konstantindenerz/k0d3ball35/README.md

# k0d3ball35

Read: **kodeball35**.

Designed and built by [Konstantin Denerz](https://konstantin-denerz.com) ·
[project page](https://konstantin-denerz.com/k0d3ball35/)

k0d3ball35 (kodeball35) is a wireless, low profile, 35-key split keyboard with an integrated 19 mm trackball.
Keyball-inspired column stagger and thumb arc, Kailh Choc V1 hot-swap switches, a nice!nano v2
on each half, ZMK firmware, two flat angular PCBs (18 keys left, 17 keys right) and the ball in a
case pocket right beside the thumb keys.

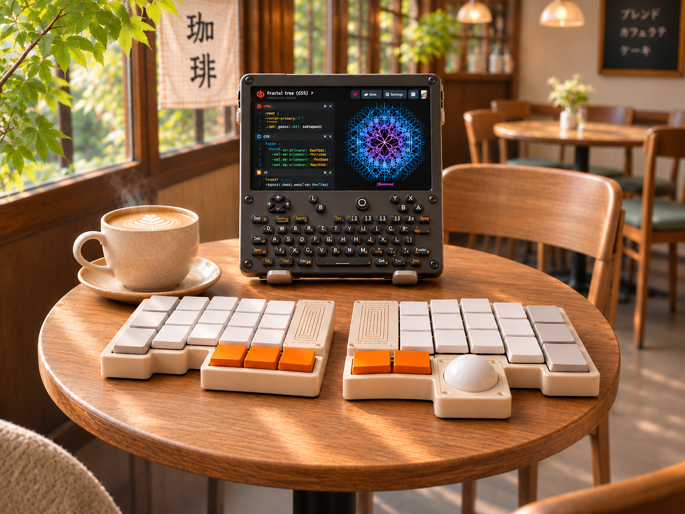
[picture p1: spec/images/concept-render.png]
k0d3ball35 concept render: both halves on a café table, trackball in the right half's case pocket


*Concept render, not a photo of a finished build.*

> ## ⚠️ Work in progress — do not build or order parts from this repository
>
> **k0d3ball35 is an unfinished design under active development. Nothing here has been
> manufactured, assembled or tested in hardware.**
>
> - No PCB in this repository has ever been fabricated, populated or electrically verified.
> - No case or cradle part has been printed and fit-checked against real switches, a real
>   trackball or a real battery.
> - Footprints, dimensions, the bill of materials and the firmware are all still changing, and
>   the geometry is revised between revisions without notice.
>
> **Do not send these gerbers to a fab, do not print these STLs, and do not buy components
> against this BOM.** If you do, you will very likely end up with parts that do not fit and
> money you cannot get back. Treat everything here as a design sketch to read, not a build
> guide to follow. Use at your own risk; there is no warranty of any kind.

## Status

| Subsystem | State | Where |
|---|---|---|
| Design specification | r2.4 (two PCBs, 35 keys, 19 mm ball pocket, battery bay under the controller on both halves) | [spec/01-design-spec.md](spec/01-design-spec.md) |
| Layout generator | r2.4 done, per-half outputs, exact coordinates in [spec/02-layout.md](spec/02-layout.md) | [hardware/layout](hardware/layout) |
| Left PCB (KiCad 10) | r2.4 routed, ERC and DRC clean, gerbers exported; battery bay on the back silkscreen | [hardware/left-pcb](hardware/left-pcb) |
| Right PCB (KiCad 10) | r2.4 routed, ERC and DRC clean, gerbers exported; battery bay on the back silkscreen | [hardware/right-pcb](hardware/right-pcb) |
| Trackball sensor | r2.4: bought PAW3222 module, no board of ours to fabricate; J1 re-ordered to the module's pinout | [spec/08-trackball-module.md](spec/08-trackball-module.md) |
| Trackball cradle | r2.4 pocket mount for 19.05 mm with the module tilted 65 degrees beside the ball, test print pending | [hardware/trackball-cradle](hardware/trackball-cradle) |
| Firmware (ZMK) | r2.4 in progress: 35 keys, one shared pin set | [firmware/zmk-config](firmware/zmk-config) |
| Documentation | build guide, firmware, fabrication, testing written for r2 | [docs](docs) |
| Case | printed tray, controller box cap, PCB guard, pocket cover and hinged lid per half (OpenSCAD); test print pending | [hardware/case](hardware/case), [spec/11-case.md](spec/11-case.md) |
| Tests and CI | pytest suite, workflows ready for GitHub | [tests](tests), [.github/workflows](.github/workflows) |

Open work is tracked as markdown tickets in [issues/](issues/README.md). The r2 change itself is
`hw-two-pcbs-r2`. Before the first PCB order, work through `hw-main-pcb-review-r1`,
`test-fab-gerber-viewer`, `hw-19mm-ball-sourcing` and a cradle test print (see
[spec/09-roadmap.md](spec/09-roadmap.md)).

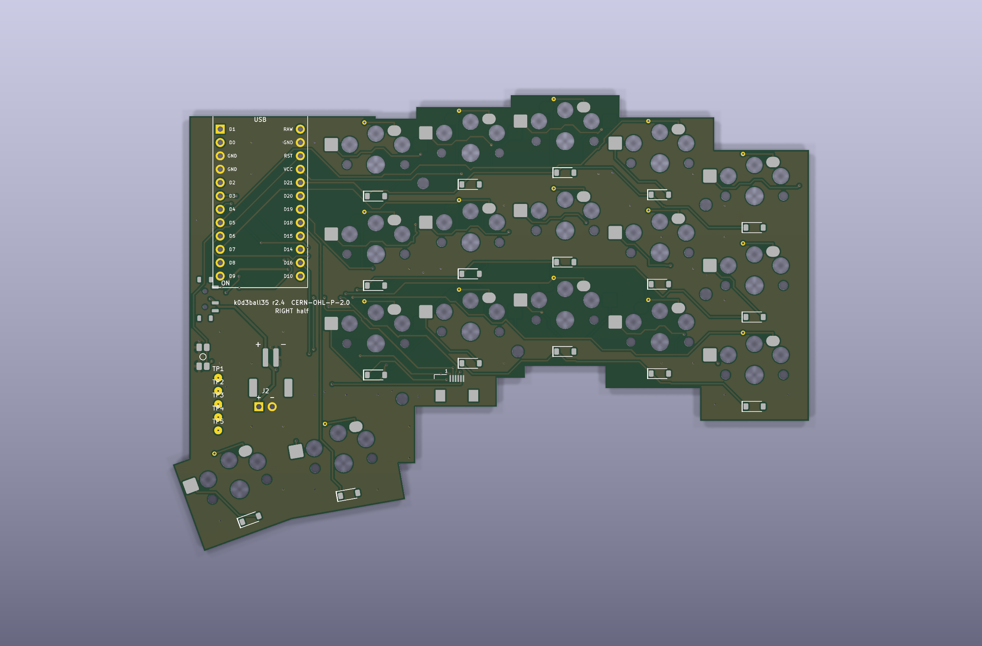
[picture p2: hardware/right-pcb/renders/right-pcb-top.png]
Right PCB, top


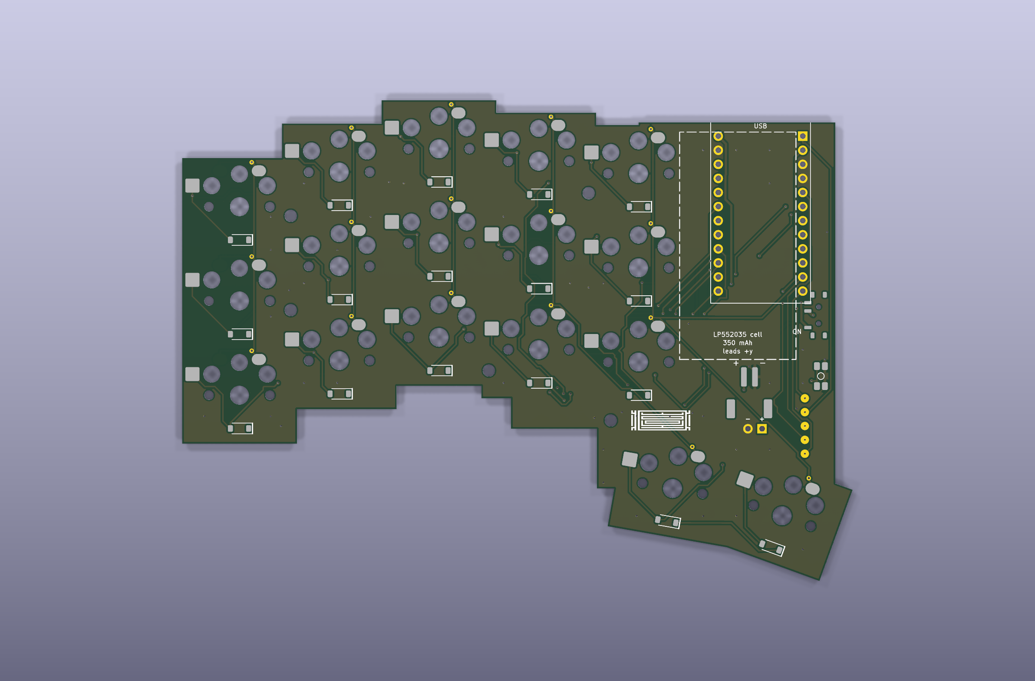
[picture p3: hardware/right-pcb/renders/right-pcb-bottom.png]
Right PCB, bottom


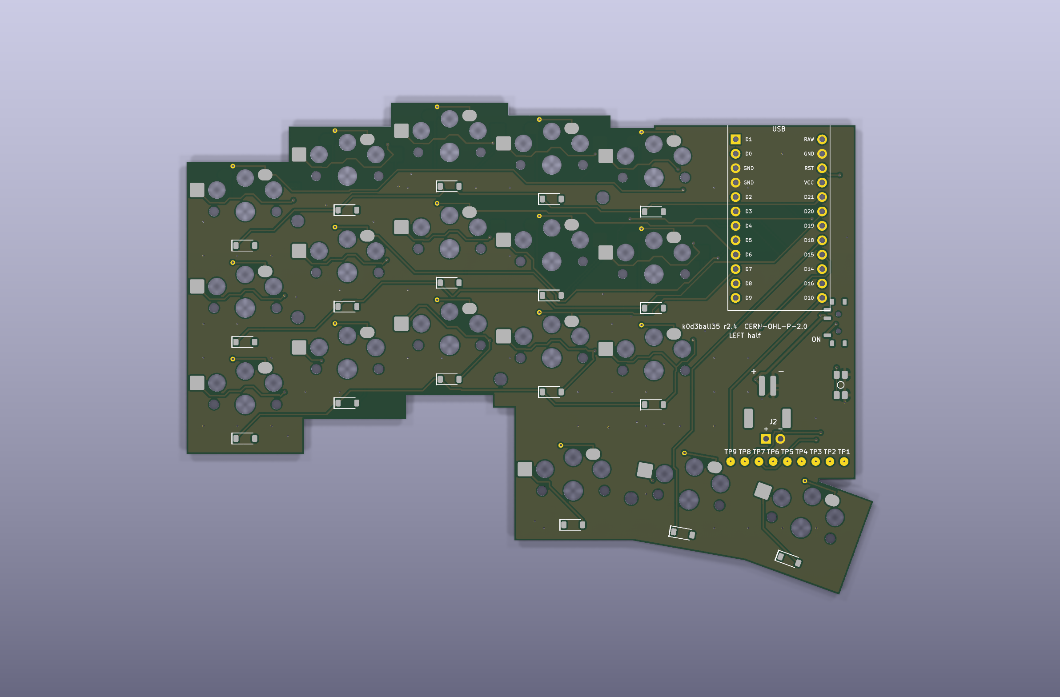
[picture p4: hardware/left-pcb/renders/left-pcb-top.png]
Left PCB, top


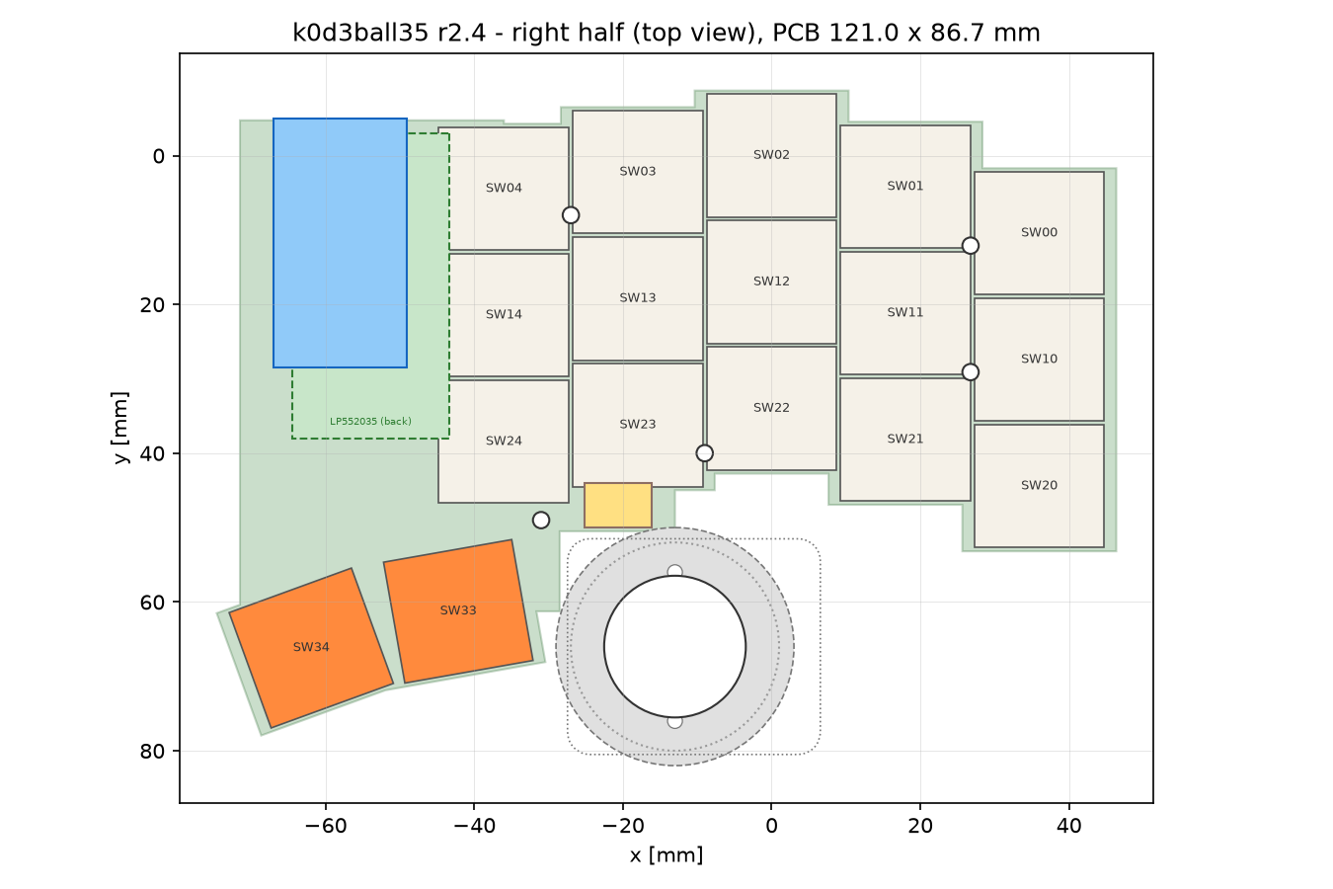
[picture p5: hardware/layout/output/preview-right.png]
Layout preview, right half


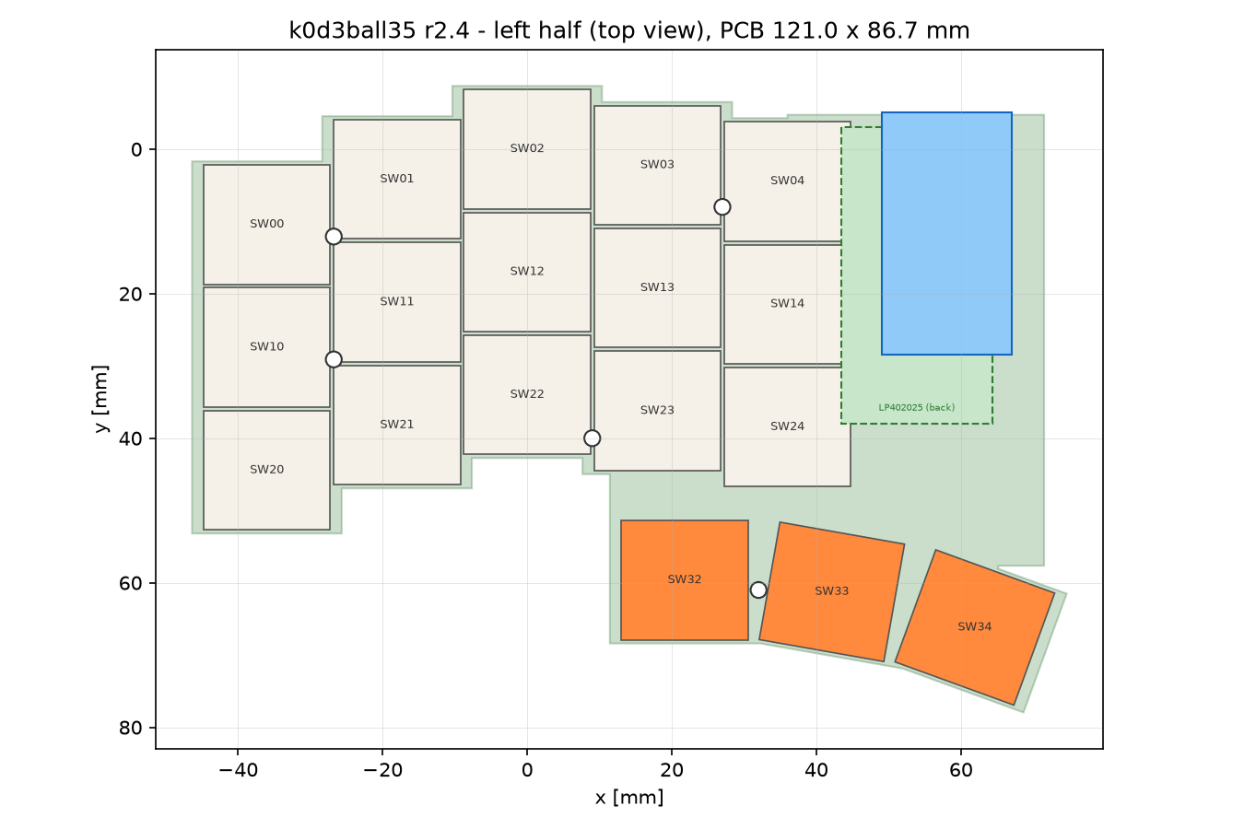
[picture p6: hardware/layout/output/preview-left.png]
Layout preview, left half


## Features

- 35 keys: 3 rows x 5 columns per half plus 3 thumb keys on the left and 2 on the right (the ball
  takes the third position), 18 x 17 mm pitch
- Column stagger and thumb arc derived from the Keyball39 geometry, scaled to Choc spacing
- Kailh Choc V1 switches in hot-swap sockets (hot-swap only, like the Keyball)
- 19.05 mm (3/4 inch) POM trackball on the right half, resting on three 2 mm ceramic balls in a
  printed cradle that stands in a case pocket beside the PCB; bought PAW3222 sensor module tilted
  65 degrees beside the ball, connected with a 6-pin flat cable
- Low: keycaps 20.8 mm over the desk, ball top 23.75 mm, 27.3 mm with the transport lid on
- Fully wireless: nice!nano v2 (or SuperMini nRF52840) per half on 2.5 mm low-profile sockets,
  Bluetooth split, one LiPo cell per half (350 mAh LP552035 right, 150 mAh LP402025 left) in a bay under the PCB below the
  controller (the same bay on both halves), the controller's charger, JST-PH connector, slide
  power switch, reset button
- Two separate PCBs with identical controller wiring: no solder jumpers, no mirrored pin maps,
  no empty ball cutout on the left
- Angular outline: 90 degree steps along the column stagger, rectangular controller block, no rounding
- No LEDs, display or encoder on the PCB, to keep the height and the power draw down
- ZMK firmware on a pinned `main` revision with the PAW3222 driver, automatic mouse layer,
  scroll and snipe modes, ZMK Studio
- All geometry comes from one layout file; schematic, PCB, footprints and tests are generated from the same data

## Repository map

```
spec/                 specification, layout, BOM, build guide, firmware, fabrication, testing
docs/                 the published project page (tabs: exploded view, case, trackball, PCBs, keymap, BOM)
hardware/layout/      layout source (yaml), generated points, outline DXFs and previews per half
hardware/left-pcb/    KiCad project of the left PCB (18 keys), gerbers and renders
hardware/right-pcb/   KiCad project of the right PCB (17 keys, FPC connector, pocket notch)
hardware/lib/         project symbol and footprint libraries
hardware/trackball-cradle/  parametric cradle (pocket mount), STL and floor-footprint DXF exports
hardware/case/        parametric printed case per half (tray, cap, guard, lid), STLs and previews
firmware/zmk-config/  ZMK shield, keymap, build matrix
scripts/              generators and checks (schematic, routing, export, tickets)
tests/                pytest suite incl. KiCad ERC/DRC gates
issues/               markdown tickets and the generated index
```

## Documentation

| Document | Content |
|---|---|
| [00 Feasibility](spec/00-feasibility.md) | prior art, ball size research, risks, licensing, why this design |
| [01 Design specification](spec/01-design-spec.md) | requirements, pin map, matrix, FPC interface, geometry contract |
| [02 Layout](spec/02-layout.md) | key coordinates per half, stagger derivation, ball pocket |
| [03 Bill of materials](spec/03-bom.md) | parts, quantities per half, sources |
| [04 Build guide](spec/04-build-guide.md) | step by step assembly |
| [05 Firmware](spec/05-firmware.md) | flashing, pairing, tuning, battery |
| [06 Fabrication](spec/06-fabrication.md) | PCB order settings for both boards, gerber checklist |
| [07 Testing](spec/07-testing.md) | automated checks and bench procedure |
| [08 Trackball module](spec/08-trackball-module.md) | sensor module, cable, heights, pocket mount |
| [09 Roadmap](spec/09-roadmap.md) | verification before ordering, case, dongle, sensor variants |
| [10 Lessons from Keyball](spec/10-lessons-from-keyball.md) | holykeebs and Yowkees designs, known weaknesses and our response |
| [11 Printed case](spec/11-case.md) | tray, controller box cap, ball pocket, hinged lid as transport cover and tenting foot |
| [12 Order checklist](spec/12-order-checklist.md) | shop-by-shop parts list, what is ordered, JLCPCB and LCSC lines, printed parts, what waits for hardware |
| [Image prompts](spec/images/PROMPTS.md) | every picture as a generation prompt |

## Project page

The project page, [`docs/index.html`](docs/index.html), is published with GitHub Pages from
`docs/` on `main`. One tab per area: an overview, the interactive 3D exploded view of both halves
(explode slider, half switch, section through the ball, lid modes), the real printed parts of the
case and the trackball cradle, the three boards in 3D and as layer plots and the keymap. The page
shows the files; the markdown keeps the details, and the overview links to it.

The page is static; every file it loads carries a content hash (`?v=`, stamped by `make site`), so a visit never mixes cached files of two versions. It shows the real files: STLs and the KiCad GLBs are fetched from the
repository (raw.githubusercontent.com, branch `main`), nothing is copied into `docs/`. The data the
tabs need (layout, part facts, keymap, board facts) is generated into `docs/data/` by
`docs/build.py`: run `make site` after a change to the layout, the case, the boards, the keymap,
the BOM or the tickets; `tests/test_site.py` fails while the data is stale. `make site-serve`
serves the page with the files of the working tree at http://localhost:8000/docs/, which previews
a branch before it is merged.

## Quick start

```sh
brew install --cask kicad          # KiCad 10.0.7 (copy the app from the DMG if the cask asks for admin rights)
brew install openjdk               # Java for freerouting
brew install --cask openscad@snapshot   # OpenSCAD with the manifold backend, for the case and cradle
uv venv .venv && uv pip install --python .venv/bin/python -e ".[test]"
make freerouting-jar               # downloads freerouting 2.5.0 to build/
make test                          # full test suite
```

## Build the hardware files

Everything under `hardware/left-pcb/` and `hardware/right-pcb/` is generated; edit
`hardware/layout/k0d3ball35.yaml` and `scripts/k0d3/` instead of the KiCad files.

```sh
make layout                                   # points-*.json, outline-*.dxf, previews for both halves
JAVA=/opt/homebrew/opt/openjdk/bin/java \
FREEROUTING_JAR=build/freerouting.jar \
make sch pcb route gerbers                    # both halves: schematic + ERC, PCB, freerouting, DRC, export
scripts/build_board.sh right                  # one half: schematic + ERC, unrouted PCB, freerouting, DRC (retries until clean)
scripts/export.sh right                       # one half: gerbers, drill, zip, STEP, renders, schematic PDF, BOM, position file
make erc drc                                  # the KiCad gates on their own
make -C hardware/trackball-cradle             # cradle STLs, floor DXF, previews, stack.json
make case-data case                           # hardware/case: data.scad from the layout, tray/cap/lid STLs, previews, stack.json (needs OpenSCAD)
```

`HALVES=right make route` limits the looping targets to one half. `scripts/build_board.sh` expects
`kicad-cli` and KiCad's bundled Python at
`/Applications/KiCad/KiCad.app/Contents/MacOS/kicad-cli` and
`/Applications/KiCad/KiCad.app/Contents/Frameworks/Python.framework/Versions/Current/bin/python3`;
override with `KICAD_CLI=` and `KPY=`. Since r2.4 the two halves are the only KiCad projects in
the repository: the trackball sensor is a bought PAW3222 module, so there is nothing to generate
or fabricate for it.

Firmware is built by GitHub Actions from `firmware/zmk-config`; see
[spec/05-firmware.md](spec/05-firmware.md) for local builds and flashing.

```prompt
Top-down studio render of the right half of a low profile split keyboard, white background, soft
shadows. Bare black PCB with an angular, stepped outline, 17 Kailh Choc hot-swap sockets, small
SOD-123 diodes next to each key, two thumb key positions at the lower inner side and the ball
pocket where a third would be, a nice!nano
controller on low profile sockets in a rectangular block at the inner edge, a dashed rectangle
printed on the board under it marking the battery bay on the other face, an octagonal notch in the lower outer edge of the board where a beige
printed cradle holding a white 19 mm ball stands beside the PCB, a tiny flat flex cable running
from the cradle round the cup to a connector on the PCB. Clean, technical, product photography style.
```

## Credits

- [Keyball](https://github.com/Yowkees/keyball) by Yowkees: the column stagger, thumb arc and the
  idea of a trackball at the thumb are the design inspiration. No Keyball files are used.
- [torabo-tsuki-lp](https://github.com/sekigon-gonnoc/torabo-tsuki-lp) by sekigon-gonnoc: reference
  for a low profile trackball with 25 and 19.05 mm POM balls and the PAW3222 module on a flat cable.
- [LiNEA40](https://github.com/keyfreaks/LiNEA40) by keyfreaks: precedent for a 19 mm ball on a PMW3610.
- [roBa](https://github.com/kumamuk-git/roBa) by kumamuk: reference for a ZMK trackball split with
  PMW3610.
- [kiswitch](https://github.com/kiswitch/kiswitch) and [marbastlib](https://github.com/ebastler/marbastlib):
  switch, socket and controller footprints.
- [ZMK](https://zmk.dev) and sekigon-gonnoc's PAW3222 driver (`zmk-driver-paw3222`).

```prompt
Three quarter view close-up of the trackball pocket on the right half: a matte white 19 mm ball
sitting low in a round pocket of a boxy beige 3D printed case, in line with two burnt orange thumb
keycaps to its left, the ball top only a little higher than the keycaps, three tiny ceramic balls just visible
at the rim of the beige cradle, light grey Choc keycaps behind, the angular stepped case edge
visible. Oak desk, soft daylight, macro lens, shallow depth of field.
```

## License

Copyright (c) 2026 Konstantin Denerz.

Firmware, scripts and documentation: [MIT](LICENSE).
Hardware (everything under `hardware/`): [CERN-OHL-P-2.0](LICENSE-HARDWARE).

The `kode` wordmark on the PCB silkscreen, the case and the project page is the author's mark and
is not covered by either licence; a fork keeps the design files and replaces the artwork. See
[NOTICE](NOTICE).
