konstantindenerz/k0d3ball35/docs/img/share-card-cafe.jpg

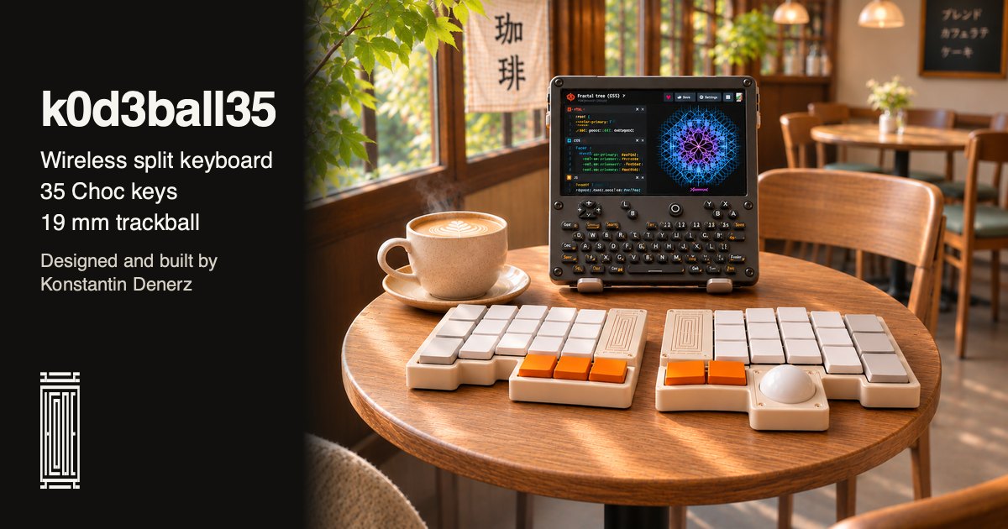
docs/img/share-card-cafe.jpg
