konstantindenerz/k0d3ball35/hardware/case/preview/box-right.png

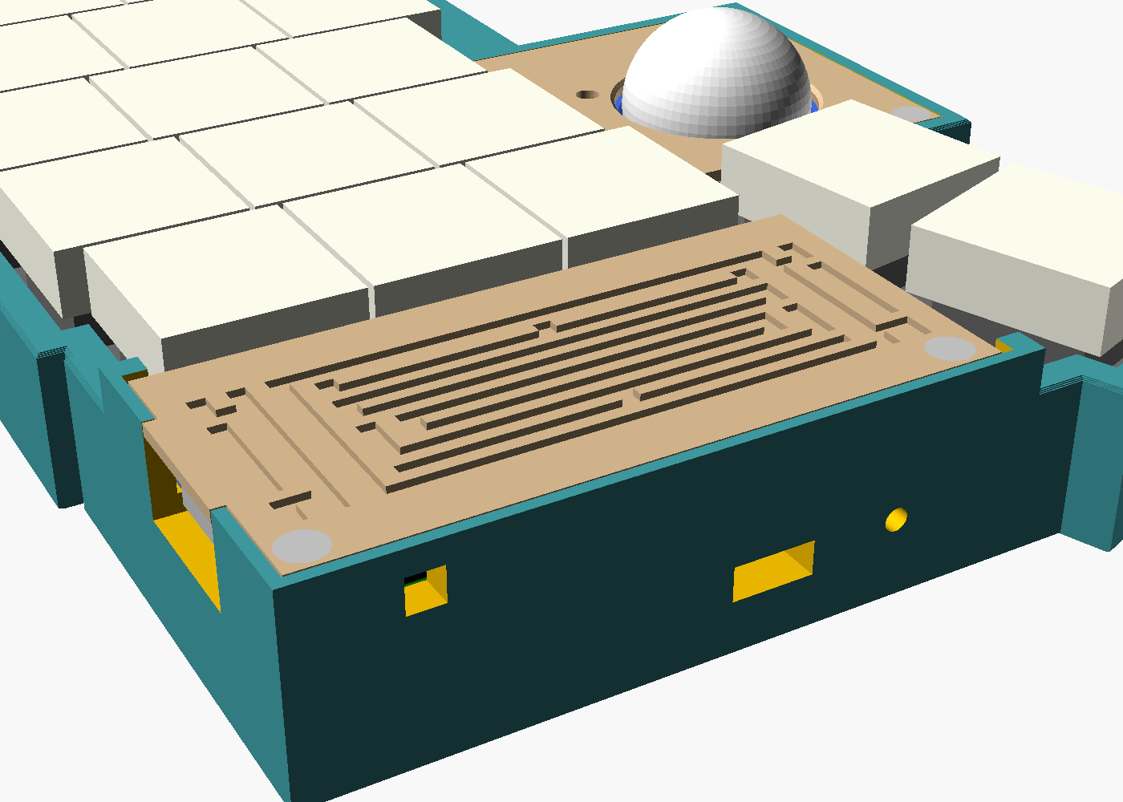
hardware/case/preview/box-right.png
