konstantindenerz/k0d3ball35/hardware/case/preview/clip-right.png

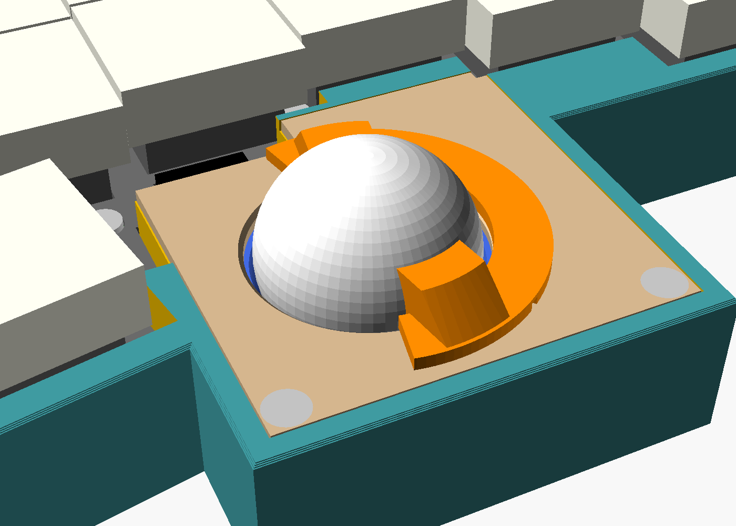
hardware/case/preview/clip-right.png
