konstantindenerz/k0d3ball35/hardware/case/preview/lid-folded-right.png

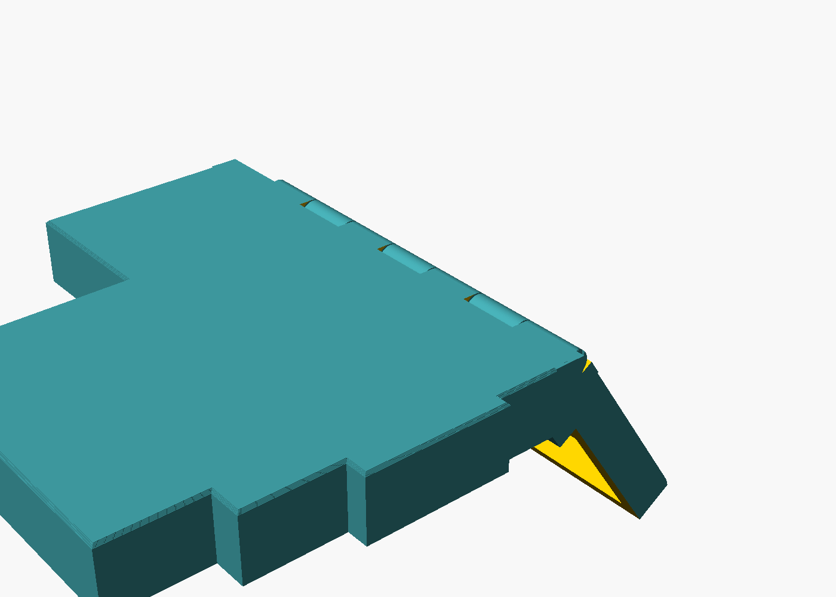
hardware/case/preview/lid-folded-right.png
