konstantindenerz/k0d3ball35/hardware/case/preview/lid-foot-right.png

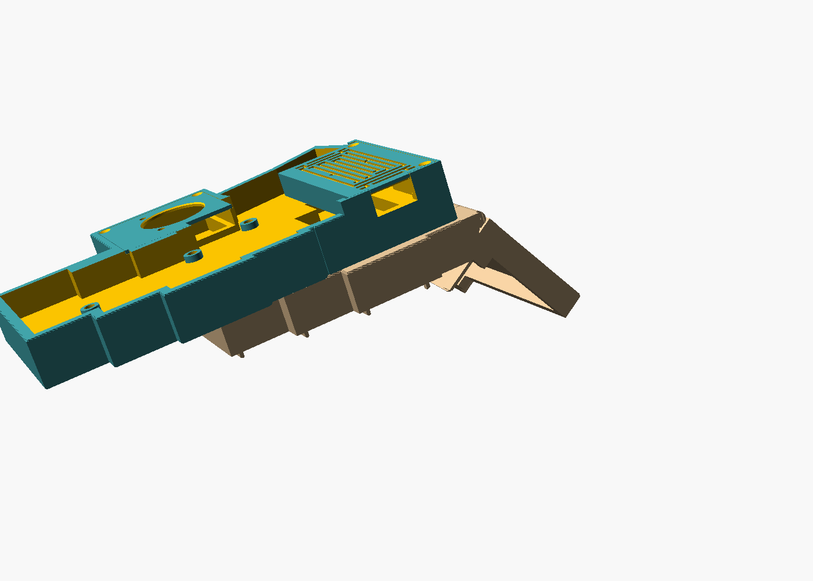
hardware/case/preview/lid-foot-right.png
