konstantindenerz/k0d3ball35/hardware/case/preview/lid-hinge-right.png

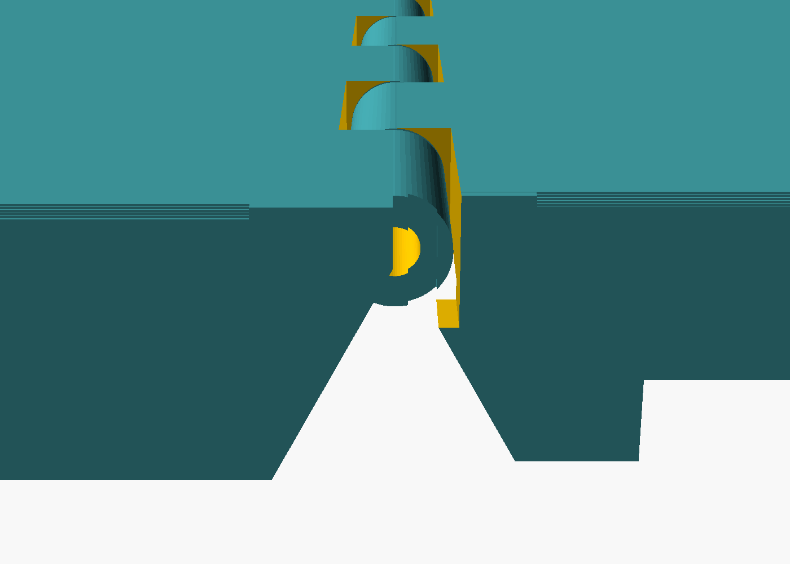
hardware/case/preview/lid-hinge-right.png
