konstantindenerz/k0d3ball35/hardware/case/preview/lid-on-right.png

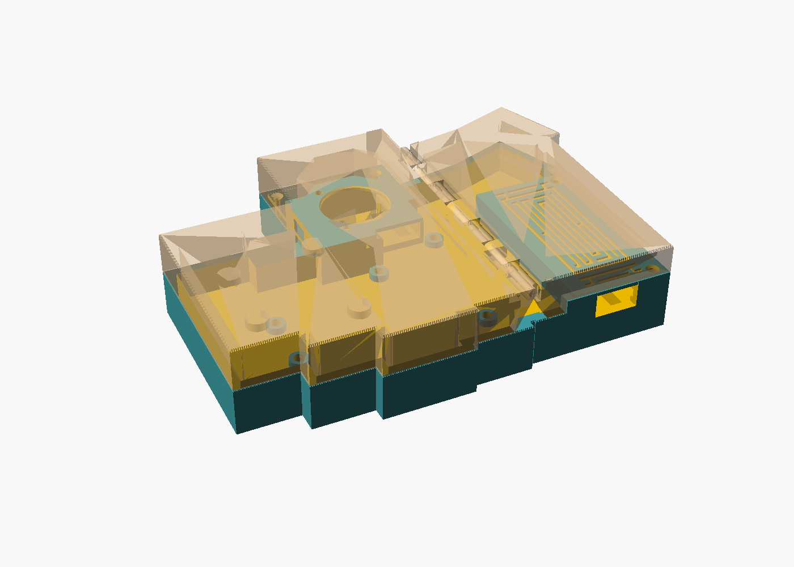
hardware/case/preview/lid-on-right.png
