konstantindenerz/k0d3ball35/hardware/case/preview/section-right.png

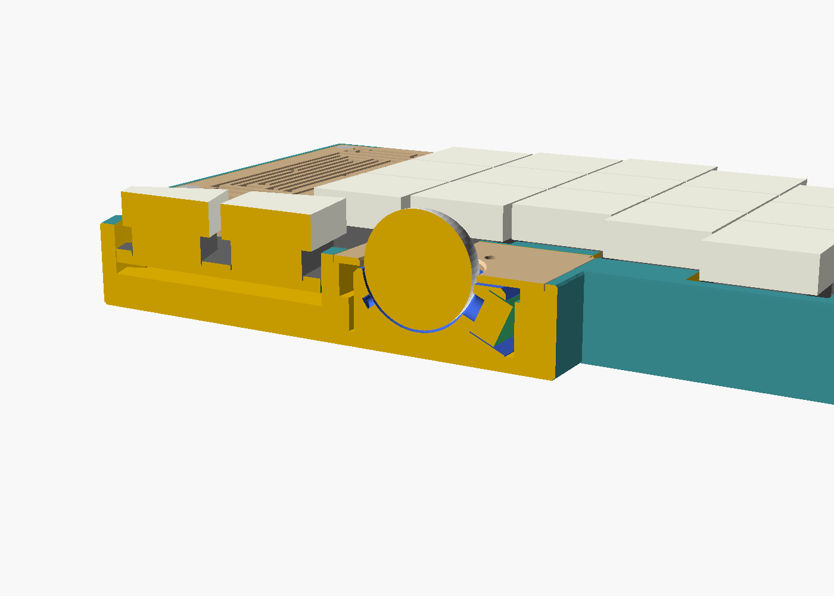
hardware/case/preview/section-right.png
