konstantindenerz/k0d3ball35/hardware/case/preview/tray-bottom-right.png

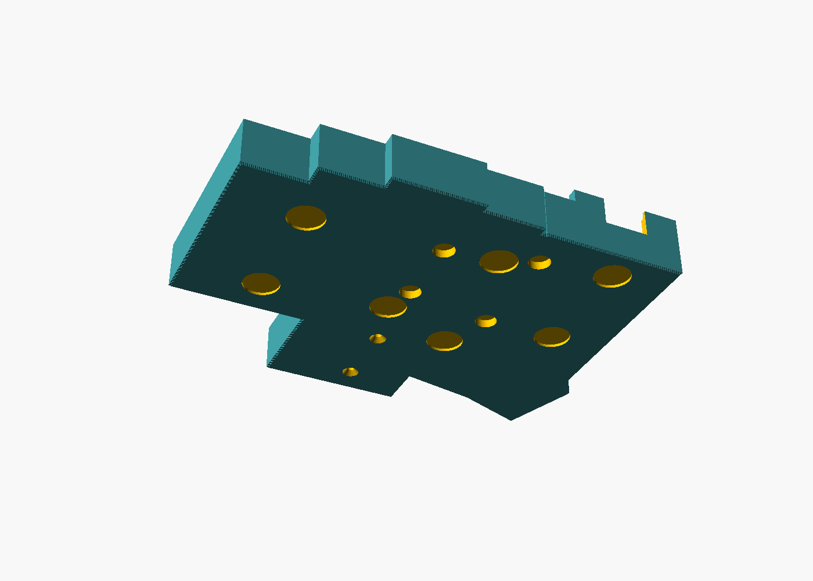
hardware/case/preview/tray-bottom-right.png
