konstantindenerz/k0d3ball35/hardware/left-pcb/renders/left-pcb-bottom.png

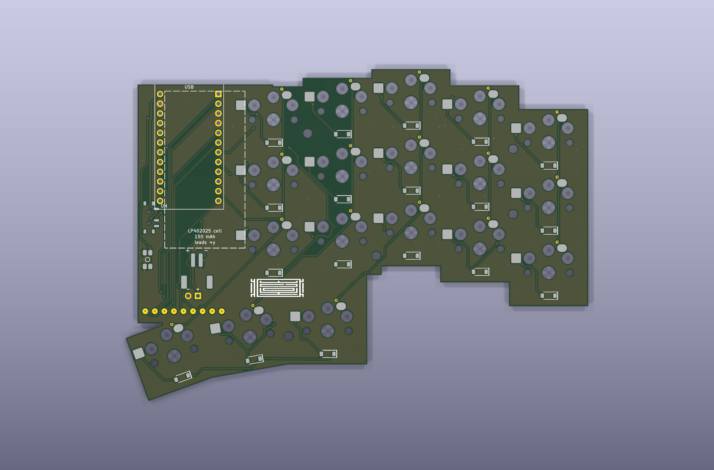
hardware/left-pcb/renders/left-pcb-bottom.png
