konstantindenerz/k0d3ball35/hardware/trackball-cradle/preview/cradle-19mm-pocket.png

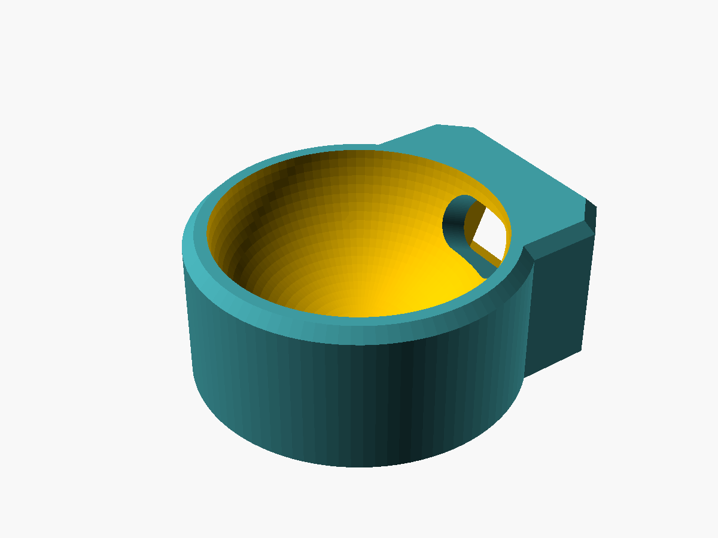
hardware/trackball-cradle/preview/cradle-19mm-pocket.png
