konstantindenerz/k0d3ball35/issues/hw-fpc-connector-bom-mismatch.md

---
title: BOM listed FH19SC while the footprint is FH12-6S
type: bug
priority: P2
status: done
area: hw
created: 2026-11-05
---

# BOM listed FH19SC while the footprint is FH12-6S

## Context

spec/03-bom.md listed the Hirose FH19SC-6S-0.5SH connector while both boards use the FH12-6S-0.5SH footprint (0.5 mm, 6 contacts, bottom contact, ZIF slider).

## Acceptance criteria

- [x] spec/03-bom.md names FH12-6S-0.5SH for both boards, LCSC equivalents allowed
- [x] spec/01-design-spec.md section 3 names the same family

## Notes

Fixed 2026-11-05.
