konstantindenerz/k0d3ball35/hardware/right-pcb/k0d3ball35-right-bom.csv

Reference | Value | Footprint | QUANTITY | Description
D00-D04,D10-D14,D20-D24,D33,D34 | 1N4148W | k0d3ball35:D_SOD-123_reversible | 17 | 1N4148W SOD-123, pads on both sides
J1 | FH12-6S-0.5SH | k0d3ball35:FPC_0.5mm_6P_FH12-6S_top | 1 | Trackball sensor module, 6-pin 0.5 mm FPC, top side
J2 | BAT | k0d3ball35:BatteryPads_2x1.8mm_P2.54mm | 1 | Battery solder pads, B+ / B-
J3 | S2B-PH-SM4-TB | k0d3ball35:JST_PH_S2B-PH-SM4-TB_reversible | 1 | Optional JST-PH 2.0 battery connector, bottom side
PS1 | MSK12C02 | k0d3ball35:SW_SPDT_MSK12C02_reversible | 1 | Power slide switch in the battery positive line, bottom side
RB1 | EVQ-P7A01P | k0d3ball35:SW_SPST_EVQP7A_reversible | 1 | Reset button, bottom side
SW00-SW04,SW10-SW14,SW20-SW24,SW33,SW34 | Choc V1 | k0d3ball35:SW_Choc_V1_HS_reversible | 17 | Kailh Choc V1 switch, hot-swap socket on the back
TP1 | TP_D0 | k0d3ball35:TestPad_1.5mm | 1 | Spare controller pin D0
TP2 | TP_D1 | k0d3ball35:TestPad_1.5mm | 1 | Spare controller pin D1
TP3 | TP_D2 | k0d3ball35:TestPad_1.5mm | 1 | Spare controller pin D2
TP4 | TP_D3 | k0d3ball35:TestPad_1.5mm | 1 | Spare controller pin D3
TP5 | TP_D9 | k0d3ball35:TestPad_1.5mm | 1 | Spare controller pin D9
U1 | nice!nano v2 | k0d3ball35:nice_nano_v2_THT | 1 | nice!nano v2 / SuperMini nRF52840 on 2.54 mm sockets, component side up, USB at the top
