konstantindenerz/k0d3ball35/hardware/case/stl/pcb-test-left.stl

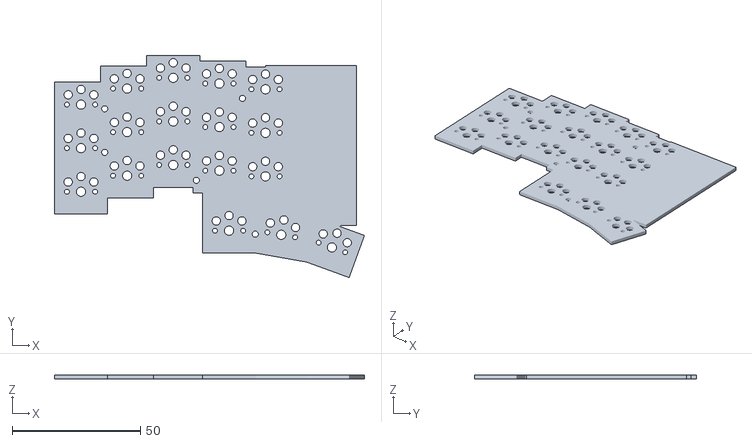
[picture p18: CAD file, 2026-11-12]
hardware/case/stl/pcb-test-left.stl
121.0 x 86.7 x 1.60
