konstantindenerz/k0d3ball35/hardware/layout/output/outline-right.dxf

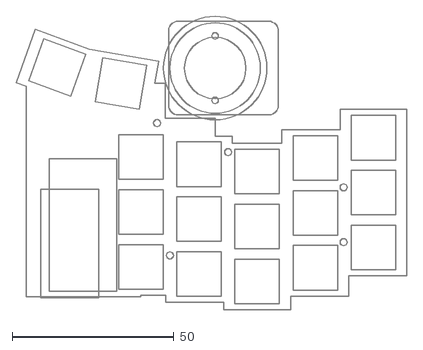
[picture p19: CAD file, 2026-11-12]
hardware/layout/output/outline-right.dxf
121.0 x 90.8
