konstantindenerz/k0d3ball35/hardware/left-pcb/k0d3ball35-left.step

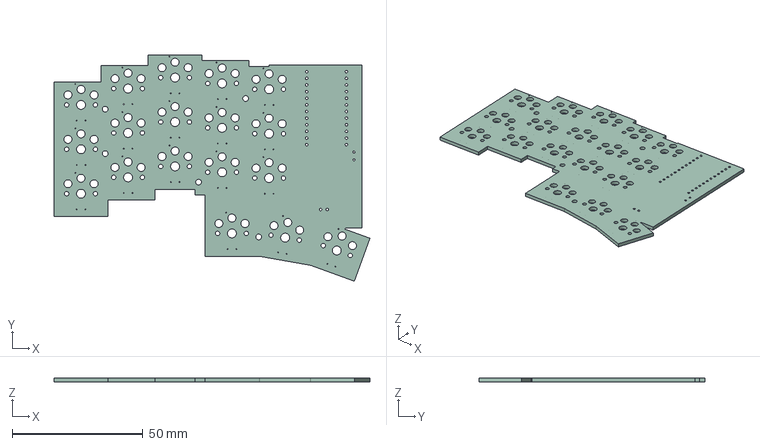
[picture p20: CAD file, 2026-11-12]
hardware/left-pcb/k0d3ball35-left.step
121.0 x 86.7 x 1.51 mm
