konstantindenerz/k0d3ball35/hardware/right-pcb/k0d3ball35-right.step

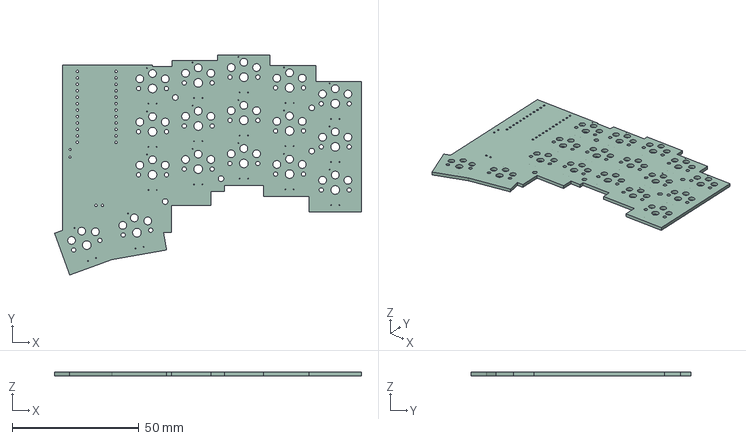
[picture p21: CAD file, 2026-11-12]
hardware/right-pcb/k0d3ball35-right.step
121.0 x 86.7 x 1.51 mm
