konstantindenerz/k0d3ball35/hardware/trackball-cradle/ref/sensor-module.stl

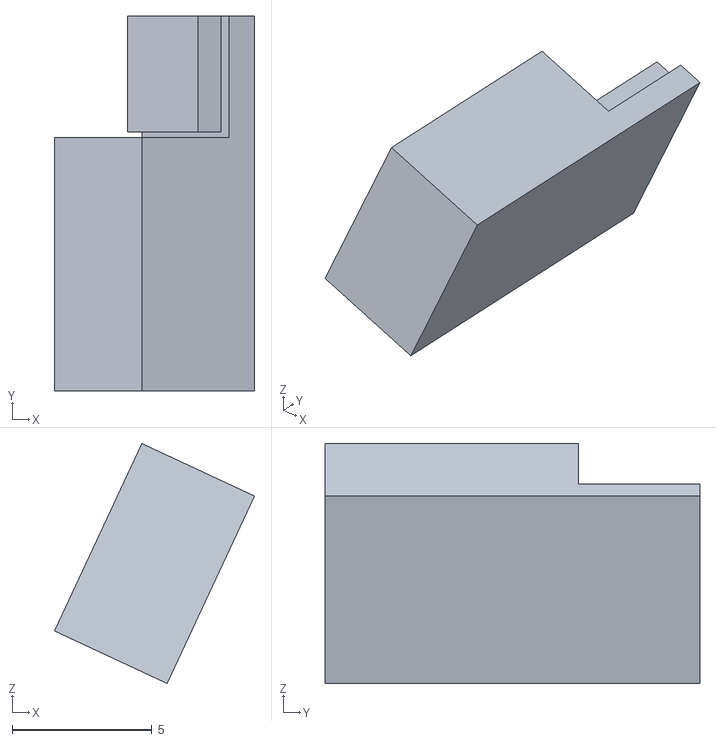
[picture p22: CAD file, 2026-11-12]
hardware/trackball-cradle/ref/sensor-module.stl
7.16 x 13.4 x 8.59
