konstantindenerz/k0d3ball35/hardware/trackball-cradle/stl/ball-19mm-test-half.stl

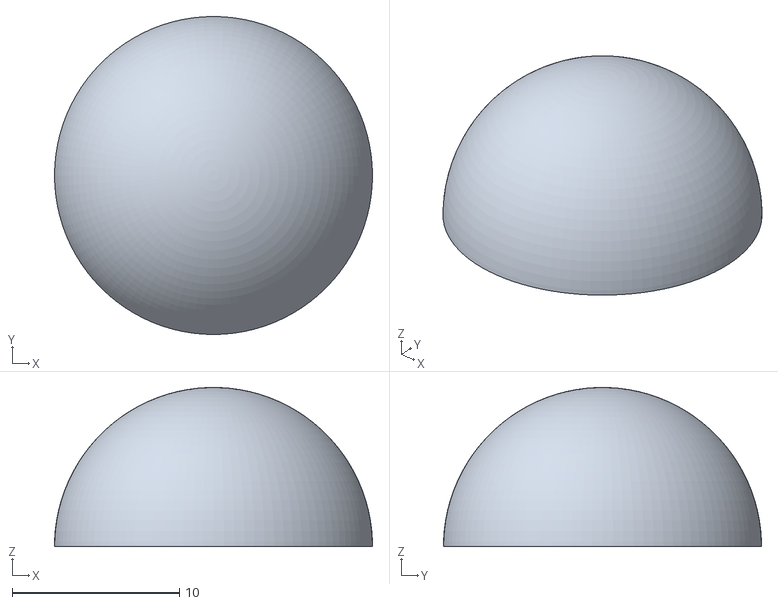
[picture p23: CAD file, 2026-11-12]
hardware/trackball-cradle/stl/ball-19mm-test-half.stl
19.0 x 19.0 x 9.52
