konstantindenerz/k0d3ball35/hardware/case/stl/pcb-test-right.stl

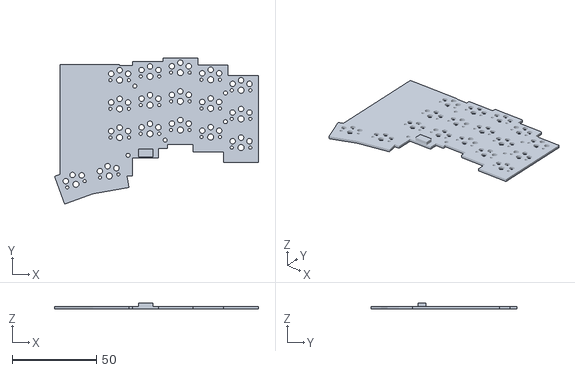
[picture p24: CAD file, 2026-11-12]
hardware/case/stl/pcb-test-right.stl
121.0 x 86.7 x 3.60
