konstantindenerz/k0d3ball35/hardware/layout/output/outline-left.dxf

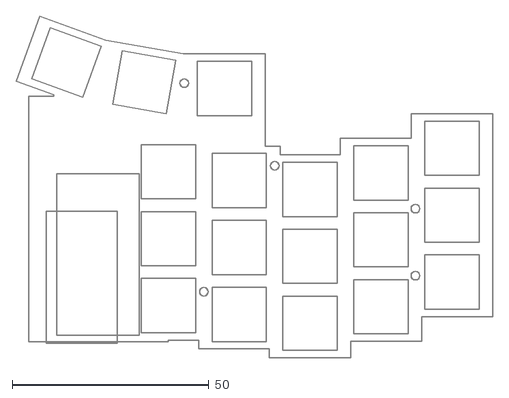
[picture p25: CAD file, 2026-11-12]
hardware/layout/output/outline-left.dxf
121.0 x 86.7
