konstantindenerz/k0d3ball35/hardware/trackball-cradle/stl/cradle-19mm-pocket.stl

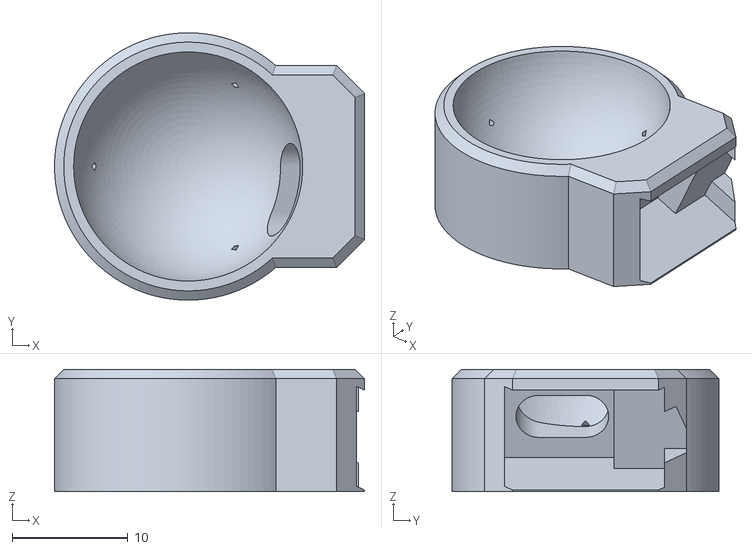
[picture p26: CAD file, 2026-11-12]
hardware/trackball-cradle/stl/cradle-19mm-pocket.stl
26.7 x 23.0 x 10.5
