konstantindenerz/k0d3ball35/hardware/case/stl/box-cap-left.stl

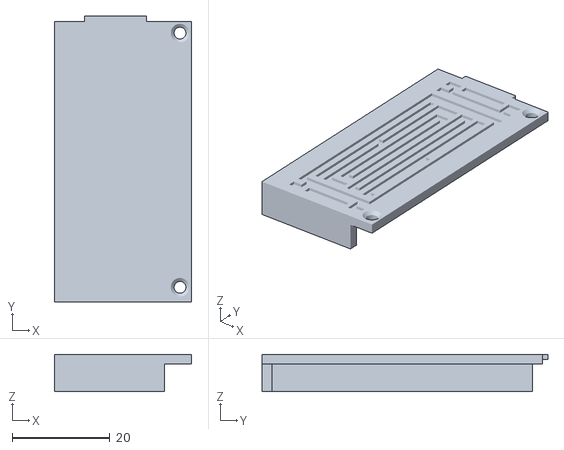
[picture p27: CAD file, 2026-11-12]
hardware/case/stl/box-cap-left.stl
28.0 x 58.6 x 7.60
