konstantindenerz/k0d3ball35/hardware/case/stl/tray-left.stl

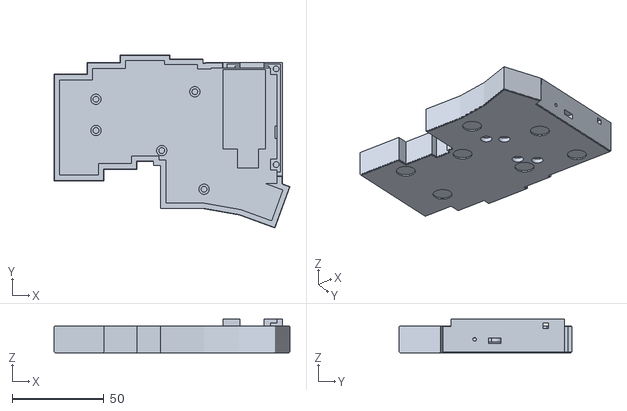
[picture p28: CAD file, 2026-11-12]
hardware/case/stl/tray-left.stl
128.3 x 94.0 x 18.3
