konstantindenerz/k0d3ball35/hardware/case/stl/tray-right.stl

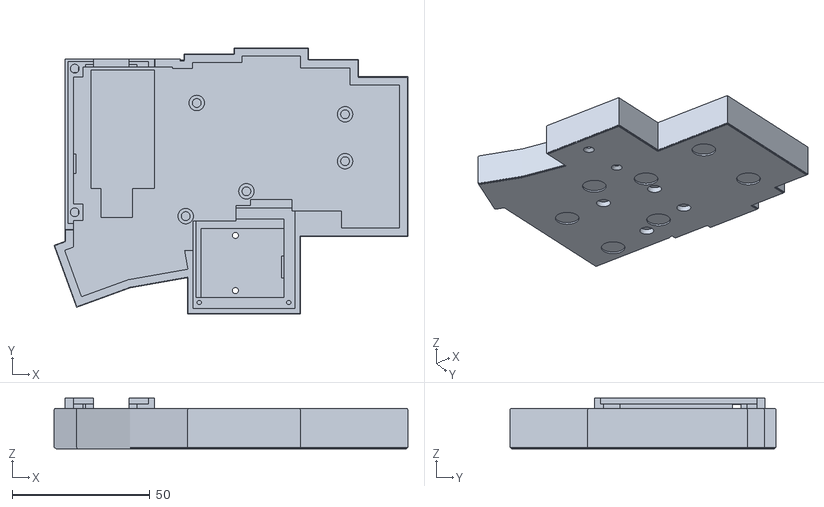
[picture p29: CAD file, 2026-11-12]
hardware/case/stl/tray-right.stl
128.3 x 96.5 x 18.3
