konstantindenerz/k0d3ball35/hardware/case/stl/lid-inner-right.stl

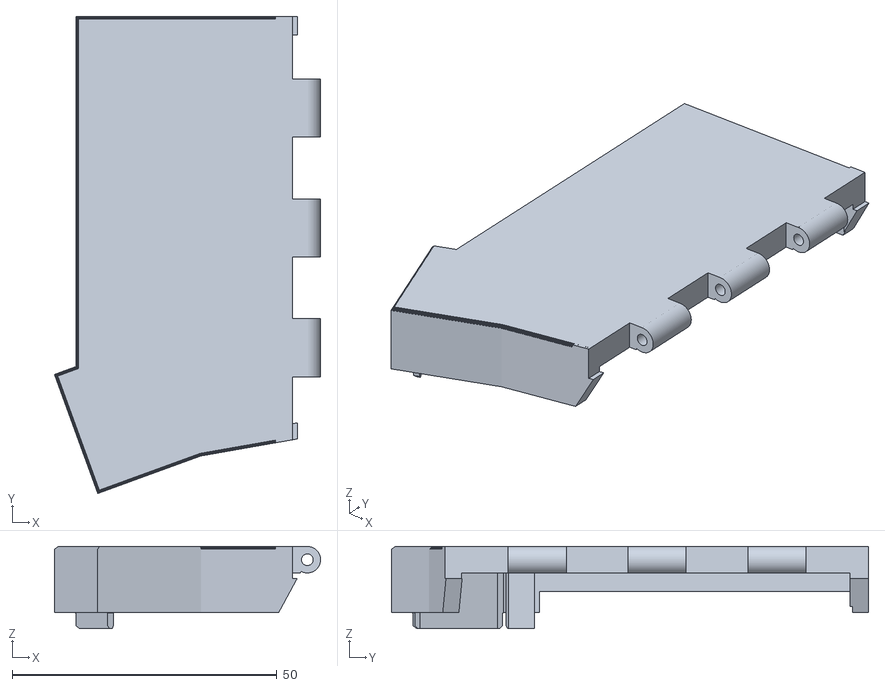
[picture p30: CAD file, 2026-11-12]
hardware/case/stl/lid-inner-right.stl
50.2 x 90.0 x 15.5
