konstantindenerz/k0d3ball35/hardware/case/stl/lid-folded-left.stl

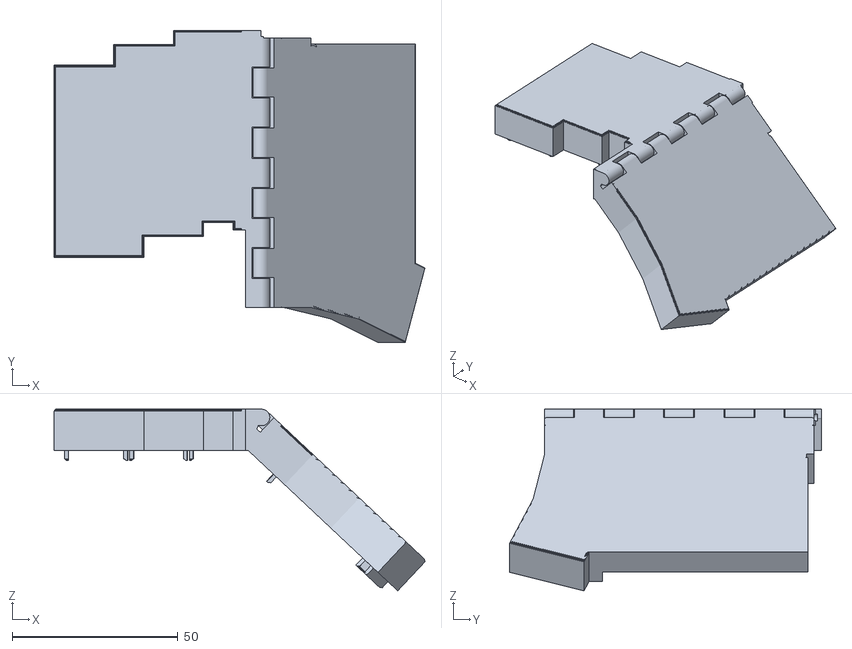
[picture p31: CAD file, 2026-11-12]
hardware/case/stl/lid-folded-left.stl
111.8 x 94.0 x 54.8
