konstantindenerz/k0d3ball35/hardware/case/stl/lid-outer-right.stl

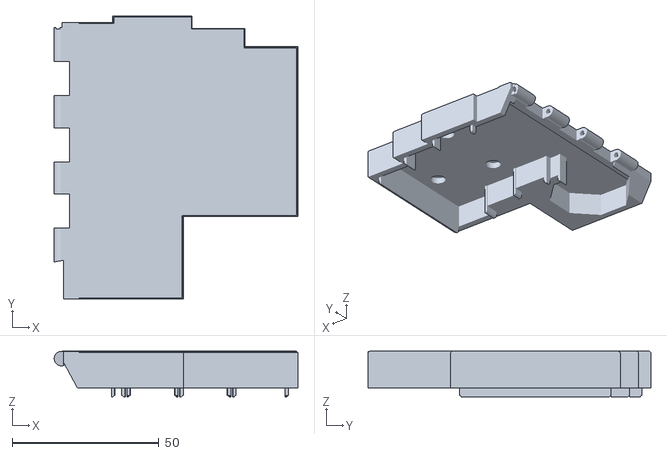
[picture p32: CAD file, 2026-11-12]
hardware/case/stl/lid-outer-right.stl
83.1 x 96.5 x 15.5
