konstantindenerz/k0d3ball35/hardware/case/stl/lid-left.stl

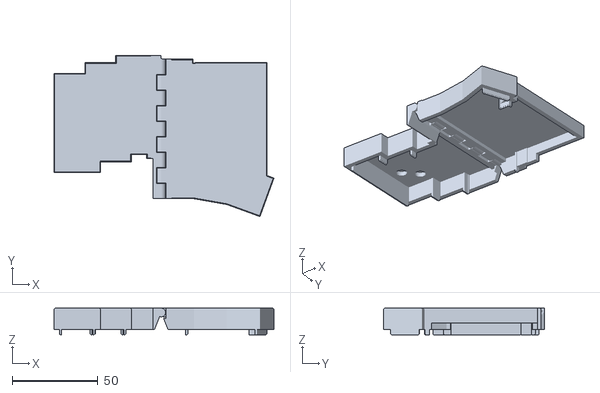
[picture p33: CAD file, 2026-11-12]
hardware/case/stl/lid-left.stl
128.3 x 94.0 x 15.5
