konstantindenerz/k0d3ball35/hardware/case/stl/lid-right.stl

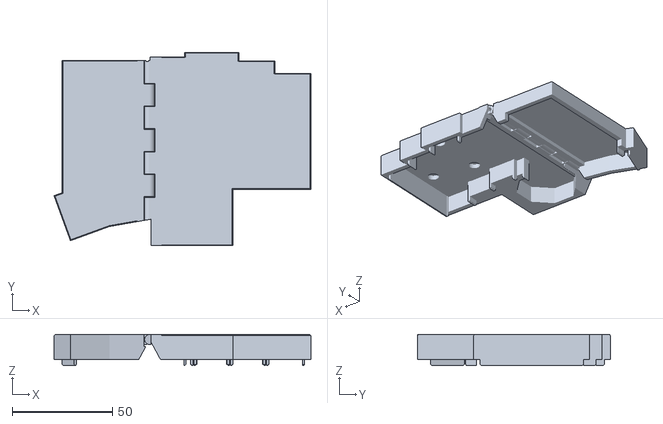
[picture p34: CAD file, 2026-11-12]
hardware/case/stl/lid-right.stl
128.3 x 96.5 x 15.5
