konstantindenerz/k0d3ball35/hardware/case/stl/lid-inner-left.stl

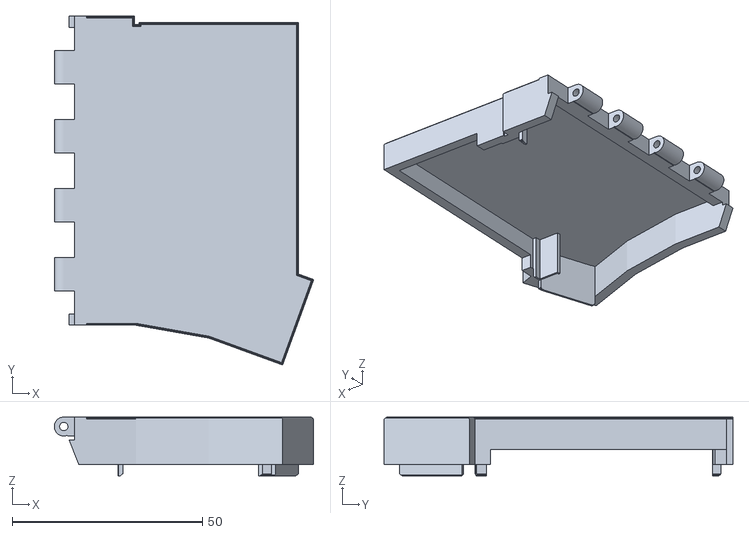
[picture p35: CAD file, 2026-11-12]
hardware/case/stl/lid-inner-left.stl
68.2 x 91.8 x 15.5
