konstantindenerz/k0d3ball35/hardware/case/stl/lid-folded-right.stl

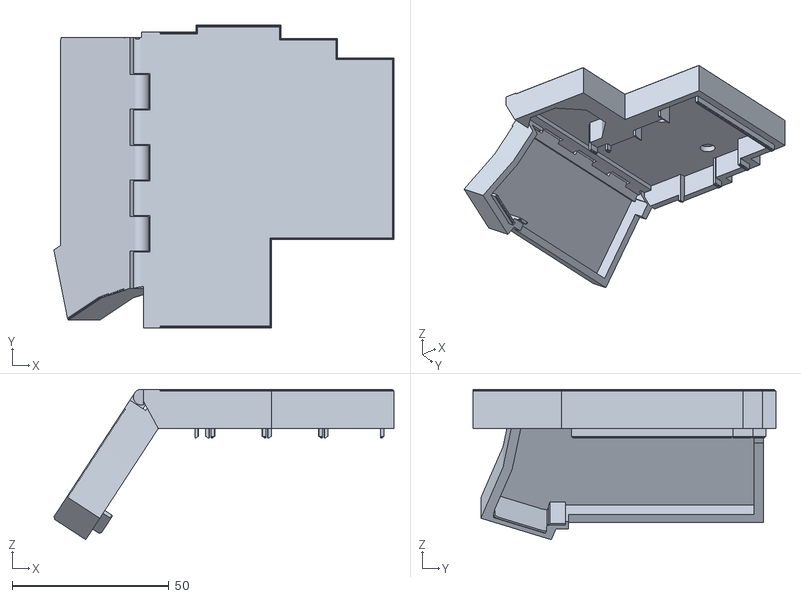
[picture p36: CAD file, 2026-11-12]
hardware/case/stl/lid-folded-right.stl
108.4 x 96.5 x 48.0
