konstantindenerz/k0d3ball35/hardware/case/stl/lid-outer-left.stl

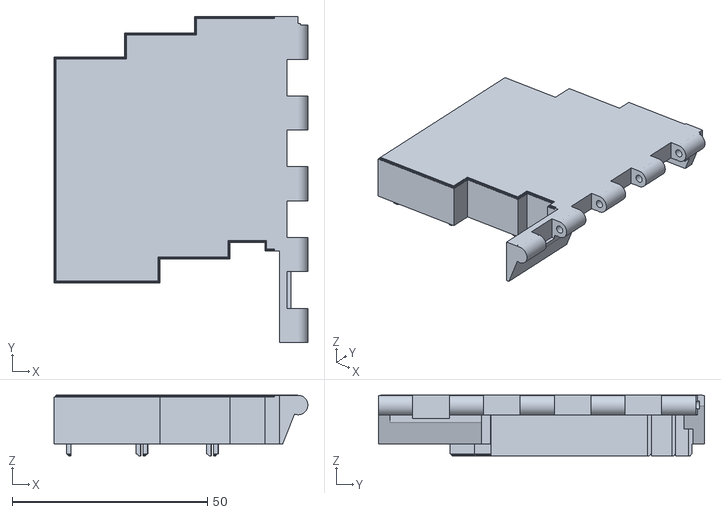
[picture p37: CAD file, 2026-11-12]
hardware/case/stl/lid-outer-left.stl
65.1 x 83.6 x 15.5
