konstantindenerz/k0d3ball35/hardware/case/stl/pocket-test-right.stl

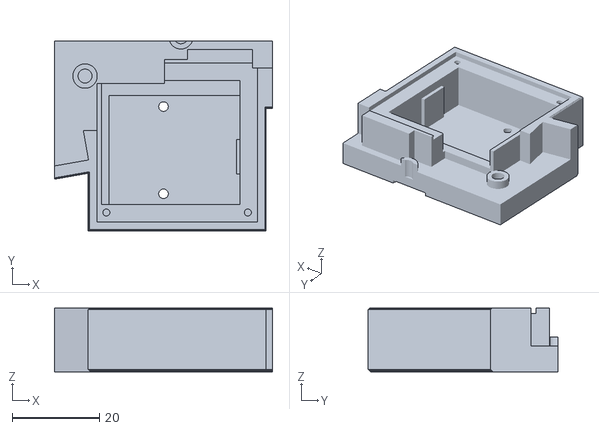
[picture p38: CAD file, 2026-11-12]
hardware/case/stl/pocket-test-right.stl
50.0 x 43.5 x 14.6
