konstantindenerz/k0d3ball35/hardware/case/stl/guard-left.stl

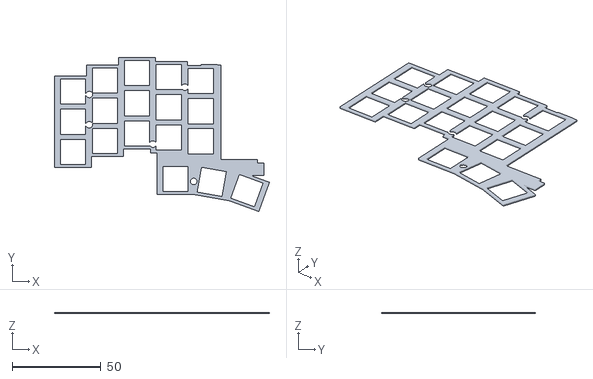
[picture p39: CAD file, 2026-11-12]
hardware/case/stl/guard-left.stl
121.0 x 86.7 x 0.8
