konstantindenerz/k0d3ball35/hardware/case/stl/guard-right.stl

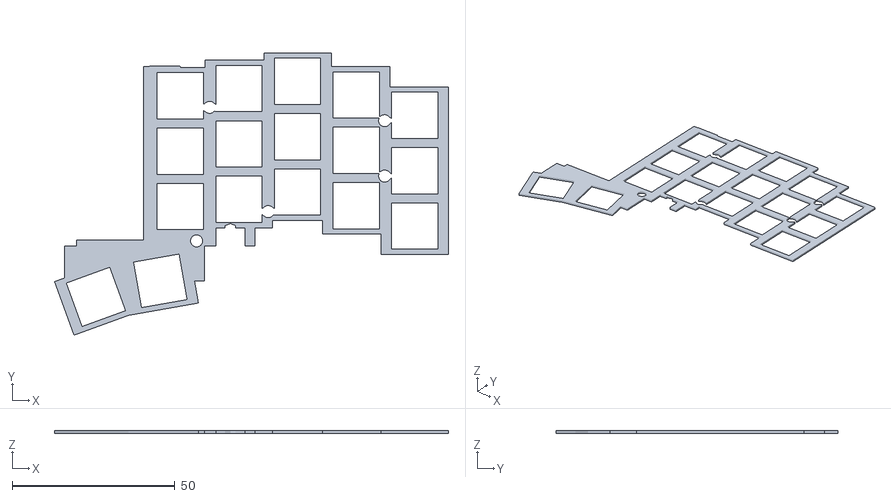
[picture p40: CAD file, 2026-11-12]
hardware/case/stl/guard-right.stl
121.0 x 86.7 x 0.8
