konstantindenerz/k0d3ball35/hardware/case/stl/pocket-cover-right.stl

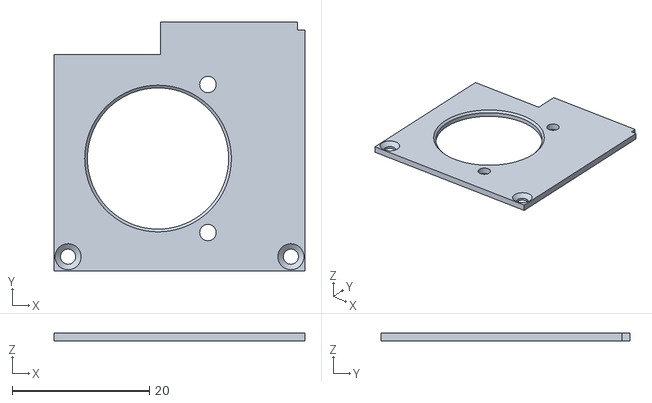
[picture p41: CAD file, 2026-11-11]
hardware/case/stl/pocket-cover-right.stl
36.5 x 36.2 x 1.20
