konstantindenerz/k0d3ball35/hardware/case/stl/pocket-clip-right.stl

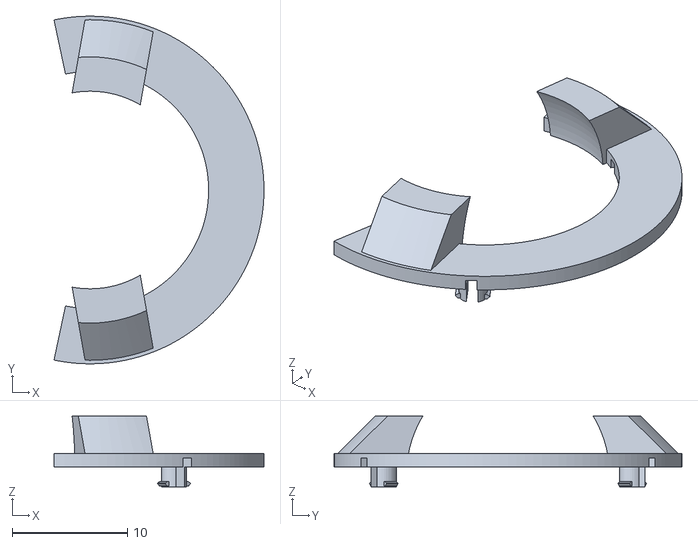
[picture p42: CAD file, 2026-11-11]
hardware/case/stl/pocket-clip-right.stl
18.2 x 30.1 x 6.12
