konstantindenerz/k0d3ball35/hardware/case/common.scad

// k0d3ball35 printed case - 2D building blocks and derived heights
// Everything here works in the layout frame of the selected `half`; the data arrays come
// from data.scad (generated), the offsets and heights from params.scad.

// ---------------------------------------------------------------- helpers
function minx(p) = min([for (q = p) q[0]]);
function maxx(p) = max([for (q = p) q[0]]);
function miny(p) = min([for (q = p) q[1]]);
function maxy(p) = max([for (q = p) q[1]]);
function bc() = ball_center(half);
function ball_centre_z() = ball_top_z - ball_d / 2;
function cradle_rim_z() = ball_centre_z() - 1.0;              // cradle rim_drop
// Top of the pocket wall: below the cup rim, never above the general rim.
function pocket_rim_z() = min(rim_z, cradle_rim_z() - pocket_rim_drop);
function cradle_cup_d() = ball_d + 2 * 0.4 + 2 * 1.6;          // ball_gap and cup wall of the cradle

// One lid for both halves: the roof clears the caps, and since r2.4 it clears the ball too
// (ball_top_z 13.95 < lid_roof_under_z 14.5), so there is nothing to cut for the ball.
lid_roof_under_z = cap_top_z + lid_clear;
lid_top_z        = lid_roof_under_z + lid_roof_t;

// ---------------------------------------------------------------- lid hinge
hx               = hinge_x(half);                               // hinge line x
hinge_axis_z     = lid_top_z - hinge_knuckle_d / 2;             // knuckles flush with the roof top
lip_bottom_z     = rim_z - lid_lip_depth;
// y range of the PCB outline on the vertical line x = hx (the outline is stepped, so the
// crossing edges are horizontal and the outer skirt simply adds pcb_clear + wall)
function _cross_ys(p, x) = [for (i = [0 : len(p) - 1]) let (a = p[i], b = p[(i + 1) % len(p)])
    if ((a[0] <= x && b[0] > x) || (b[0] <= x && a[0] > x))
        a[1] + (b[1] - a[1]) * (x - a[0]) / (b[0] - a[0])];
function hinge_span() = let (ys = _cross_ys(outline(half), hx), w = pcb_clear + wall)
    [min(ys) - w, max(ys) + w];
function hinge_len() = hinge_span()[1] - hinge_span()[0];
function hinge_segments() = 2 * floor(hinge_len() / (2 * hinge_seg_len)) + 1;
function hinge_seg() = (hinge_len() - (hinge_segments() - 1) * hinge_seg_gap) / hinge_segments();
function hinge_seg_y0(i) = hinge_span()[0] + i * (hinge_seg() + hinge_seg_gap);
// knuckle i belongs to the outer plate when i is even (so both ends are outer)
function hinge_owner(i) = (i % 2 == 0) ? "outer" : "inner";

// ---------------------------------------------------------------- foot pose
// As a foot the lid is shifted by foot_dx (data.scad) so its hinge axis sits foot_overhang
// outside the inner tray wall: the outer plate lies roof-up under the controller half, the
// inner plate folds down beyond the inner edge as the kickstand. The half rotates about its
// outer bottom edge by tent_deg (input); the fold is the angle at which the kickstand's lip
// edge reaches the desk, solved by bisection. The stop faces are cut for exactly that fold.
function _rot2(p, a) = [p[0] * cos(a) + p[1] * sin(a), -p[0] * sin(a) + p[1] * cos(a)];
function _lip_in() = pcb_clear - lid_fit - lid_lip_chamfer;    // lip foot outside the PCB edge (negative: inside)
// The half rocks on its outer bottom edge, and the broken edge moves that line inward by
// edge_chamfer: with a sharp corner assumed, the model would hover a tenth above the desk.
function foot_pivot_x() = maxx(outline(half)) + pcb_clear + wall - edge_chamfer;
function foot_axis_x() = hx + foot_dx(half);                                   // hinge axis, board frame
// hinge axis above the desk: the axis is hinge_knuckle_d / 2 under the roof top = tray underside
function foot_hinge_h() = _rot2([foot_axis_x() - foot_pivot_x(), -hinge_knuckle_d / 2], tent_deg)[1];
// the kickstand's contact edge relative to the axis in the lid frame (lip bottom at the inner edge)
// Which edge of the kickstand lands on the desk depends on the fold: the lip is lower, the
// skirt's outer face is further out (lip_min_x / skirt_min_x in data.scad are the true extremes
// of those two rings, which on a mitred outline is not minx(outline) plus an offset). Take
// whichever ends up deeper at the angle in question.
function _kick_lip() = [lip_min_x(half) - hx, lip_bottom_z - hinge_axis_z];
function _kick_skirt() = [skirt_min_x(half) - hx, rim_z - hinge_axis_z];
function _kick_rel() = _kick_gap_lip(hinge_fold_solved) <= _kick_gap_skirt(hinge_fold_solved)
                       ? _kick_lip() : _kick_skirt();
function _kick_gap_lip(f) = foot_hinge_h() + _rot2(_kick_lip(), tent_deg - f)[1];
function _kick_gap_skirt(f) = foot_hinge_h() + _rot2(_kick_skirt(), tent_deg - f)[1];
function _kick_gap(f) = min(_kick_gap_lip(f), _kick_gap_skirt(f));
function _bisect(lo, hi, n) = n == 0 ? (lo + hi) / 2
    : let (m = (lo + hi) / 2) (_kick_gap(m) > 0 ? _bisect(m, hi, n - 1) : _bisect(lo, m, n - 1));
hinge_fold_solved = _bisect(0, 90 + tent_deg, 40);
hinge_fold_deg    = hinge_fold_override > 0 ? hinge_fold_override : hinge_fold_solved;
hinge_stop_deg    = hinge_fold_solved / 2;                     // each cut face leans this far outward
function foot_beta_deg() = hinge_fold_solved - tent_deg;       // kickstand angle below the desk plane... measured from the tray
// Everything below is in the desk frame: the half is rotated about its outer bottom edge, so
// the hinge axis and the inner wall move in x as well - the earlier formula took their board
// coordinates and came out 0.6 mm long.
function foot_axis_desk_x() = foot_pivot_x() + _rot2([foot_axis_x() - foot_pivot_x(), -hinge_knuckle_d / 2], tent_deg)[0];
function foot_contact_x() = foot_axis_desk_x() + _rot2(_kick_rel(), tent_deg - hinge_fold_solved)[0];
function foot_wall_desk_x() = foot_pivot_x() + (minx(outline(half)) - pcb_clear - wall - foot_pivot_x()) * cos(tent_deg);
function foot_reach() = foot_wall_desk_x() - foot_contact_x();   // free desk a half needs inward
// the outer plate's free end (lip bottom at its outer edge, shifted) above the desk
function foot_free_end_h() = _rot2([maxx(outline(half)) + _lip_in() + foot_dx(half) - foot_pivot_x(),
                                    -(lid_top_z - lip_bottom_z)], tent_deg)[1];
function foot_tilt_deg() = tent_deg;

// controller box: inner wall faces and boss axes
function box_r() = box_rect(half);
function box_x_in() = box_r()[0] - pcb_clear;                  // inner face of the outer (-x) wall
function box_y_in() = box_r()[1] - pcb_clear;                  // inner face of the top (-y) wall
function boss_half() = insert_hole_d / 2 + boss_skin;          // 3.0: half of the boss square
function boss_axes() = [[box_x_in() + boss_in, box_y_in() + boss_in],
                        [box_x_in() + boss_in, box_r()[3] - boss_half()]];
function boss_x_end() = box_x_in() + boss_in + boss_half();    // how far the bosses reach into the box
// the cap skirt stands on the PCB guard when there is one (it runs on under the skirt)
box_skirt_z = (guard ? guard_t : 0) + box_skirt_gap;
function usb_x() = (ctrl_rect(half)[0] + ctrl_rect(half)[2]) / 2;

// ---------------------------------------------------------------- 2D regions
module pcb_2d() polygon(outline(half));
module pcb_cavity_2d() offset(delta = pcb_clear) pcb_2d();
// keycap footprints at rest
module caps_2d() for (k = keys(half)) translate([k[0], k[1]]) rotate(-k[2]) square(cap_size, center = true);

// the PCB notch exactly as the board has it (layout data, incl. the square corner on the key side)
module notch_2d() polygon(notch(half));
module housing_footprint_2d() polygon(housing_footprint(half));
module housing_box_2d() polygon(housing_box(half));
module pocket_well_2d() offset(delta = 0.5) housing_box_2d();
// cavity above the PCB plane: the cradle circle inside the (grown) PCB notch
module pocket_cavity_2d() { translate(bc()) circle(d = cradle_d); offset(delta = pcb_clear) notch_2d(); }
module pocket_ring_2d() { offset(delta = pocket_wall) pocket_cavity_2d(); translate(bc()) circle(d = pocket_d); }

module well_2d() polygon(well(half));
// J1 and the FFC lie on the key side of the PCB since r2.2: nothing of the case may sit on
// them, in particular not the lid lip (spec/08-trackball-module.md).
module fpc_keepout_2d() {
    if (len(fpc_box(half)) > 0) offset(delta = fpc_clear) polygon(fpc_box(half));
    if (len(cable_corridor(half)) > 0) offset(delta = fpc_clear) polygon(cable_corridor(half));
}

// A broken outer edge, as a stack of inset slices: OpenSCAD has no offset in z, and a hull over
// a non-convex outline would fill its steps. Each slice is chamfer_step tall, so the taper is
// finer than a print layer and comes out as a clean 45 degree face.
module chamfer_up(z0, c) {          // edge at the bottom of a body, material above it
    if (c > 0) {
    steps = max(1, ceil(c / chamfer_step));
    dz = c / steps;
    for (i = [0 : steps - 1])
        translate([0, 0, z0 + i * dz]) linear_extrude(dz + eps) offset(delta = -(c - i * dz)) children(0);
    }
}
module chamfer_down(z1, c) {        // edge at the top of a body, material below it
    if (c > 0) {
    steps = max(1, ceil(c / chamfer_step));
    dz = c / steps;
    for (i = [0 : steps - 1])
        translate([0, 0, z1 - (i + 1) * dz]) linear_extrude(dz + eps) offset(delta = -(c - i * dz)) children(0);
    }
}

module box_2d() {
    r = box_r();
    translate([r[0], r[1]]) square([box_inner_x - r[0], r[3] - r[1]]);
}
// the tall walls of the controller box: only where the tray has a wall anyway
module box_walls_2d() intersection() {
    difference() { offset(delta = pcb_clear + wall) box_2d(); box_2d(); }
    difference() { outer_2d(); pcb_cavity_2d(); }
}

// Outer footprint of the half, the same from the floor to the rim and for the lid. On the ball
// half it is case_outline (scripts/gen_case.py): the pocket block is part of the stepped edge,
// solid up to the rim, and only pocket_opening_2d() stays open over the cradle under a flush
// cover. Until r2.4 the pocket was a separate rounded block that stopped at the PCB plane, open
// from above and outside the lid.
module outer_2d() {
    offset(delta = wall) pcb_cavity_2d();
    if (has_ball(half)) polygon(case_outline(half));
}
module outer_top_2d() outer_2d();

// the rectangle left open over the cradle (well, cradle circle, cable path) and the rebate the
// cover plate sits in (gen_case.py: opening + ledge, on the thumb side only up to the PCB edge)
function po() = pocket_opening(half);
module pocket_opening_2d() translate([po()[0], po()[1]]) square([po()[2] - po()[0], po()[3] - po()[1]]);
function cr() = cover_rect(half);
module cover_rebate_2d() translate([cr()[0], cr()[1]]) square([cr()[2] - cr()[0], cr()[3] - cr()[1]]);
// the cover plate: the rebate minus the fit, never over the PCB cavity (keys, J1)
module cover_2d() difference() {
    offset(delta = -cover_fit) cover_rebate_2d();
    offset(delta = cover_fit) pcb_cavity_2d();
}
cover_z0 = rim_z - cover_t;

// retainer clip (tray.scad pocket_clip), in the ball-centred frame: x outward, z from the PCB top
function clip_pins() = [for (s = [-1, 1]) [clip_pin_r * cos(s * clip_pin_az), clip_pin_r * sin(s * clip_pin_az)]];
clip_ri  = cover_hole_d / 2;                    // ring bore = the cover's hole
clip_ro  = clip_ri + clip_ring_w;               // ring outer edge
clip_z0  = rim_z;                               // ring underside on the cover top
clip_z1  = rim_z + clip_ring_t;
clip_rin = ball_d / 2 + clip_ball_gap;          // claw inner face: the cup's inner sphere
function clip_top_z() = ball_centre_z() + clip_claw_h;

// ---------------------------------------------------------------- PCB guard
guard_top_z = guard_t;
guard_air   = cap_skirt_z - switch_travel - guard_top_z;           // under a pressed keycap
assert(guard_air >= guard_min_air - 1e-6,
       str("PCB guard too thick: ", guard_air, " mm left under a pressed keycap"));
// The outline comes from data.scad (scripts/gen_case.py guard_polygon): the PCB minus a square
// per switch housing, the screw heads, the box, J1/FFC and the cradle opening, kept as one piece
// without webs narrower than guard_min_web. Outer ring first, then the holes.
module guard_2d() {
    g = guard(half);
    difference() {
        polygon(g[0]);
        for (i = [1 : len(g) - 1]) polygon(g[i]);
    }
}
