konstantindenerz/k0d3ball35/hardware/case/data.scad

// generated by scripts/gen_case.py, do not edit
// Layout facts for both halves in the layout frame (mm): x outward (pinky), y towards
// the user, origin at the middle-column top key. z is not part of this file.
// Selector functions take the half name: outline("left"), holes("right"), ...

outline_left = [[-71.5, -4.75], [-36, -4.75], [-36, -4.29], [-28.35, -4.29], [-28.35, -6.52], [-10.35, -6.52], [-10.35, -8.75], [10.35, -8.75], [10.35, -4.56], [28.35, -4.56], [28.35, 1.69], [46.35, 1.69], [46.35, 53.19], [25.65, 53.19], [25.65, 46.94], [7.65, 46.94], [7.65, 42.75], [-7.65, 42.75], [-7.65, 44.98], [-11.43, 44.98], [-11.43, 68.4], [-32.244, 68.4], [-51.941, 71.873], [-68.643, 77.952], [-74.628, 61.508], [-65.116, 58.045], [-65.186, 57.65], [-71.5, 57.65]];
outline_right = [[-71.5, 60.369], [-71.5, -4.75], [-36, -4.75], [-36, -4.29], [-28.35, -4.29], [-28.35, -6.52], [-10.35, -6.52], [-10.35, -8.75], [10.35, -8.75], [10.35, -4.56], [28.35, -4.56], [28.35, 1.69], [46.35, 1.69], [46.35, 53.19], [25.65, 53.19], [25.65, 46.94], [7.65, 46.94], [7.65, 42.75], [-7.65, 42.75], [-7.65, 44.98], [-13, 44.98], [-13, 50.5], [-28.5, 50.5], [-28.5, 61.26], [-31.63, 61.26], [-30.428, 68.08], [-51.941, 71.873], [-68.643, 77.952], [-74.628, 61.508]];
function outline(h) = h == "left" ? outline_left : outline_right;

holes_left = [[26.75, 12.1], [26.75, 29.1], [-9, 40], [-27, 8], [-32, 61]];
holes_right = [[26.75, 12.1], [26.75, 29.1], [-9, 40], [-27, 8], [-31, 49]];
function holes(h) = h == "left" ? holes_left : holes_right;

bay_left = [[-43.4, -3], [-43.4, 38], [-64.4, 38], [-64.4, -3]];
bay_right = [[-43.4, -3], [-43.4, 38], [-64.4, 38], [-64.4, -3]];
function bay(h) = h == "left" ? bay_left : bay_right;

well_left = [[-42.4, -4], [-42.4, 39], [-50.3, 39], [-50.3, 49.5], [-61.7, 49.5], [-61.7, 39], [-65.4, 39], [-65.4, -4]];
well_right = [[-42.4, -4], [-42.4, 39], [-50.3, 39], [-50.3, 49.5], [-61.7, 49.5], [-61.7, 39], [-65.4, 39], [-65.4, -4]];
function well(h) = h == "left" ? well_left : well_right;

j3_left = [[-51.3, 40.1], [-51.3, 48.5], [-60.7, 48.5], [-60.7, 40.1]];
j3_right = [[-51.3, 40.1], [-51.3, 48.5], [-60.7, 48.5], [-60.7, 40.1]];
function j3(h) = h == "left" ? j3_left : j3_right;

rb1_left = [[-67.15, 43.7], [-70.65, 43.7], [-70.65, 38.3], [-67.15, 38.3]];
rb1_right = [[-67.15, 43.7], [-70.65, 43.7], [-70.65, 38.3], [-67.15, 38.3]];
function rb1(h) = h == "left" ? rb1_left : rb1_right;

ps1_left = [[-66.4, 34.2], [-71.8, 34.2], [-71.8, 25.8], [-66.4, 25.8]];
ps1_right = [[-66.4, 34.2], [-71.8, 34.2], [-71.8, 25.8], [-66.4, 25.8]];
function ps1(h) = h == "left" ? ps1_left : ps1_right;

reset_left = [-68.9, 41];
reset_right = [-68.9, 41];
function reset(h) = h == "left" ? reset_left : reset_right;

switch_left = [-68.5, 30];
switch_right = [-68.5, 30];
function switch(h) = h == "left" ? switch_left : switch_right;

ctrl_rect_left = [-67, -5.65, -49, 27.85];
ctrl_rect_right = [-67, -5.65, -49, 27.85];
function ctrl_rect(h) = h == "left" ? ctrl_rect_left : ctrl_rect_right;

box_rect_left = [-71.5, -4.75, -45.5, 50.6];
box_rect_right = [-71.5, -4.75, -45.5, 50.6];
function box_rect(h) = h == "left" ? box_rect_left : box_rect_right;

test_pads_left = [[-69.5, 54.5], [-67, 54.5], [-64.5, 54.5], [-62, 54.5], [-59.5, 54.5], [-57, 54.5], [-54.5, 54.5], [-52, 54.5], [-49.5, 54.5]];
test_pads_right = [[-66, 45], [-63.5, 45], [-61, 45], [-58.5, 45], [-56, 45], [-53.5, 45], [-51, 45], [-48.5, 45], [-46, 45]];
function test_pads(h) = h == "left" ? test_pads_left : test_pads_right;

keys_left = [[36, 10.44, 0], [18, 4.19, 0], [0, 0, 0], [-18, 2.23, 0], [-36, 4.46, 0], [36, 27.44, 0], [18, 21.19, 0], [0, 17, 0], [-18, 19.23, 0], [-36, 21.46, 0], [36, 44.44, 0], [18, 38.19, 0], [0, 34, 0], [-18, 36.23, 0], [-36, 38.46, 0], [-21.78, 59.65, 0], [-42.14, 61.26, 10], [-61.91, 66.19, 20]];
keys_right = [[36, 10.44, 0], [18, 4.19, 0], [0, 0, 0], [-18, 2.23, 0], [-36, 4.46, 0], [36, 27.44, 0], [18, 21.19, 0], [0, 17, 0], [-18, 19.23, 0], [-36, 21.46, 0], [36, 44.44, 0], [18, 38.19, 0], [0, 34, 0], [-18, 36.23, 0], [-36, 38.46, 0], [-42.14, 61.26, 10], [-61.91, 66.19, 20]];
function keys(h) = h == "left" ? keys_left : keys_right;

switch_holes_left = [[0, 0, 3.4], [-5.5, 0, 1.7], [5.5, 0, 1.7], [0, -5.9, 3.05], [5, -3.8, 3.05], [-5, -3.8, 3.05]];
switch_holes_right = [[0, 0, 3.4], [-5.5, 0, 1.7], [5.5, 0, 1.7], [0, -5.9, 3.05], [5, -3.8, 3.05], [-5, -3.8, 3.05]];
function switch_holes(h) = h == "left" ? switch_holes_left : switch_holes_right;

has_ball_left = false;
has_ball_right = true;
function has_ball(h) = h == "left" ? has_ball_left : has_ball_right;

ball_center_left = [0, 0];
ball_center_right = [-13, 66];
function ball_center(h) = h == "left" ? ball_center_left : ball_center_right;

housing_footprint_left = [];
housing_footprint_right = [[6.55, 77.5], [6.492, 78.085], [6.196, 78.914], [5.869, 79.403], [5.453, 79.819], [4.698, 80.272], [4.135, 80.442], [3.55, 80.5], [-24.45, 80.5], [-25.035, 80.442], [-25.598, 80.272], [-26.353, 79.819], [-26.769, 79.403], [-27.096, 78.914], [-27.321, 78.371], [-27.45, 77.5], [-27.45, 54.5], [-27.392, 53.915], [-27.222, 53.352], [-26.769, 52.597], [-26.353, 52.181], [-25.598, 51.728], [-25.035, 51.558], [-24.45, 51.5], [3.844, 51.514], [4.421, 51.629], [4.964, 51.854], [5.671, 52.379], [6.044, 52.833], [6.322, 53.352], [6.492, 53.915], [6.55, 54.5]];
function housing_footprint(h) = h == "left" ? housing_footprint_left : housing_footprint_right;

housing_box_left = [];
housing_box_right = [[4.05, 54], [4.05, 78], [-24.95, 78], [-24.95, 54]];
function housing_box(h) = h == "left" ? housing_box_left : housing_box_right;

case_screws_left = [];
case_screws_right = [[-13, 56], [-13, 76]];
function case_screws(h) = h == "left" ? case_screws_left : case_screws_right;

case_outline_left = [];
case_outline_right = [[-70.556, 82.054], [-78.73, 59.595], [-74.7, 58.128], [-74.7, -7.95], [-32.8, -7.95], [-32.8, -7.49], [-31.55, -7.49], [-31.55, -9.72], [-13.55, -9.72], [-13.55, -11.95], [13.55, -11.95], [13.55, -7.76], [31.55, -7.76], [31.55, -1.51], [49.55, -1.51], [49.55, 56.39], [10.55, 56.39], [10.55, 84.5], [-30.3, 84.5], [-30.3, 71.307], [-51.11, 74.976]];
function case_outline(h) = h == "left" ? case_outline_left : case_outline_right;

pocket_opening_left = [0, 0, 0, 0];
pocket_opening_right = [-27.2, 50, 4.55, 78.5];
function pocket_opening(h) = h == "left" ? pocket_opening_left : pocket_opening_right;

cover_rect_left = [0, 0, 0, 0];
cover_rect_right = [-28.3, 46, 8.55, 82.5];
function cover_rect(h) = h == "left" ? cover_rect_left : cover_rect_right;

cover_screws_left = [];
cover_screws_right = [[-26.1, 80.3], [6.35, 80.3]];
function cover_screws(h) = h == "left" ? cover_screws_left : cover_screws_right;

notch_left = [];
notch_right = [[-6.58, 50.5], [2.5, 59.58], [2.5, 72.42], [-6.58, 81.5], [-19.42, 81.5], [-28.5, 72.42], [-28.5, 50.5]];
function notch(h) = h == "left" ? notch_left : notch_right;

fpc_box_left = [];
fpc_box_right = [[-16, 44.8], [-16, 50.4], [-25.2, 50.4], [-25.2, 44.8]];
function fpc_box(h) = h == "left" ? fpc_box_left : fpc_box_right;

fpc_body_left = [];
fpc_body_right = [[-16.3, 45.2], [-16.3, 50], [-24.9, 50], [-24.9, 45.2]];
function fpc_body(h) = h == "left" ? fpc_body_left : fpc_body_right;

fpc_tails_left = [];
fpc_tails_right = [[-19.2, 44.5], [-19.2, 45.8], [-22, 45.8], [-22, 44.5]];
function fpc_tails(h) = h == "left" ? fpc_tails_left : fpc_tails_right;

cable_corridor_left = [];
cable_corridor_right = [[-17.6, 51.5], [-23.6, 51.5], [-23.6, 50], [-17.6, 50]];
function cable_corridor(h) = h == "left" ? cable_corridor_left : cable_corridor_right;

ffc_path_left = [];
ffc_path_right = [[0.549, 61.69, -1.893, 25], [0.549, 58.066, -1.893, 25], [0.515, 57.808, -1.871, 24.43], [0.416, 57.567, -1.85, 23.85], [0.257, 57.36, -1.828, 23.28], [0.05, 57.201, -1.806, 22.7], [-0.191, 57.101, -1.784, 22.13], [-9.898, 54.486, -0.945, 0], [-11.17, 54.216, -0.837, 0], [-12.464, 54.087, -0.728, 0], [-13.764, 54.099, -0.62, 0], [-15.055, 54.253, -0.511, 0], [-16.321, 54.547, -0.403, 0], [-17.549, 54.977, -0.294, 0], [-18.722, 55.537, -0.186, 0], [-19.827, 56.222, -0.077, 0], [-22.057, 57.779, 0.15, 0], [-22.185, 57.847, 0.15, 0], [-22.325, 57.883, 0.15, 0], [-22.47, 57.883, 0.15, 0], [-22.611, 57.849, 0.15, 0], [-22.74, 57.782, 0.15, 0], [-22.848, 57.686, 0.15, 0], [-22.931, 57.567, 0.15, 0], [-22.982, 57.431, 0.15, 0], [-23, 57.287, 0.15, 0], [-23, 52.498, 0.15, 0], [-22.98, 52.343, 0.15, 0], [-22.92, 52.198, 0.15, 0], [-22.824, 52.074, 0.15, 0], [-22.7, 51.979, 0.15, 0], [-22.555, 51.919, 0.15, 0], [-22.4, 51.898, 0.15, 0], [-22.4, 51.898, 0.15, 0], [-22.245, 51.919, 0.15, 0], [-22.1, 51.979, 0.15, 0], [-21.976, 52.074, 0.15, 0], [-21.88, 52.198, 0.15, 0], [-21.82, 52.343, 0.15, 0], [-21.8, 52.498, 0.15, 0], [-21.8, 54.962, 0.15, 0], [-21.78, 55.118, 0.15, 0], [-21.72, 55.262, 0.15, 0], [-21.624, 55.387, 0.15, 0], [-21.5, 55.482, 0.15, 0], [-21.355, 55.542, 0.15, 0], [-21.2, 55.562, 0.15, 0], [-21.2, 55.562, 0.15, 0], [-21.045, 55.542, 0.15, 0], [-20.9, 55.482, 0.15, 0], [-20.776, 55.387, 0.15, 0], [-20.68, 55.262, 0.15, 0], [-20.62, 55.118, 0.15, 0], [-20.6, 54.962, 0.15, 0], [-20.6, 53, 0.15, 0], [-20.6, 52.5, 0.225, 15], [-20.6, 52, 0.3, 30], [-20.6, 51.5, 0.375, 45], [-20.6, 51, 0.45, 60], [-20.6, 50.5, 0.525, 75], [-20.6, 50, 0.6, 90], [-20.6, 45.5, 0.6, 90]];
function ffc_path(h) = h == "left" ? ffc_path_left : ffc_path_right;

hinge_x_left = -13;
hinge_x_right = -31;
function hinge_x(h) = h == "left" ? hinge_x_left : hinge_x_right;

lip_min_x_left = -74.052;
lip_min_x_right = -74.052;
function lip_min_x(h) = h == "left" ? lip_min_x_left : lip_min_x_right;

skirt_min_x_left = -78.73;
skirt_min_x_right = -78.73;
function skirt_min_x(h) = h == "left" ? skirt_min_x_left : skirt_min_x_right;

foot_dx_left = -67.828;
foot_dx_right = -49.828;
function foot_dx(h) = h == "left" ? foot_dx_left : foot_dx_right;

foot_magnets_left = [[-37.25, 9.69], [-29.478, 17.19], [-29.478, 45.19], [-37.19, 38.94]];
foot_magnets_right = [[-36.96, 3.71], [-11.478, 9.69], [-11.478, 30.75], [-37, 34.75]];
function foot_magnets(h) = h == "left" ? foot_magnets_left : foot_magnets_right;

feet_left = [[26.75, 12.1], [-9, 40], [-27, 8], [-32, 61], [27, 44.5], [-58, 1], [-58, 34]];
feet_right = [[26.75, 12.1], [-9, 40], [-27, 8], [-31, 49], [27, 44.5], [-58, 1], [-58, 34]];
function feet(h) = h == "left" ? feet_left : feet_right;

guard_left = [[[-71.5, 50.6], [-67.856, 50.6], [-67.85, 50.6], [-67.85, 50.594], [-67.85, 48.8], [-47.306, 48.8], [-47.3, 48.8], [-47.3, 48.794], [-47.3, -4.6], [-45.506, -4.6], [-45.5, -4.6], [-45.345, -4.75], [-36.034, -4.75], [-36, -4.292], [-36, -4.29], [-35.994, -4.29], [-28.356, -4.29], [-28.35, -4.29], [-28.35, -4.296], [-28.35, -6.52], [-10.356, -6.52], [-10.35, -6.52], [-10.35, -6.526], [-10.35, -8.75], [10.35, -8.75], [10.35, -4.566], [10.35, -4.56], [10.356, -4.56], [28.35, -4.56], [28.35, 1.684], [28.35, 1.69], [28.356, 1.69], [46.35, 1.69], [46.35, 53.19], [25.65, 53.19], [25.65, 46.946], [25.65, 46.94], [25.644, 46.94], [7.65, 46.94], [7.65, 42.756], [7.65, 42.75], [7.644, 42.75], [-7.644, 42.75], [-7.65, 42.75], [-7.65, 42.756], [-7.65, 44.98], [-11.424, 44.98], [-11.43, 44.98], [-11.43, 44.986], [-11.43, 68.4], [-32.238, 68.4], [-32.244, 68.4], [-32.249, 68.401], [-48.92, 71.341], [-51.936, 71.872], [-51.941, 71.873], [-51.946, 71.875], [-68.643, 77.952], [-74.628, 61.508], [-65.122, 58.047], [-65.116, 58.045], [-65.117, 58.039], [-65.184, 57.656], [-65.186, 57.65], [-65.192, 57.65], [-71.5, 57.65]], [[10.9, 31.09], [10.906, 31.09], [25.1, 31.09], [25.1, 45.284], [25.1, 45.29], [25.094, 45.29], [10.906, 45.29], [10.9, 45.29], [10.9, 45.284], [10.9, 31.096]], [[25.32, 30.274], [25.318, 30.271], [25.3, 30.248], [25.293, 30.241], [25.292, 30.238], [25.29, 30.236], [25.273, 30.213], [25.266, 30.204], [25.264, 30.202], [25.262, 30.2], [25.239, 30.168], [25.237, 30.165], [25.236, 30.163], [25.214, 30.13], [25.212, 30.128], [25.21, 30.125], [25.205, 30.117], [25.189, 30.092], [25.187, 30.09], [25.185, 30.087], [25.171, 30.063], [25.165, 30.054], [25.163, 30.051], [25.162, 30.048], [25.142, 30.015], [25.14, 30.012], [25.139, 30.009], [25.12, 29.975], [25.118, 29.972], [25.117, 29.969], [25.099, 29.935], [25.098, 29.932], [25.096, 29.929], [25.079, 29.894], [25.078, 29.891], [25.076, 29.888], [25.069, 29.872], [25.06, 29.852], [25.059, 29.85], [25.058, 29.847], [25.044, 29.817], [25.042, 29.811], [25.041, 29.808], [25.04, 29.805], [25.039, 29.802], [25.025, 29.769], [25.024, 29.766], [25.023, 29.763], [25.02, 29.755], [25.009, 29.726], [25.008, 29.723], [25.007, 29.72], [24.994, 29.683], [24.993, 29.68], [24.992, 29.677], [24.981, 29.641], [24.981, 29.64], [24.98, 29.637], [24.979, 29.634], [24.968, 29.596], [24.967, 29.593], [24.966, 29.59], [24.956, 29.552], [24.955, 29.55], [24.955, 29.547], [24.952, 29.533], [24.946, 29.508], [24.945, 29.505], [24.944, 29.502], [24.936, 29.464], [24.936, 29.461], [24.935, 29.458], [24.928, 29.419], [24.927, 29.416], [24.927, 29.413], [24.926, 29.409], [24.921, 29.374], [24.92, 29.371], [24.92, 29.368], [24.914, 29.329], [24.914, 29.326], [24.914, 29.323], [24.912, 29.309], [24.909, 29.284], [24.909, 29.281], [24.909, 29.278], [24.905, 29.239], [24.905, 29.236], [24.905, 29.233], [24.904, 29.214], [24.902, 29.194], [24.902, 29.191], [24.902, 29.188], [24.901, 29.148], [24.901, 29.145], [24.901, 29.142], [24.9, 29.104], [24.9, 29.103], [24.9, 29.1], [24.9, 29.097], [24.901, 29.058], [24.901, 29.055], [24.901, 29.052], [24.902, 29.012], [24.902, 29.009], [24.902, 29.006], [24.905, 28.967], [24.905, 28.964], [24.905, 28.961], [24.909, 28.922], [24.909, 28.919], [24.909, 28.916], [24.912, 28.891], [24.914, 28.877], [24.914, 28.874], [24.914, 28.871], [24.92, 28.829], [24.993, 28.29], [10.906, 28.29], [10.9, 28.29], [10.9, 28.284], [10.9, 14.096], [10.9, 14.09], [10.906, 14.09], [25.1, 14.09], [25.1, 27.897], [25.838, 27.49], [25.875, 27.47], [25.878, 27.468], [25.881, 27.467], [25.915, 27.449], [25.918, 27.448], [25.921, 27.446], [25.956, 27.429], [25.959, 27.428], [25.962, 27.426], [25.978, 27.419], [25.998, 27.41], [26, 27.409], [26.003, 27.408], [26.033, 27.394], [26.039, 27.392], [26.042, 27.391], [26.045, 27.39], [26.048, 27.389], [26.081, 27.375], [26.084, 27.374], [26.087, 27.373], [26.095, 27.37], [26.124, 27.359], [26.127, 27.358], [26.13, 27.357], [26.167, 27.344], [26.17, 27.343], [26.173, 27.342], [26.209, 27.331], [26.21, 27.331], [26.213, 27.33], [26.216, 27.329], [26.254, 27.318], [26.257, 27.317], [26.26, 27.316], [26.298, 27.306], [26.3, 27.305], [26.303, 27.305], [26.317, 27.302], [26.342, 27.296], [26.345, 27.295], [26.348, 27.294], [26.386, 27.286], [26.389, 27.286], [26.392, 27.285], [26.431, 27.278], [26.434, 27.277], [26.437, 27.277], [26.441, 27.276], [26.476, 27.271], [26.479, 27.27], [26.482, 27.27], [26.521, 27.264], [26.524, 27.264], [26.527, 27.264], [26.541, 27.262], [26.566, 27.259], [26.569, 27.259], [26.572, 27.259], [26.611, 27.255], [26.614, 27.255], [26.617, 27.255], [26.656, 27.252], [26.659, 27.252], [26.662, 27.252], [26.702, 27.251], [26.705, 27.251], [26.708, 27.251], [26.747, 27.25], [26.75, 27.25], [26.753, 27.25], [26.792, 27.251], [26.795, 27.251], [26.798, 27.251], [26.838, 27.252], [26.841, 27.252], [26.844, 27.252], [26.883, 27.255], [26.886, 27.255], [26.889, 27.255], [26.928, 27.259], [26.931, 27.259], [26.934, 27.259], [26.959, 27.262], [26.973, 27.264], [26.976, 27.264], [26.979, 27.264], [27.018, 27.27], [27.021, 27.27], [27.024, 27.271], [27.059, 27.276], [27.063, 27.277], [27.066, 27.277], [27.069, 27.278], [27.108, 27.285], [27.111, 27.286], [27.114, 27.286], [27.152, 27.294], [27.155, 27.295], [27.158, 27.296], [27.183, 27.302], [27.197, 27.305], [27.2, 27.305], [27.202, 27.306], [27.24, 27.316], [27.243, 27.317], [27.246, 27.318], [27.284, 27.329], [27.287, 27.33], [27.29, 27.331], [27.291, 27.331], [27.327, 27.342], [27.33, 27.343], [27.333, 27.344], [27.37, 27.357], [27.373, 27.358], [27.376, 27.359], [27.399, 27.368], [27.413, 27.373], [27.416, 27.374], [27.419, 27.375], [27.427, 27.378], [27.455, 27.39], [27.458, 27.391], [27.461, 27.392], [27.497, 27.408], [27.5, 27.409], [27.502, 27.41], [27.511, 27.414], [27.538, 27.426], [27.541, 27.428], [27.544, 27.429], [27.579, 27.446], [27.582, 27.448], [27.585, 27.449], [27.619, 27.467], [27.622, 27.468], [27.625, 27.47], [27.659, 27.489], [27.662, 27.49], [27.665, 27.492], [27.698, 27.512], [27.701, 27.513], [27.704, 27.515], [27.737, 27.535], [27.74, 27.537], [27.742, 27.539], [27.758, 27.549], [27.775, 27.56], [27.778, 27.562], [27.78, 27.564], [27.813, 27.586], [27.815, 27.587], [27.818, 27.589], [27.831, 27.599], [27.85, 27.612], [27.852, 27.614], [27.854, 27.616], [27.875, 27.632], [27.886, 27.64], [27.888, 27.642], [27.891, 27.643], [27.896, 27.648], [27.921, 27.668], [27.924, 27.67], [27.926, 27.672], [27.955, 27.696], [27.956, 27.697], [27.958, 27.699], [27.961, 27.701], [27.99, 27.727], [27.992, 27.729], [27.995, 27.731], [28.023, 27.758], [28.026, 27.76], [28.028, 27.762], [28.058, 27.792], [28.9, 28.613], [28.9, 20.346], [28.9, 20.34], [28.906, 20.34], [43.094, 20.34], [43.1, 20.34], [43.1, 20.346], [43.1, 34.534], [43.1, 34.54], [43.094, 34.54], [28.906, 34.54], [28.9, 34.54], [28.9, 34.534], [28.9, 29.587], [28.058, 30.408], [28.028, 30.438], [28.026, 30.44], [28.023, 30.442], [27.995, 30.469], [27.992, 30.471], [27.99, 30.473], [27.961, 30.499], [27.958, 30.501], [27.956, 30.503], [27.926, 30.528], [27.924, 30.53], [27.921, 30.532], [27.891, 30.557], [27.888, 30.558], [27.886, 30.56], [27.854, 30.584], [27.852, 30.586], [27.85, 30.588], [27.818, 30.611], [27.815, 30.613], [27.813, 30.614], [27.79, 30.63], [27.78, 30.636], [27.778, 30.638], [27.775, 30.64], [27.767, 30.645], [27.742, 30.661], [27.74, 30.663], [27.737, 30.665], [27.713, 30.679], [27.704, 30.685], [27.701, 30.687], [27.698, 30.688], [27.665, 30.708], [27.662, 30.71], [27.659, 30.711], [27.625, 30.73], [27.622, 30.732], [27.619, 30.733], [27.585, 30.751], [27.582, 30.752], [27.579, 30.754], [27.544, 30.771], [27.541, 30.772], [27.538, 30.774], [27.511, 30.786], [27.502, 30.79], [27.5, 30.791], [27.497, 30.792], [27.461, 30.808], [27.458, 30.809], [27.455, 30.81], [27.427, 30.822], [27.419, 30.825], [27.416, 30.826], [27.413, 30.827], [27.376, 30.841], [27.373, 30.842], [27.37, 30.843], [27.333, 30.856], [27.33, 30.857], [27.327, 30.858], [27.29, 30.869], [27.287, 30.87], [27.284, 30.871], [27.271, 30.875], [27.246, 30.882], [27.243, 30.883], [27.24, 30.884], [27.202, 30.894], [27.2, 30.895], [27.197, 30.895], [27.183, 30.898], [27.158, 30.904], [27.155, 30.905], [27.152, 30.906], [27.114, 30.914], [27.111, 30.914], [27.108, 30.915], [27.069, 30.922], [27.066, 30.923], [27.063, 30.923], [27.059, 30.924], [27.024, 30.929], [27.021, 30.93], [27.018, 30.93], [26.979, 30.936], [26.976, 30.936], [26.973, 30.936], [26.959, 30.938], [26.934, 30.941], [26.931, 30.941], [26.928, 30.941], [26.892, 30.945], [26.889, 30.945], [26.886, 30.945], [26.883, 30.945], [26.863, 30.946], [26.844, 30.948], [26.841, 30.948], [26.838, 30.948], [26.824, 30.948], [26.798, 30.949], [26.795, 30.949], [26.792, 30.949], [26.754, 30.95], [26.753, 30.95], [26.75, 30.95], [26.747, 30.95], [26.708, 30.949], [26.705, 30.949], [26.702, 30.949], [26.662, 30.948], [26.659, 30.948], [26.656, 30.948], [26.617, 30.945], [26.614, 30.945], [26.611, 30.945], [26.572, 30.941], [26.569, 30.941], [26.566, 30.941], [26.541, 30.938], [26.527, 30.936], [26.524, 30.936], [26.521, 30.936], [26.482, 30.93], [26.479, 30.93], [26.476, 30.929], [26.441, 30.924], [26.437, 30.923], [26.434, 30.923], [26.431, 30.922], [26.392, 30.915], [26.389, 30.914], [26.386, 30.914], [26.348, 30.906], [26.345, 30.905], [26.342, 30.904], [26.319, 30.899], [26.303, 30.895], [26.3, 30.895], [26.298, 30.894], [26.28, 30.889], [26.26, 30.884], [26.257, 30.883], [26.254, 30.882], [26.216, 30.871], [26.213, 30.87], [26.21, 30.869], [26.173, 30.858], [26.17, 30.857], [26.167, 30.856], [26.13, 30.843], [26.127, 30.842], [26.124, 30.841], [26.101, 30.832], [26.087, 30.827], [26.084, 30.826], [26.081, 30.825], [26.073, 30.822], [26.045, 30.81], [26.042, 30.809], [26.039, 30.808], [26.015, 30.798], [26.003, 30.792], [26, 30.791], [25.998, 30.79], [25.98, 30.782], [25.962, 30.774], [25.959, 30.772], [25.956, 30.771], [25.928, 30.757], [25.921, 30.754], [25.918, 30.752], [25.915, 30.751], [25.897, 30.741], [25.881, 30.733], [25.878, 30.732], [25.875, 30.73], [25.838, 30.71], [25.546, 30.549], [25.322, 30.276]], [[25.32, 13.274], [25.318, 13.271], [25.306, 13.256], [25.293, 13.241], [25.292, 13.238], [25.29, 13.236], [25.266, 13.204], [25.264, 13.202], [25.262, 13.2], [25.239, 13.168], [25.237, 13.165], [25.236, 13.163], [25.221, 13.142], [25.214, 13.13], [25.212, 13.128], [25.21, 13.125], [25.193, 13.099], [25.189, 13.092], [25.187, 13.09], [25.185, 13.087], [25.165, 13.054], [25.163, 13.051], [25.162, 13.048], [25.142, 13.015], [25.14, 13.012], [25.139, 13.009], [25.12, 12.975], [25.118, 12.972], [25.117, 12.969], [25.108, 12.952], [25.099, 12.935], [25.098, 12.932], [25.096, 12.929], [25.079, 12.894], [25.078, 12.891], [25.076, 12.888], [25.065, 12.864], [25.06, 12.852], [25.059, 12.85], [25.058, 12.847], [25.042, 12.811], [25.041, 12.808], [25.04, 12.805], [25.032, 12.787], [25.025, 12.769], [25.024, 12.766], [25.023, 12.763], [25.009, 12.726], [25.008, 12.723], [25.007, 12.72], [24.997, 12.691], [24.994, 12.683], [24.993, 12.68], [24.992, 12.677], [24.981, 12.64], [24.98, 12.637], [24.979, 12.634], [24.968, 12.597], [24.968, 12.596], [24.967, 12.593], [24.966, 12.59], [24.963, 12.576], [24.956, 12.552], [24.955, 12.55], [24.955, 12.547], [24.95, 12.528], [24.946, 12.508], [24.945, 12.505], [24.944, 12.502], [24.936, 12.464], [24.936, 12.461], [24.935, 12.458], [24.928, 12.419], [24.927, 12.416], [24.927, 12.413], [24.926, 12.412], [24.921, 12.374], [24.92, 12.371], [24.92, 12.368], [24.917, 12.349], [24.914, 12.329], [24.914, 12.326], [24.914, 12.323], [24.909, 12.284], [24.909, 12.281], [24.909, 12.278], [24.907, 12.258], [24.905, 12.239], [24.905, 12.236], [24.905, 12.233], [24.902, 12.194], [24.902, 12.191], [24.902, 12.188], [24.901, 12.148], [24.901, 12.145], [24.901, 12.142], [24.9, 12.103], [24.9, 12.1], [24.9, 12.097], [24.901, 12.058], [24.901, 12.055], [24.901, 12.052], [24.902, 12.012], [24.902, 12.009], [24.902, 12.006], [24.905, 11.967], [24.905, 11.964], [24.905, 11.961], [24.907, 11.942], [24.909, 11.922], [24.909, 11.919], [24.909, 11.916], [24.914, 11.877], [24.914, 11.874], [24.914, 11.871], [24.92, 11.829], [24.993, 11.29], [10.906, 11.29], [10.9, 11.29], [10.9, 11.284], [10.9, -2.904], [10.9, -2.91], [10.906, -2.91], [25.094, -2.91], [25.1, -2.91], [25.1, -2.904], [25.1, 10.897], [25.838, 10.49], [25.875, 10.47], [25.878, 10.468], [25.881, 10.467], [25.915, 10.449], [25.918, 10.448], [25.921, 10.446], [25.941, 10.437], [25.956, 10.429], [25.959, 10.428], [25.962, 10.426], [25.998, 10.41], [26, 10.409], [26.003, 10.408], [26.039, 10.392], [26.042, 10.391], [26.045, 10.39], [26.063, 10.382], [26.081, 10.375], [26.084, 10.374], [26.087, 10.373], [26.113, 10.363], [26.124, 10.359], [26.127, 10.358], [26.13, 10.357], [26.151, 10.35], [26.167, 10.344], [26.17, 10.343], [26.173, 10.342], [26.21, 10.331], [26.213, 10.33], [26.216, 10.329], [26.254, 10.318], [26.257, 10.317], [26.26, 10.316], [26.298, 10.306], [26.3, 10.305], [26.303, 10.305], [26.315, 10.302], [26.342, 10.296], [26.345, 10.295], [26.348, 10.294], [26.366, 10.29], [26.386, 10.286], [26.389, 10.286], [26.392, 10.285], [26.411, 10.282], [26.431, 10.278], [26.434, 10.277], [26.437, 10.277], [26.476, 10.271], [26.479, 10.27], [26.482, 10.27], [26.499, 10.267], [26.521, 10.264], [26.524, 10.264], [26.527, 10.264], [26.527, 10.263], [26.566, 10.259], [26.569, 10.259], [26.572, 10.259], [26.611, 10.255], [26.614, 10.255], [26.617, 10.255], [26.649, 10.253], [26.656, 10.252], [26.659, 10.252], [26.662, 10.252], [26.702, 10.251], [26.705, 10.251], [26.708, 10.251], [26.747, 10.25], [26.75, 10.25], [26.753, 10.25], [26.792, 10.251], [26.795, 10.251], [26.798, 10.251], [26.838, 10.252], [26.841, 10.252], [26.844, 10.252], [26.883, 10.255], [26.886, 10.255], [26.889, 10.255], [26.928, 10.259], [26.931, 10.259], [26.934, 10.259], [26.969, 10.263], [26.973, 10.264], [26.976, 10.264], [26.979, 10.264], [26.998, 10.267], [27.018, 10.27], [27.021, 10.27], [27.024, 10.271], [27.063, 10.277], [27.066, 10.277], [27.069, 10.278], [27.089, 10.282], [27.108, 10.285], [27.111, 10.286], [27.114, 10.286], [27.134, 10.29], [27.152, 10.294], [27.155, 10.295], [27.158, 10.296], [27.185, 10.302], [27.197, 10.305], [27.2, 10.305], [27.202, 10.306], [27.24, 10.316], [27.243, 10.317], [27.246, 10.318], [27.284, 10.329], [27.287, 10.33], [27.29, 10.331], [27.327, 10.342], [27.33, 10.343], [27.333, 10.344], [27.349, 10.35], [27.37, 10.357], [27.373, 10.358], [27.376, 10.359], [27.413, 10.373], [27.416, 10.374], [27.419, 10.375], [27.437, 10.382], [27.455, 10.39], [27.458, 10.391], [27.461, 10.392], [27.491, 10.405], [27.497, 10.408], [27.5, 10.409], [27.502, 10.41], [27.518, 10.417], [27.538, 10.426], [27.541, 10.428], [27.544, 10.429], [27.559, 10.437], [27.579, 10.446], [27.582, 10.448], [27.585, 10.449], [27.619, 10.467], [27.622, 10.468], [27.625, 10.47], [27.659, 10.489], [27.662, 10.49], [27.665, 10.492], [27.676, 10.499], [27.698, 10.512], [27.701, 10.513], [27.704, 10.515], [27.737, 10.535], [27.74, 10.537], [27.742, 10.539], [27.761, 10.551], [27.775, 10.56], [27.778, 10.562], [27.78, 10.564], [27.813, 10.586], [27.815, 10.587], [27.818, 10.589], [27.85, 10.612], [27.852, 10.614], [27.854, 10.616], [27.886, 10.64], [27.888, 10.642], [27.891, 10.643], [27.904, 10.654], [27.921, 10.668], [27.924, 10.67], [27.926, 10.672], [27.954, 10.696], [27.956, 10.697], [27.958, 10.699], [27.961, 10.701], [27.99, 10.727], [27.992, 10.729], [27.995, 10.731], [28.023, 10.758], [28.026, 10.76], [28.028, 10.762], [28.058, 10.792], [28.9, 11.613], [28.9, 3.346], [28.9, 3.34], [28.906, 3.34], [43.094, 3.34], [43.1, 3.34], [43.1, 3.346], [43.1, 17.534], [43.1, 17.54], [43.094, 17.54], [28.906, 17.54], [28.9, 17.54], [28.9, 17.534], [28.9, 12.587], [28.058, 13.408], [28.028, 13.438], [28.026, 13.44], [28.023, 13.442], [28.006, 13.458], [27.995, 13.469], [27.992, 13.471], [27.99, 13.473], [27.961, 13.499], [27.958, 13.501], [27.956, 13.503], [27.954, 13.504], [27.926, 13.528], [27.924, 13.53], [27.921, 13.532], [27.904, 13.546], [27.891, 13.557], [27.888, 13.558], [27.886, 13.56], [27.854, 13.584], [27.852, 13.586], [27.85, 13.588], [27.818, 13.611], [27.815, 13.613], [27.813, 13.614], [27.78, 13.636], [27.778, 13.638], [27.775, 13.64], [27.77, 13.643], [27.742, 13.661], [27.74, 13.663], [27.737, 13.665], [27.719, 13.676], [27.704, 13.685], [27.701, 13.687], [27.698, 13.688], [27.679, 13.7], [27.665, 13.708], [27.662, 13.71], [27.659, 13.711], [27.649, 13.717], [27.625, 13.73], [27.622, 13.732], [27.619, 13.733], [27.585, 13.751], [27.582, 13.752], [27.579, 13.754], [27.559, 13.763], [27.544, 13.771], [27.541, 13.772], [27.538, 13.774], [27.518, 13.783], [27.502, 13.79], [27.5, 13.791], [27.497, 13.792], [27.491, 13.795], [27.461, 13.808], [27.458, 13.809], [27.455, 13.81], [27.437, 13.818], [27.419, 13.825], [27.416, 13.826], [27.413, 13.827], [27.376, 13.841], [27.373, 13.842], [27.37, 13.843], [27.333, 13.856], [27.33, 13.857], [27.327, 13.858], [27.29, 13.869], [27.287, 13.87], [27.284, 13.871], [27.264, 13.877], [27.246, 13.882], [27.243, 13.883], [27.24, 13.884], [27.202, 13.894], [27.2, 13.895], [27.197, 13.895], [27.185, 13.898], [27.158, 13.904], [27.155, 13.905], [27.152, 13.906], [27.134, 13.91], [27.114, 13.914], [27.111, 13.914], [27.108, 13.915], [27.089, 13.918], [27.069, 13.922], [27.066, 13.923], [27.063, 13.923], [27.024, 13.929], [27.021, 13.93], [27.018, 13.93], [27.001, 13.933], [26.979, 13.936], [26.976, 13.936], [26.973, 13.936], [26.973, 13.937], [26.934, 13.941], [26.931, 13.941], [26.928, 13.941], [26.889, 13.945], [26.886, 13.945], [26.883, 13.945], [26.85, 13.947], [26.844, 13.948], [26.841, 13.948], [26.838, 13.948], [26.798, 13.949], [26.795, 13.949], [26.792, 13.949], [26.756, 13.95], [26.753, 13.95], [26.75, 13.95], [26.747, 13.95], [26.708, 13.949], [26.705, 13.949], [26.702, 13.949], [26.662, 13.948], [26.659, 13.948], [26.656, 13.948], [26.649, 13.947], [26.617, 13.945], [26.614, 13.945], [26.611, 13.945], [26.572, 13.941], [26.569, 13.941], [26.566, 13.941], [26.527, 13.937], [26.527, 13.936], [26.524, 13.936], [26.521, 13.936], [26.499, 13.933], [26.482, 13.93], [26.479, 13.93], [26.476, 13.929], [26.437, 13.923], [26.434, 13.923], [26.431, 13.922], [26.411, 13.918], [26.392, 13.915], [26.389, 13.914], [26.386, 13.914], [26.366, 13.91], [26.348, 13.906], [26.345, 13.905], [26.342, 13.904], [26.315, 13.898], [26.303, 13.895], [26.3, 13.895], [26.298, 13.894], [26.292, 13.892], [26.26, 13.884], [26.257, 13.883], [26.254, 13.882], [26.234, 13.876], [26.216, 13.871], [26.213, 13.87], [26.21, 13.869], [26.209, 13.869], [26.173, 13.858], [26.17, 13.857], [26.167, 13.856], [26.151, 13.85], [26.13, 13.843], [26.127, 13.842], [26.124, 13.841], [26.087, 13.827], [26.084, 13.826], [26.081, 13.825], [26.063, 13.818], [26.045, 13.81], [26.042, 13.809], [26.039, 13.808], [26.003, 13.792], [26, 13.791], [25.998, 13.79], [25.962, 13.774], [25.959, 13.772], [25.956, 13.771], [25.921, 13.754], [25.918, 13.752], [25.915, 13.751], [25.889, 13.737], [25.881, 13.733], [25.878, 13.732], [25.875, 13.73], [25.842, 13.712], [25.838, 13.71], [25.546, 13.549], [25.322, 13.276]], [[28.9, 37.34], [28.906, 37.34], [43.094, 37.34], [43.1, 37.34], [43.1, 37.346], [43.1, 51.534], [43.1, 51.54], [43.094, 51.54], [28.906, 51.54], [28.9, 51.54], [28.9, 51.534], [28.9, 37.346]], [[-25.1, 29.13], [-25.094, 29.13], [-10.906, 29.13], [-10.9, 29.13], [-10.9, 29.136], [-10.9, 39.106], [-10.104, 38.516], [-10.102, 38.514], [-10.1, 38.512], [-10.078, 38.497], [-10.068, 38.489], [-10.065, 38.487], [-10.063, 38.486], [-10.03, 38.464], [-10.028, 38.462], [-10.025, 38.46], [-10.005, 38.447], [-9.992, 38.439], [-9.99, 38.437], [-9.987, 38.435], [-9.97, 38.425], [-9.954, 38.415], [-9.951, 38.413], [-9.948, 38.412], [-9.915, 38.392], [-9.912, 38.39], [-9.909, 38.389], [-9.896, 38.382], [-9.875, 38.37], [-9.872, 38.368], [-9.869, 38.367], [-9.835, 38.349], [-9.832, 38.348], [-9.829, 38.346], [-9.794, 38.329], [-9.791, 38.328], [-9.788, 38.326], [-9.752, 38.31], [-9.75, 38.309], [-9.747, 38.308], [-9.727, 38.299], [-9.711, 38.292], [-9.708, 38.291], [-9.705, 38.29], [-9.683, 38.281], [-9.669, 38.275], [-9.666, 38.274], [-9.663, 38.273], [-9.639, 38.264], [-9.626, 38.259], [-9.623, 38.258], [-9.62, 38.257], [-9.607, 38.252], [-9.583, 38.244], [-9.58, 38.243], [-9.577, 38.242], [-9.552, 38.234], [-9.54, 38.231], [-9.537, 38.23], [-9.534, 38.229], [-9.511, 38.222], [-9.496, 38.218], [-9.493, 38.217], [-9.49, 38.216], [-9.473, 38.212], [-9.452, 38.206], [-9.45, 38.205], [-9.447, 38.205], [-9.408, 38.196], [-9.405, 38.195], [-9.402, 38.194], [-9.379, 38.189], [-9.364, 38.186], [-9.361, 38.186], [-9.358, 38.185], [-9.328, 38.179], [-9.319, 38.178], [-9.316, 38.177], [-9.313, 38.177], [-9.274, 38.171], [-9.271, 38.17], [-9.268, 38.17], [-9.229, 38.164], [-9.226, 38.164], [-9.223, 38.164], [-9.194, 38.16], [-9.184, 38.159], [-9.181, 38.159], [-9.178, 38.159], [-9.162, 38.157], [-9.139, 38.155], [-9.136, 38.155], [-9.133, 38.155], [-9.094, 38.152], [-9.091, 38.152], [-9.088, 38.152], [-9.048, 38.151], [-9.045, 38.151], [-9.042, 38.151], [-9.003, 38.15], [-9, 38.15], [-8.997, 38.15], [-8.958, 38.151], [-8.955, 38.151], [-8.952, 38.151], [-8.912, 38.152], [-8.909, 38.152], [-8.906, 38.152], [-8.867, 38.155], [-8.864, 38.155], [-8.861, 38.155], [-8.838, 38.157], [-8.822, 38.159], [-8.819, 38.159], [-8.816, 38.159], [-8.806, 38.16], [-8.777, 38.164], [-8.774, 38.164], [-8.771, 38.164], [-8.732, 38.17], [-8.729, 38.17], [-8.726, 38.171], [-8.687, 38.177], [-8.684, 38.177], [-8.681, 38.178], [-8.672, 38.179], [-8.642, 38.185], [-8.639, 38.186], [-8.636, 38.186], [-8.621, 38.189], [-8.598, 38.194], [-8.595, 38.195], [-8.592, 38.196], [-8.553, 38.205], [-8.55, 38.205], [-8.548, 38.206], [-8.51, 38.216], [-8.507, 38.217], [-8.504, 38.218], [-8.482, 38.224], [-8.466, 38.229], [-8.463, 38.23], [-8.46, 38.231], [-8.423, 38.242], [-8.42, 38.243], [-8.417, 38.244], [-8.394, 38.252], [-8.38, 38.257], [-8.377, 38.258], [-8.374, 38.259], [-8.361, 38.264], [-8.337, 38.273], [-8.334, 38.274], [-8.331, 38.275], [-8.317, 38.281], [-8.295, 38.29], [-8.292, 38.291], [-8.289, 38.292], [-8.253, 38.308], [-8.25, 38.309], [-8.248, 38.31], [-8.212, 38.326], [-8.209, 38.328], [-8.206, 38.329], [-8.196, 38.334], [-8.171, 38.346], [-8.168, 38.348], [-8.165, 38.349], [-8.131, 38.367], [-8.128, 38.368], [-8.125, 38.37], [-8.104, 38.382], [-8.091, 38.389], [-8.088, 38.39], [-8.085, 38.392], [-8.052, 38.412], [-8.049, 38.413], [-8.046, 38.415], [-8.013, 38.435], [-8.01, 38.437], [-8.008, 38.439], [-7.981, 38.456], [-7.975, 38.46], [-7.972, 38.462], [-7.97, 38.464], [-7.969, 38.464], [-7.937, 38.486], [-7.935, 38.487], [-7.932, 38.489], [-7.9, 38.512], [-7.898, 38.514], [-7.896, 38.516], [-7.1, 39.106], [-7.1, 26.906], [-7.1, 26.9], [-7.094, 26.9], [7.094, 26.9], [7.1, 26.9], [7.1, 26.906], [7.1, 41.094], [7.1, 41.1], [7.094, 41.1], [-7.094, 41.1], [-7.1, 41.1], [-7.408, 40.998], [-7.627, 41.24], [-7.629, 41.242], [-7.631, 41.245], [-7.658, 41.273], [-7.66, 41.276], [-7.662, 41.278], [-7.669, 41.284], [-7.69, 41.306], [-7.692, 41.308], [-7.694, 41.31], [-7.699, 41.315], [-7.722, 41.338], [-7.724, 41.34], [-7.727, 41.342], [-7.744, 41.358], [-7.755, 41.369], [-7.758, 41.371], [-7.76, 41.373], [-7.772, 41.384], [-7.789, 41.399], [-7.792, 41.401], [-7.794, 41.403], [-7.824, 41.428], [-7.826, 41.43], [-7.829, 41.432], [-7.83, 41.433], [-7.859, 41.457], [-7.862, 41.458], [-7.864, 41.46], [-7.896, 41.484], [-7.898, 41.486], [-7.9, 41.488], [-7.932, 41.511], [-7.935, 41.513], [-7.937, 41.514], [-7.97, 41.536], [-7.972, 41.538], [-7.975, 41.54], [-8.008, 41.561], [-8.01, 41.563], [-8.013, 41.565], [-8.046, 41.585], [-8.049, 41.587], [-8.052, 41.588], [-8.085, 41.608], [-8.088, 41.61], [-8.091, 41.611], [-8.104, 41.618], [-8.125, 41.63], [-8.128, 41.632], [-8.131, 41.633], [-8.165, 41.651], [-8.168, 41.652], [-8.171, 41.654], [-8.196, 41.666], [-8.206, 41.671], [-8.209, 41.672], [-8.212, 41.674], [-8.248, 41.69], [-8.25, 41.691], [-8.253, 41.692], [-8.27, 41.7], [-8.289, 41.708], [-8.292, 41.709], [-8.295, 41.71], [-8.324, 41.722], [-8.331, 41.725], [-8.334, 41.726], [-8.337, 41.727], [-8.354, 41.733], [-8.374, 41.741], [-8.377, 41.742], [-8.38, 41.743], [-8.394, 41.748], [-8.417, 41.756], [-8.42, 41.757], [-8.423, 41.758], [-8.448, 41.766], [-8.46, 41.769], [-8.463, 41.77], [-8.466, 41.771], [-8.489, 41.778], [-8.504, 41.782], [-8.507, 41.783], [-8.51, 41.784], [-8.527, 41.788], [-8.548, 41.794], [-8.55, 41.795], [-8.553, 41.795], [-8.592, 41.804], [-8.595, 41.805], [-8.598, 41.806], [-8.621, 41.811], [-8.636, 41.814], [-8.639, 41.814], [-8.642, 41.815], [-8.672, 41.821], [-8.681, 41.822], [-8.684, 41.823], [-8.687, 41.823], [-8.726, 41.829], [-8.729, 41.83], [-8.732, 41.83], [-8.767, 41.835], [-8.771, 41.836], [-8.774, 41.836], [-8.777, 41.836], [-8.816, 41.841], [-8.819, 41.841], [-8.822, 41.841], [-8.854, 41.844], [-8.861, 41.845], [-8.864, 41.845], [-8.867, 41.845], [-8.906, 41.848], [-8.909, 41.848], [-8.912, 41.848], [-8.952, 41.849], [-8.955, 41.849], [-8.958, 41.849], [-8.997, 41.85], [-9, 41.85], [-9.003, 41.85], [-9.042, 41.849], [-9.045, 41.849], [-9.048, 41.849], [-9.088, 41.848], [-9.091, 41.848], [-9.094, 41.848], [-9.133, 41.845], [-9.136, 41.845], [-9.139, 41.845], [-9.146, 41.844], [-9.178, 41.841], [-9.181, 41.841], [-9.184, 41.841], [-9.223, 41.836], [-9.226, 41.836], [-9.229, 41.836], [-9.235, 41.835], [-9.268, 41.83], [-9.271, 41.83], [-9.274, 41.829], [-9.297, 41.826], [-9.313, 41.823], [-9.316, 41.823], [-9.319, 41.822], [-9.358, 41.815], [-9.361, 41.814], [-9.364, 41.814], [-9.402, 41.806], [-9.405, 41.805], [-9.408, 41.804], [-9.447, 41.795], [-9.45, 41.795], [-9.452, 41.794], [-9.49, 41.784], [-9.493, 41.783], [-9.496, 41.782], [-9.518, 41.776], [-9.534, 41.771], [-9.537, 41.77], [-9.54, 41.769], [-9.577, 41.758], [-9.58, 41.757], [-9.583, 41.756], [-9.606, 41.748], [-9.62, 41.743], [-9.623, 41.742], [-9.626, 41.741], [-9.663, 41.727], [-9.666, 41.726], [-9.669, 41.725], [-9.705, 41.71], [-9.708, 41.709], [-9.711, 41.708], [-9.747, 41.692], [-9.75, 41.691], [-9.752, 41.69], [-9.788, 41.674], [-9.791, 41.672], [-9.794, 41.671], [-9.829, 41.654], [-9.832, 41.652], [-9.835, 41.651], [-9.869, 41.633], [-9.872, 41.632], [-9.875, 41.63], [-9.896, 41.618], [-9.909, 41.611], [-9.912, 41.61], [-9.915, 41.608], [-9.948, 41.588], [-9.951, 41.587], [-9.954, 41.585], [-9.97, 41.575], [-9.987, 41.565], [-9.99, 41.563], [-9.992, 41.561], [-10.005, 41.553], [-10.025, 41.54], [-10.028, 41.538], [-10.03, 41.536], [-10.063, 41.514], [-10.065, 41.513], [-10.068, 41.511], [-10.078, 41.503], [-10.1, 41.488], [-10.102, 41.486], [-10.104, 41.484], [-10.9, 40.894], [-10.9, 43.324], [-10.9, 43.33], [-10.906, 43.33], [-25.094, 43.33], [-25.1, 43.33], [-25.1, 43.324], [-25.1, 29.136]], [[-7.1, -7.1], [-7.094, -7.1], [7.094, -7.1], [7.1, -7.1], [7.1, -7.094], [7.1, 7.094], [7.1, 7.1], [7.094, 7.1], [-7.094, 7.1], [-7.1, 7.1], [-7.1, 7.094], [-7.1, -7.094]], [[-7.1, 9.9], [-7.094, 9.9], [7.094, 9.9], [7.1, 9.9], [7.1, 9.906], [7.1, 24.094], [7.1, 24.1], [7.094, 24.1], [-7.094, 24.1], [-7.1, 24.1], [-7.1, 24.094], [-7.1, 9.906]], [[-43.1, -2.64], [-43.094, -2.64], [-28.906, -2.64], [-28.9, -2.64], [-28.9, -2.634], [-28.9, 7.106], [-28.104, 6.516], [-28.102, 6.514], [-28.1, 6.512], [-28.089, 6.504], [-28.068, 6.489], [-28.065, 6.487], [-28.063, 6.486], [-28.047, 6.475], [-28.03, 6.464], [-28.028, 6.462], [-28.025, 6.46], [-27.992, 6.439], [-27.99, 6.437], [-27.987, 6.435], [-27.97, 6.425], [-27.954, 6.415], [-27.951, 6.413], [-27.948, 6.412], [-27.915, 6.392], [-27.912, 6.39], [-27.909, 6.389], [-27.875, 6.37], [-27.872, 6.368], [-27.869, 6.367], [-27.835, 6.349], [-27.832, 6.348], [-27.829, 6.346], [-27.815, 6.339], [-27.794, 6.329], [-27.791, 6.328], [-27.788, 6.326], [-27.783, 6.324], [-27.752, 6.31], [-27.75, 6.309], [-27.747, 6.308], [-27.711, 6.292], [-27.708, 6.291], [-27.705, 6.29], [-27.669, 6.275], [-27.666, 6.274], [-27.663, 6.273], [-27.626, 6.259], [-27.623, 6.258], [-27.62, 6.257], [-27.607, 6.253], [-27.583, 6.244], [-27.58, 6.243], [-27.577, 6.242], [-27.54, 6.231], [-27.537, 6.23], [-27.534, 6.229], [-27.532, 6.228], [-27.496, 6.218], [-27.493, 6.217], [-27.49, 6.216], [-27.452, 6.206], [-27.45, 6.205], [-27.447, 6.205], [-27.408, 6.196], [-27.405, 6.195], [-27.402, 6.194], [-27.397, 6.193], [-27.364, 6.186], [-27.361, 6.186], [-27.358, 6.185], [-27.319, 6.178], [-27.316, 6.177], [-27.313, 6.177], [-27.289, 6.173], [-27.274, 6.171], [-27.271, 6.17], [-27.268, 6.17], [-27.229, 6.164], [-27.226, 6.164], [-27.223, 6.164], [-27.184, 6.159], [-27.181, 6.159], [-27.178, 6.159], [-27.144, 6.156], [-27.139, 6.155], [-27.136, 6.155], [-27.133, 6.155], [-27.094, 6.152], [-27.091, 6.152], [-27.088, 6.152], [-27.067, 6.151], [-27.048, 6.151], [-27.045, 6.151], [-27.042, 6.151], [-27.004, 6.15], [-27.003, 6.15], [-27, 6.15], [-26.997, 6.15], [-26.996, 6.15], [-26.958, 6.151], [-26.955, 6.151], [-26.952, 6.151], [-26.933, 6.151], [-26.912, 6.152], [-26.909, 6.152], [-26.906, 6.152], [-26.867, 6.155], [-26.864, 6.155], [-26.861, 6.155], [-26.856, 6.156], [-26.822, 6.159], [-26.819, 6.159], [-26.816, 6.159], [-26.777, 6.164], [-26.774, 6.164], [-26.771, 6.164], [-26.732, 6.17], [-26.729, 6.17], [-26.726, 6.171], [-26.711, 6.173], [-26.687, 6.177], [-26.684, 6.177], [-26.681, 6.178], [-26.642, 6.185], [-26.639, 6.186], [-26.636, 6.186], [-26.603, 6.193], [-26.598, 6.194], [-26.595, 6.195], [-26.592, 6.196], [-26.553, 6.205], [-26.55, 6.205], [-26.548, 6.206], [-26.51, 6.216], [-26.507, 6.217], [-26.504, 6.218], [-26.468, 6.228], [-26.466, 6.229], [-26.463, 6.23], [-26.46, 6.231], [-26.423, 6.242], [-26.42, 6.243], [-26.417, 6.244], [-26.393, 6.253], [-26.38, 6.257], [-26.377, 6.258], [-26.374, 6.259], [-26.36, 6.264], [-26.337, 6.273], [-26.334, 6.274], [-26.331, 6.275], [-26.3, 6.288], [-26.295, 6.29], [-26.292, 6.291], [-26.289, 6.292], [-26.262, 6.304], [-26.253, 6.308], [-26.25, 6.309], [-26.248, 6.31], [-26.22, 6.323], [-26.212, 6.326], [-26.209, 6.328], [-26.206, 6.329], [-26.185, 6.339], [-26.171, 6.346], [-26.168, 6.348], [-26.165, 6.349], [-26.131, 6.367], [-26.128, 6.368], [-26.125, 6.37], [-26.091, 6.389], [-26.088, 6.39], [-26.085, 6.392], [-26.065, 6.404], [-26.052, 6.412], [-26.049, 6.413], [-26.046, 6.415], [-26.019, 6.432], [-26.013, 6.435], [-26.01, 6.437], [-26.008, 6.439], [-25.992, 6.449], [-25.975, 6.46], [-25.972, 6.462], [-25.97, 6.464], [-25.962, 6.469], [-25.937, 6.486], [-25.935, 6.487], [-25.932, 6.489], [-25.912, 6.504], [-25.9, 6.512], [-25.898, 6.514], [-25.896, 6.516], [-25.1, 7.106], [-25.1, -4.864], [-25.1, -4.87], [-25.094, -4.87], [-10.906, -4.87], [-10.9, -4.87], [-10.9, -4.864], [-10.9, 9.324], [-10.9, 9.33], [-10.906, 9.33], [-25.094, 9.33], [-25.1, 9.33], [-25.433, 9.07], [-25.724, 9.34], [-25.755, 9.369], [-25.758, 9.371], [-25.76, 9.373], [-25.773, 9.385], [-25.789, 9.399], [-25.792, 9.401], [-25.794, 9.403], [-25.812, 9.418], [-25.824, 9.428], [-25.826, 9.43], [-25.829, 9.432], [-25.846, 9.446], [-25.859, 9.457], [-25.862, 9.458], [-25.864, 9.46], [-25.896, 9.484], [-25.898, 9.486], [-25.9, 9.488], [-25.932, 9.511], [-25.935, 9.513], [-25.937, 9.514], [-25.97, 9.536], [-25.972, 9.538], [-25.975, 9.54], [-26.008, 9.561], [-26.01, 9.563], [-26.013, 9.565], [-26.046, 9.585], [-26.049, 9.587], [-26.052, 9.588], [-26.085, 9.608], [-26.088, 9.61], [-26.091, 9.611], [-26.125, 9.63], [-26.128, 9.632], [-26.131, 9.633], [-26.165, 9.651], [-26.168, 9.652], [-26.171, 9.654], [-26.206, 9.671], [-26.209, 9.672], [-26.212, 9.674], [-26.248, 9.69], [-26.25, 9.691], [-26.253, 9.692], [-26.289, 9.708], [-26.292, 9.709], [-26.295, 9.71], [-26.313, 9.718], [-26.331, 9.725], [-26.334, 9.726], [-26.337, 9.727], [-26.36, 9.736], [-26.374, 9.741], [-26.377, 9.742], [-26.38, 9.743], [-26.41, 9.753], [-26.417, 9.756], [-26.42, 9.757], [-26.423, 9.758], [-26.46, 9.769], [-26.463, 9.77], [-26.466, 9.771], [-26.486, 9.777], [-26.504, 9.782], [-26.507, 9.783], [-26.51, 9.784], [-26.548, 9.794], [-26.55, 9.795], [-26.553, 9.795], [-26.592, 9.804], [-26.595, 9.805], [-26.598, 9.806], [-26.622, 9.811], [-26.636, 9.814], [-26.639, 9.814], [-26.642, 9.815], [-26.681, 9.822], [-26.684, 9.823], [-26.687, 9.823], [-26.726, 9.829], [-26.729, 9.83], [-26.732, 9.83], [-26.749, 9.833], [-26.771, 9.836], [-26.774, 9.836], [-26.777, 9.836], [-26.777, 9.837], [-26.816, 9.841], [-26.819, 9.841], [-26.822, 9.841], [-26.861, 9.845], [-26.864, 9.845], [-26.867, 9.845], [-26.9, 9.847], [-26.906, 9.848], [-26.909, 9.848], [-26.912, 9.848], [-26.952, 9.849], [-26.955, 9.849], [-26.958, 9.849], [-26.994, 9.85], [-26.997, 9.85], [-27, 9.85], [-27.003, 9.85], [-27.042, 9.849], [-27.045, 9.849], [-27.048, 9.849], [-27.088, 9.848], [-27.091, 9.848], [-27.094, 9.848], [-27.101, 9.847], [-27.133, 9.845], [-27.136, 9.845], [-27.139, 9.845], [-27.178, 9.841], [-27.181, 9.841], [-27.184, 9.841], [-27.223, 9.837], [-27.223, 9.836], [-27.226, 9.836], [-27.229, 9.836], [-27.251, 9.833], [-27.268, 9.83], [-27.271, 9.83], [-27.274, 9.829], [-27.313, 9.823], [-27.316, 9.823], [-27.319, 9.822], [-27.339, 9.818], [-27.358, 9.815], [-27.361, 9.814], [-27.364, 9.814], [-27.402, 9.806], [-27.405, 9.805], [-27.408, 9.804], [-27.434, 9.798], [-27.447, 9.795], [-27.45, 9.795], [-27.452, 9.794], [-27.458, 9.792], [-27.49, 9.784], [-27.493, 9.783], [-27.496, 9.782], [-27.516, 9.776], [-27.534, 9.771], [-27.537, 9.77], [-27.54, 9.769], [-27.55, 9.766], [-27.577, 9.758], [-27.58, 9.757], [-27.583, 9.756], [-27.62, 9.743], [-27.623, 9.742], [-27.626, 9.741], [-27.663, 9.727], [-27.666, 9.726], [-27.669, 9.725], [-27.705, 9.71], [-27.708, 9.709], [-27.711, 9.708], [-27.747, 9.692], [-27.75, 9.691], [-27.752, 9.69], [-27.753, 9.69], [-27.788, 9.674], [-27.791, 9.672], [-27.794, 9.671], [-27.801, 9.667], [-27.829, 9.654], [-27.832, 9.652], [-27.835, 9.651], [-27.846, 9.645], [-27.869, 9.633], [-27.872, 9.632], [-27.875, 9.63], [-27.901, 9.616], [-27.909, 9.611], [-27.912, 9.61], [-27.915, 9.608], [-27.926, 9.601], [-27.948, 9.588], [-27.951, 9.587], [-27.954, 9.585], [-27.987, 9.565], [-27.99, 9.563], [-27.992, 9.561], [-28.011, 9.549], [-28.025, 9.54], [-28.028, 9.538], [-28.03, 9.536], [-28.063, 9.514], [-28.065, 9.513], [-28.068, 9.511], [-28.1, 9.488], [-28.102, 9.486], [-28.104, 9.484], [-28.9, 8.894], [-28.9, 11.554], [-28.9, 11.56], [-28.906, 11.56], [-43.094, 11.56], [-43.1, 11.56], [-43.1, 11.554], [-43.1, -2.634]], [[-25.1, 12.13], [-25.094, 12.13], [-10.906, 12.13], [-10.9, 12.13], [-10.9, 12.136], [-10.9, 26.324], [-10.9, 26.33], [-10.906, 26.33], [-25.094, 26.33], [-25.1, 26.33], [-25.1, 26.324], [-25.1, 12.136]], [[-28.88, 52.55], [-28.874, 52.55], [-14.686, 52.55], [-14.68, 52.55], [-14.68, 52.556], [-14.68, 66.744], [-14.68, 66.75], [-14.686, 66.75], [-28.874, 66.75], [-28.88, 66.75], [-28.88, 66.744], [-28.88, 52.556]], [[-43.1, 14.36], [-43.094, 14.36], [-28.906, 14.36], [-28.9, 14.36], [-28.9, 14.366], [-28.9, 28.554], [-28.9, 28.56], [-28.906, 28.56], [-43.094, 28.56], [-43.1, 28.56], [-43.1, 28.554], [-43.1, 14.366]], [[-43.1, 31.36], [-43.094, 31.36], [-28.906, 31.36], [-28.9, 31.36], [-28.9, 31.366], [-28.9, 45.554], [-28.9, 45.56], [-28.906, 45.56], [-43.094, 45.56], [-43.1, 45.56], [-43.1, 45.554], [-43.1, 31.366]], [[-30.152, 60.909], [-30.152, 60.912], [-30.151, 60.952], [-30.151, 60.955], [-30.151, 60.958], [-30.15, 60.996], [-30.15, 60.997], [-30.15, 61], [-30.15, 61.003], [-30.15, 61.004], [-30.151, 61.042], [-30.151, 61.045], [-30.151, 61.048], [-30.152, 61.088], [-30.152, 61.091], [-30.152, 61.094], [-30.155, 61.133], [-30.155, 61.136], [-30.155, 61.139], [-30.156, 61.144], [-30.159, 61.178], [-30.159, 61.181], [-30.159, 61.184], [-30.163, 61.219], [-30.164, 61.223], [-30.164, 61.226], [-30.164, 61.229], [-30.165, 61.234], [-30.17, 61.268], [-30.17, 61.271], [-30.171, 61.274], [-30.172, 61.283], [-30.177, 61.313], [-30.177, 61.316], [-30.178, 61.319], [-30.184, 61.354], [-30.185, 61.358], [-30.186, 61.361], [-30.186, 61.364], [-30.192, 61.39], [-30.194, 61.402], [-30.195, 61.405], [-30.196, 61.408], [-30.205, 61.447], [-30.205, 61.45], [-30.206, 61.452], [-30.216, 61.49], [-30.217, 61.493], [-30.218, 61.496], [-30.22, 61.504], [-30.229, 61.534], [-30.23, 61.537], [-30.231, 61.54], [-30.242, 61.577], [-30.243, 61.58], [-30.244, 61.583], [-30.255, 61.613], [-30.257, 61.62], [-30.258, 61.623], [-30.259, 61.626], [-30.273, 61.663], [-30.274, 61.666], [-30.275, 61.669], [-30.29, 61.705], [-30.291, 61.708], [-30.292, 61.711], [-30.301, 61.731], [-30.308, 61.747], [-30.309, 61.75], [-30.31, 61.752], [-30.311, 61.756], [-30.326, 61.788], [-30.328, 61.791], [-30.329, 61.794], [-30.346, 61.829], [-30.348, 61.832], [-30.349, 61.835], [-30.367, 61.869], [-30.368, 61.872], [-30.37, 61.875], [-30.376, 61.886], [-30.389, 61.909], [-30.39, 61.912], [-30.392, 61.915], [-30.412, 61.948], [-30.413, 61.951], [-30.415, 61.954], [-30.435, 61.987], [-30.437, 61.99], [-30.439, 61.992], [-30.451, 62.012], [-30.46, 62.025], [-30.462, 62.028], [-30.464, 62.03], [-30.482, 62.057], [-30.486, 62.063], [-30.487, 62.065], [-30.489, 62.068], [-30.502, 62.085], [-30.512, 62.1], [-30.514, 62.102], [-30.516, 62.104], [-30.516, 62.105], [-30.54, 62.136], [-30.542, 62.138], [-30.543, 62.141], [-30.568, 62.171], [-30.57, 62.174], [-30.572, 62.176], [-30.576, 62.181], [-30.597, 62.206], [-30.599, 62.208], [-30.601, 62.211], [-30.627, 62.24], [-30.629, 62.242], [-30.631, 62.245], [-30.637, 62.25], [-30.658, 62.273], [-30.66, 62.276], [-30.662, 62.278], [-30.69, 62.306], [-30.692, 62.308], [-30.694, 62.31], [-30.722, 62.338], [-30.724, 62.34], [-30.727, 62.342], [-30.754, 62.368], [-30.755, 62.369], [-30.758, 62.371], [-30.76, 62.373], [-30.768, 62.38], [-30.789, 62.399], [-30.792, 62.401], [-30.794, 62.403], [-30.824, 62.428], [-30.826, 62.43], [-30.829, 62.432], [-30.844, 62.444], [-30.859, 62.457], [-30.862, 62.458], [-30.864, 62.46], [-30.896, 62.484], [-30.898, 62.486], [-30.9, 62.488], [-30.932, 62.511], [-30.935, 62.513], [-30.937, 62.514], [-30.97, 62.536], [-30.972, 62.538], [-30.975, 62.54], [-31.008, 62.561], [-31.01, 62.563], [-31.013, 62.565], [-31.036, 62.579], [-31.046, 62.585], [-31.049, 62.587], [-31.052, 62.588], [-31.085, 62.608], [-31.088, 62.61], [-31.091, 62.611], [-31.125, 62.63], [-31.128, 62.632], [-31.131, 62.633], [-31.165, 62.651], [-31.168, 62.652], [-31.171, 62.654], [-31.184, 62.66], [-31.206, 62.671], [-31.209, 62.672], [-31.212, 62.674], [-31.248, 62.69], [-31.25, 62.691], [-31.253, 62.692], [-31.288, 62.708], [-31.289, 62.708], [-31.292, 62.709], [-31.295, 62.71], [-31.326, 62.723], [-31.331, 62.725], [-31.334, 62.726], [-31.337, 62.727], [-31.354, 62.733], [-31.374, 62.741], [-31.377, 62.742], [-31.38, 62.743], [-31.417, 62.756], [-31.42, 62.757], [-31.423, 62.758], [-31.46, 62.769], [-31.463, 62.77], [-31.466, 62.771], [-31.477, 62.774], [-31.504, 62.782], [-31.507, 62.783], [-31.51, 62.784], [-31.526, 62.788], [-31.548, 62.794], [-31.55, 62.795], [-31.553, 62.795], [-31.592, 62.804], [-31.595, 62.805], [-31.598, 62.806], [-31.627, 62.812], [-31.636, 62.814], [-31.639, 62.814], [-31.642, 62.815], [-31.68, 62.822], [-31.681, 62.822], [-31.684, 62.823], [-31.687, 62.823], [-31.712, 62.827], [-31.726, 62.829], [-31.729, 62.83], [-31.732, 62.83], [-31.74, 62.832], [-31.771, 62.836], [-31.774, 62.836], [-31.777, 62.836], [-31.782, 62.837], [-31.816, 62.841], [-31.819, 62.841], [-31.822, 62.841], [-31.861, 62.845], [-31.864, 62.845], [-31.867, 62.845], [-31.906, 62.848], [-31.909, 62.848], [-31.912, 62.848], [-31.952, 62.849], [-31.955, 62.849], [-31.958, 62.849], [-31.996, 62.85], [-31.997, 62.85], [-32, 62.85], [-32.003, 62.85], [-32.004, 62.85], [-32.042, 62.849], [-32.045, 62.849], [-32.048, 62.849], [-32.088, 62.848], [-32.091, 62.848], [-32.094, 62.848], [-32.133, 62.845], [-32.136, 62.845], [-32.139, 62.845], [-32.178, 62.841], [-32.181, 62.841], [-32.184, 62.841], [-32.223, 62.836], [-32.226, 62.836], [-32.229, 62.836], [-32.268, 62.83], [-32.271, 62.83], [-32.274, 62.829], [-32.313, 62.823], [-32.316, 62.823], [-32.319, 62.822], [-32.358, 62.815], [-32.361, 62.814], [-32.364, 62.814], [-32.389, 62.809], [-32.402, 62.806], [-32.405, 62.805], [-32.408, 62.804], [-32.447, 62.795], [-32.45, 62.795], [-32.452, 62.794], [-32.471, 62.789], [-32.49, 62.784], [-32.493, 62.783], [-32.496, 62.782], [-32.534, 62.771], [-32.537, 62.77], [-32.54, 62.769], [-32.567, 62.761], [-32.577, 62.758], [-32.58, 62.757], [-32.583, 62.756], [-32.62, 62.743], [-32.623, 62.742], [-32.626, 62.741], [-32.663, 62.727], [-32.666, 62.726], [-32.669, 62.725], [-32.705, 62.71], [-32.708, 62.709], [-32.711, 62.708], [-32.725, 62.702], [-32.747, 62.692], [-32.75, 62.691], [-32.752, 62.69], [-32.788, 62.674], [-32.791, 62.672], [-32.794, 62.671], [-32.829, 62.654], [-32.832, 62.652], [-32.835, 62.651], [-32.869, 62.633], [-32.872, 62.632], [-32.875, 62.63], [-32.909, 62.611], [-32.912, 62.61], [-32.915, 62.608], [-32.948, 62.588], [-32.951, 62.587], [-32.954, 62.585], [-32.987, 62.565], [-32.99, 62.563], [-32.992, 62.561], [-33.025, 62.54], [-33.028, 62.538], [-33.03, 62.536], [-33.063, 62.514], [-33.065, 62.513], [-33.068, 62.511], [-33.085, 62.498], [-33.1, 62.488], [-33.102, 62.486], [-33.104, 62.484], [-33.112, 62.478], [-33.136, 62.46], [-33.138, 62.458], [-33.141, 62.457], [-33.156, 62.444], [-33.171, 62.432], [-33.174, 62.43], [-33.176, 62.428], [-33.206, 62.403], [-33.208, 62.401], [-33.211, 62.399], [-33.24, 62.373], [-33.242, 62.371], [-33.245, 62.369], [-33.269, 62.346], [-33.273, 62.342], [-33.276, 62.34], [-33.278, 62.338], [-33.306, 62.31], [-33.308, 62.308], [-33.31, 62.306], [-33.338, 62.278], [-33.34, 62.276], [-33.342, 62.273], [-33.346, 62.269], [-33.369, 62.245], [-33.371, 62.242], [-33.373, 62.24], [-33.399, 62.211], [-33.401, 62.208], [-33.403, 62.206], [-33.428, 62.176], [-33.43, 62.174], [-33.432, 62.171], [-33.45, 62.149], [-33.457, 62.141], [-33.458, 62.138], [-33.46, 62.136], [-33.471, 62.122], [-33.484, 62.104], [-33.486, 62.102], [-33.488, 62.1], [-33.511, 62.068], [-33.513, 62.065], [-33.514, 62.063], [-33.519, 62.056], [-33.536, 62.03], [-33.538, 62.028], [-33.54, 62.025], [-33.561, 61.992], [-33.563, 61.99], [-33.565, 61.987], [-33.585, 61.954], [-33.587, 61.951], [-33.588, 61.948], [-33.608, 61.915], [-33.61, 61.912], [-33.611, 61.909], [-33.63, 61.875], [-33.632, 61.872], [-33.633, 61.869], [-33.651, 61.835], [-33.652, 61.832], [-33.654, 61.829], [-33.671, 61.794], [-33.672, 61.791], [-33.674, 61.788], [-33.69, 61.752], [-33.691, 61.75], [-33.692, 61.747], [-33.702, 61.725], [-33.708, 61.711], [-33.709, 61.708], [-33.71, 61.705], [-33.725, 61.669], [-33.726, 61.666], [-33.727, 61.663], [-33.741, 61.626], [-33.742, 61.623], [-33.743, 61.62], [-33.756, 61.583], [-33.757, 61.58], [-33.758, 61.577], [-33.764, 61.558], [-33.769, 61.54], [-33.77, 61.537], [-33.771, 61.534], [-33.782, 61.496], [-33.783, 61.493], [-33.784, 61.49], [-33.794, 61.452], [-33.795, 61.45], [-33.795, 61.447], [-33.802, 61.418], [-33.804, 61.408], [-33.805, 61.405], [-33.806, 61.402], [-33.814, 61.364], [-33.814, 61.361], [-33.815, 61.358], [-33.822, 61.319], [-33.823, 61.316], [-33.823, 61.313], [-33.825, 61.302], [-33.829, 61.274], [-33.83, 61.271], [-33.83, 61.268], [-33.832, 61.256], [-33.836, 61.229], [-33.836, 61.226], [-33.836, 61.223], [-33.841, 61.184], [-33.841, 61.181], [-33.841, 61.178], [-33.845, 61.139], [-33.845, 61.136], [-33.845, 61.133], [-33.848, 61.094], [-33.848, 61.091], [-33.848, 61.088], [-33.849, 61.048], [-33.849, 61.045], [-33.849, 61.042], [-33.85, 61.004], [-33.85, 61.003], [-33.85, 61], [-33.85, 60.997], [-33.85, 60.996], [-33.849, 60.958], [-33.849, 60.955], [-33.849, 60.952], [-33.848, 60.912], [-33.848, 60.909], [-33.848, 60.906], [-33.845, 60.867], [-33.845, 60.864], [-33.845, 60.861], [-33.841, 60.822], [-33.841, 60.819], [-33.841, 60.816], [-33.836, 60.777], [-33.836, 60.774], [-33.836, 60.771], [-33.832, 60.744], [-33.83, 60.732], [-33.83, 60.729], [-33.829, 60.726], [-33.825, 60.698], [-33.823, 60.687], [-33.823, 60.684], [-33.822, 60.681], [-33.815, 60.642], [-33.814, 60.639], [-33.814, 60.636], [-33.813, 60.63], [-33.806, 60.598], [-33.805, 60.595], [-33.804, 60.592], [-33.795, 60.553], [-33.795, 60.55], [-33.794, 60.548], [-33.789, 60.529], [-33.784, 60.51], [-33.783, 60.507], [-33.782, 60.504], [-33.771, 60.466], [-33.77, 60.463], [-33.769, 60.46], [-33.761, 60.433], [-33.758, 60.423], [-33.757, 60.42], [-33.756, 60.417], [-33.743, 60.38], [-33.742, 60.377], [-33.741, 60.374], [-33.727, 60.337], [-33.726, 60.334], [-33.725, 60.331], [-33.71, 60.295], [-33.709, 60.292], [-33.708, 60.289], [-33.702, 60.275], [-33.692, 60.253], [-33.691, 60.25], [-33.69, 60.248], [-33.674, 60.212], [-33.672, 60.209], [-33.671, 60.206], [-33.654, 60.171], [-33.652, 60.168], [-33.651, 60.165], [-33.633, 60.131], [-33.632, 60.128], [-33.63, 60.125], [-33.611, 60.091], [-33.61, 60.088], [-33.608, 60.085], [-33.588, 60.052], [-33.587, 60.049], [-33.585, 60.046], [-33.565, 60.013], [-33.563, 60.01], [-33.561, 60.008], [-33.54, 59.975], [-33.538, 59.972], [-33.536, 59.97], [-33.519, 59.944], [-33.514, 59.937], [-33.513, 59.935], [-33.511, 59.932], [-33.488, 59.9], [-33.486, 59.898], [-33.484, 59.896], [-33.471, 59.878], [-33.46, 59.864], [-33.458, 59.862], [-33.457, 59.859], [-33.45, 59.851], [-33.432, 59.829], [-33.43, 59.826], [-33.428, 59.824], [-33.403, 59.794], [-33.401, 59.792], [-33.399, 59.789], [-33.373, 59.76], [-33.371, 59.758], [-33.369, 59.755], [-33.346, 59.731], [-33.342, 59.727], [-33.34, 59.724], [-33.338, 59.722], [-33.31, 59.694], [-33.308, 59.692], [-33.306, 59.69], [-33.278, 59.662], [-33.276, 59.66], [-33.273, 59.658], [-33.269, 59.654], [-33.245, 59.631], [-33.242, 59.629], [-33.24, 59.627], [-33.211, 59.601], [-33.208, 59.599], [-33.206, 59.597], [-33.176, 59.572], [-33.174, 59.57], [-33.171, 59.568], [-33.149, 59.55], [-33.141, 59.543], [-33.138, 59.542], [-33.136, 59.54], [-33.122, 59.529], [-33.104, 59.516], [-33.102, 59.514], [-33.1, 59.512], [-33.068, 59.489], [-33.065, 59.487], [-33.063, 59.486], [-33.056, 59.481], [-33.03, 59.464], [-33.028, 59.462], [-33.025, 59.46], [-32.992, 59.439], [-32.99, 59.437], [-32.987, 59.435], [-32.954, 59.415], [-32.951, 59.413], [-32.948, 59.412], [-32.915, 59.392], [-32.912, 59.39], [-32.909, 59.389], [-32.875, 59.37], [-32.872, 59.368], [-32.869, 59.367], [-32.835, 59.349], [-32.832, 59.348], [-32.829, 59.346], [-32.794, 59.329], [-32.791, 59.328], [-32.788, 59.326], [-32.752, 59.31], [-32.75, 59.309], [-32.747, 59.308], [-32.725, 59.298], [-32.711, 59.292], [-32.708, 59.291], [-32.705, 59.29], [-32.669, 59.275], [-32.666, 59.274], [-32.663, 59.273], [-32.626, 59.259], [-32.623, 59.258], [-32.62, 59.257], [-32.583, 59.244], [-32.58, 59.243], [-32.577, 59.242], [-32.558, 59.236], [-32.54, 59.231], [-32.537, 59.23], [-32.534, 59.229], [-32.496, 59.218], [-32.493, 59.217], [-32.49, 59.216], [-32.452, 59.206], [-32.45, 59.205], [-32.447, 59.205], [-32.418, 59.198], [-32.408, 59.196], [-32.405, 59.195], [-32.402, 59.194], [-32.364, 59.186], [-32.361, 59.186], [-32.358, 59.185], [-32.319, 59.178], [-32.316, 59.177], [-32.313, 59.177], [-32.302, 59.175], [-32.274, 59.171], [-32.271, 59.17], [-32.268, 59.17], [-32.256, 59.168], [-32.229, 59.164], [-32.226, 59.164], [-32.223, 59.164], [-32.184, 59.159], [-32.181, 59.159], [-32.178, 59.159], [-32.139, 59.155], [-32.136, 59.155], [-32.133, 59.155], [-32.094, 59.152], [-32.091, 59.152], [-32.088, 59.152], [-32.048, 59.151], [-32.045, 59.151], [-32.042, 59.151], [-32.004, 59.15], [-32.003, 59.15], [-32, 59.15], [-31.997, 59.15], [-31.958, 59.151], [-31.955, 59.151], [-31.952, 59.151], [-31.912, 59.152], [-31.909, 59.152], [-31.906, 59.152], [-31.867, 59.155], [-31.864, 59.155], [-31.861, 59.155], [-31.822, 59.159], [-31.819, 59.159], [-31.816, 59.159], [-31.782, 59.163], [-31.777, 59.164], [-31.774, 59.164], [-31.771, 59.164], [-31.74, 59.168], [-31.732, 59.17], [-31.729, 59.17], [-31.726, 59.171], [-31.712, 59.173], [-31.687, 59.177], [-31.684, 59.177], [-31.681, 59.178], [-31.68, 59.178], [-31.642, 59.185], [-31.639, 59.186], [-31.636, 59.186], [-31.627, 59.188], [-31.598, 59.194], [-31.595, 59.195], [-31.592, 59.196], [-31.553, 59.205], [-31.55, 59.205], [-31.548, 59.206], [-31.51, 59.216], [-31.507, 59.217], [-31.504, 59.218], [-31.493, 59.221], [-31.466, 59.229], [-31.463, 59.23], [-31.46, 59.231], [-31.429, 59.24], [-31.423, 59.242], [-31.42, 59.243], [-31.417, 59.244], [-31.38, 59.257], [-31.377, 59.258], [-31.374, 59.259], [-31.367, 59.262], [-31.337, 59.273], [-31.334, 59.274], [-31.331, 59.275], [-31.326, 59.277], [-31.295, 59.29], [-31.292, 59.291], [-31.289, 59.292], [-31.288, 59.292], [-31.253, 59.308], [-31.25, 59.309], [-31.248, 59.31], [-31.212, 59.326], [-31.209, 59.328], [-31.206, 59.329], [-31.184, 59.34], [-31.171, 59.346], [-31.168, 59.348], [-31.165, 59.349], [-31.131, 59.367], [-31.128, 59.368], [-31.125, 59.37], [-31.091, 59.389], [-31.088, 59.39], [-31.085, 59.392], [-31.052, 59.412], [-31.049, 59.413], [-31.046, 59.415], [-31.022, 59.43], [-31.013, 59.435], [-31.01, 59.437], [-31.008, 59.439], [-30.988, 59.452], [-30.975, 59.46], [-30.972, 59.462], [-30.97, 59.464], [-30.946, 59.48], [-30.937, 59.486], [-30.935, 59.487], [-30.932, 59.489], [-30.9, 59.512], [-30.898, 59.514], [-30.896, 59.516], [-30.864, 59.54], [-30.862, 59.542], [-30.859, 59.543], [-30.844, 59.556], [-30.829, 59.568], [-30.826, 59.57], [-30.824, 59.572], [-30.794, 59.597], [-30.792, 59.599], [-30.789, 59.601], [-30.768, 59.62], [-30.76, 59.627], [-30.758, 59.629], [-30.755, 59.631], [-30.754, 59.632], [-30.727, 59.658], [-30.724, 59.66], [-30.722, 59.662], [-30.694, 59.69], [-30.692, 59.692], [-30.69, 59.694], [-30.662, 59.722], [-30.66, 59.724], [-30.658, 59.727], [-30.645, 59.741], [-30.631, 59.755], [-30.629, 59.758], [-30.627, 59.76], [-30.614, 59.775], [-30.601, 59.789], [-30.599, 59.792], [-30.597, 59.794], [-30.572, 59.824], [-30.57, 59.826], [-30.568, 59.829], [-30.543, 59.859], [-30.542, 59.862], [-30.54, 59.864], [-30.516, 59.895], [-30.516, 59.896], [-30.514, 59.898], [-30.512, 59.9], [-30.502, 59.915], [-30.489, 59.932], [-30.487, 59.935], [-30.486, 59.937], [-30.482, 59.943], [-30.464, 59.97], [-30.462, 59.972], [-30.46, 59.975], [-30.451, 59.988], [-30.439, 60.008], [-30.437, 60.01], [-30.435, 60.013], [-30.415, 60.046], [-30.413, 60.049], [-30.412, 60.052], [-30.392, 60.085], [-30.39, 60.088], [-30.389, 60.091], [-30.376, 60.114], [-30.37, 60.125], [-30.368, 60.128], [-30.367, 60.131], [-30.349, 60.165], [-30.348, 60.168], [-30.346, 60.171], [-30.329, 60.206], [-30.328, 60.209], [-30.326, 60.212], [-30.311, 60.244], [-30.31, 60.248], [-30.309, 60.25], [-30.308, 60.253], [-30.301, 60.269], [-30.292, 60.289], [-30.291, 60.292], [-30.29, 60.295], [-30.275, 60.331], [-30.274, 60.334], [-30.273, 60.337], [-30.259, 60.374], [-30.258, 60.377], [-30.257, 60.38], [-30.255, 60.387], [-30.244, 60.417], [-30.243, 60.42], [-30.242, 60.423], [-30.231, 60.46], [-30.23, 60.463], [-30.229, 60.466], [-30.22, 60.496], [-30.218, 60.504], [-30.217, 60.507], [-30.216, 60.51], [-30.206, 60.548], [-30.205, 60.55], [-30.205, 60.553], [-30.196, 60.592], [-30.195, 60.595], [-30.194, 60.598], [-30.192, 60.608], [-30.186, 60.636], [-30.186, 60.639], [-30.185, 60.642], [-30.182, 60.656], [-30.178, 60.681], [-30.177, 60.684], [-30.177, 60.687], [-30.171, 60.726], [-30.17, 60.729], [-30.17, 60.732], [-30.166, 60.759], [-30.164, 60.771], [-30.164, 60.774], [-30.164, 60.777], [-30.159, 60.816], [-30.159, 60.819], [-30.159, 60.822], [-30.156, 60.856], [-30.155, 60.861], [-30.155, 60.864], [-30.155, 60.867], [-30.152, 60.906]], [[-36.381, 53.035], [-36.38, 53.041], [-35.468, 58.214], [-33.916, 67.013], [-33.915, 67.019], [-33.921, 67.02], [-47.893, 69.484], [-47.899, 69.485], [-47.9, 69.479], [-50.364, 55.507], [-50.365, 55.501], [-50.359, 55.5], [-36.387, 53.036]], [[-57.672, 57.092], [-57.667, 57.09], [-57.664, 57.096], [-55.636, 62.669], [-52.812, 70.428], [-52.81, 70.433], [-52.816, 70.436], [-60.865, 73.365], [-66.148, 75.288], [-66.153, 75.29], [-66.156, 75.284], [-71.008, 61.952], [-71.01, 61.947], [-71.004, 61.944], [-69.105, 61.253]]];
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
