konstantindenerz/k0d3ball35/hardware/case/logo_data.scad

// generated by scripts/gen_logo.py, do not edit
// The owner wordmark from spec/images/logo.png, measured off its own grid: one cell is
// one stroke width. Coordinates are cell indices, y counted from the top of the artwork,
// the origin in its top left corner. The millimetre scale lives in params.scad
// (logo_cell and logo_stretch).

logo_grid = [18, 35];
logo_aspect = 1.524;      // cell height / cell width in the source artwork
logo_ink_cells = 327;
logo_rects = [[0, 0, 3, 1], [4, 0, 10, 1], [15, 0, 3, 1], [2, 1, 1, 2], [15, 1, 1, 2], [0, 2, 2, 1], [3, 2, 12, 1], [16, 2, 2, 1], [0, 4, 18, 1], [0, 5, 1, 28], [17, 5, 1, 28], [2, 6, 1, 25], [4, 6, 5, 1], [10, 6, 3, 1], [14, 6, 2, 1], [4, 7, 1, 24], [10, 7, 1, 24], [12, 7, 1, 24], [14, 7, 1, 24], [6, 8, 3, 1], [6, 9, 1, 20], [8, 9, 1, 20], [3, 18, 1, 1], [15, 18, 1, 1], [7, 28, 1, 1], [5, 30, 4, 1], [11, 30, 1, 1], [15, 30, 1, 1], [1, 32, 16, 1], [2, 33, 1, 2], [15, 33, 1, 2], [0, 34, 2, 1], [4, 34, 10, 1], [16, 34, 2, 1]];
