konstantindenerz/k0d3ball35/hardware/case/tray.scad

// k0d3ball35 printed case - tray, controller box cap, test part and dummies

// ---------------------------------------------------------------- tray
module tray_body() {
    // bottom: the first print layer, so its outer edge is broken (params.scad edge_chamfer)
    translate([0, 0, base_z + edge_chamfer - eps]) linear_extrude(-pcb_t - base_z - edge_chamfer + 2 * eps) outer_2d();
    chamfer_up(base_z, edge_chamfer) outer_2d();
    // rim: the edge the hand touches and the lid skirt meets. Not under the controller box,
    // whose walls stand on the rim - a chamfer there would undercut them.
    translate([0, 0, -pcb_t]) linear_extrude(rim_z + pcb_t - rim_chamfer + eps) outer_top_2d();
    // the pocket wall stops at the cup rim, not at the general rim, so the thumb reaches the ball
    // at its equator. It is CUT here rather than built lower, because the wall is not the pocket
    // block: it is what `offset(delta = wall) pcb_cavity_2d()` leaves when it grows into the PCB
    // notch, and that reaches r 12.3 around the ball whatever the block does (r2.4).
    chamfer_down(rim_z, rim_chamfer) difference() {
        outer_top_2d();
        if (controller_box) offset(delta = pcb_clear + wall) box_2d();
    }
    if (controller_box)
        translate([0, 0, rim_z - rim_chamfer - eps]) linear_extrude(rim_chamfer + eps) intersection() {
            outer_top_2d();
            offset(delta = pcb_clear + wall) box_2d();
        }
    if (controller_box)
        translate([0, 0, rim_z - eps]) linear_extrude(box_top_z - rim_z + eps) box_walls_2d();
}

module standoffs() {
    for (hp = holes(half))
        translate([hp[0], hp[1], floor_z_key - eps]) cylinder(d = standoff_d, h = standoff_h + eps);
}

module screw_holes() {
    for (hp = holes(half))
        translate([hp[0], hp[1], -pcb_t - pcb_hole_depth]) cylinder(d = screw_hole_d, h = pcb_hole_depth + 1);
}

// foot magnets: pockets from below in the thick floor under the key area, north pole down
module magnet_pockets_bottom() {
    for (c = foot_magnets(half))
        translate([c[0], c[1], base_z - 1]) cylinder(d = magnet_d, h = 1 + magnet_h + magnet_pocket_extra);
}

module tray_cuts() {
    // cavity under the key area (hot-swap sockets and diodes) and the PCB itself
    translate([0, 0, floor_z_key]) linear_extrude(-pcb_t - floor_z_key + eps) pcb_cavity_2d();
    translate([0, 0, -pcb_t]) linear_extrude(rim_z + 1 + pcb_t) pcb_cavity_2d();
    // battery well: bay plus J3 and RB1 courtyards
    translate([0, 0, well_floor_z]) linear_extrude(-pcb_t - well_floor_z + eps) well_2d();
    if (has_ball(half)) {
        translate([0, 0, pocket_floor_z]) linear_extrude(-pcb_t - pocket_floor_z + eps) pocket_well_2d();
        // open over the cradle up to the cover, then the rebate the cover sits in
        translate([0, 0, -pcb_t - eps]) linear_extrude(cover_z0 + pcb_t + 2 * eps) pocket_opening_2d();
        translate([0, 0, cover_z0]) linear_extrude(rim_z - cover_z0 + 1) cover_rebate_2d();
        for (s = cover_screws(half))
            translate([s[0], s[1], cover_z0 - cover_screw_depth]) cylinder(d = cover_screw_pilot_d, h = cover_screw_depth + 1);
        // through hole plus a 90 degree countersink, so the flat-head screws sit below the underside
        for (s = case_screws(half)) {
            translate([s[0], s[1], base_z - 1]) cylinder(d = case_screw_d, h = (pocket_floor_z - base_z) + 2);
            translate([s[0], s[1], base_z - eps])
                cylinder(d1 = case_screw_cs_d + 2 * eps, d2 = case_screw_d, h = case_screw_cs_h + eps);
        }
    }
    screw_holes();
    if (controller_box) {
        r = box_r();
        cr = ctrl_rect(half);
        // USB-C opening in the top (-y) wall: a slot open to the top, the cap's tongue closes it
        // above usb_z1 (no thin bridge over the opening)
        translate([usb_x() - usb_cut[0] / 2, box_y_in() - wall - 1, usb_z0])
            cube([usb_cut[0], wall + 2, box_top_z - usb_z0 + 1]);
        // The controller stands 0.9 mm over the main PCB's top edge (layout usb_overhang), which is
        // 0.7 mm into this wall: a pocket for its board, open to the top so it drops in.
        translate([cr[0] - ctrl_fit, cr[1] - ctrl_fit, ctrl_under_z - ctrl_fit])
            cube([cr[2] - cr[0] + 2 * ctrl_fit, box_y_in() - cr[1] + ctrl_fit + eps, box_roof_under_z - ctrl_under_z + ctrl_fit + eps]);
        // rebate for the cap plate on the tall walls
        translate([box_x_in() - box_rebate, box_y_in() - box_rebate, box_roof_under_z])
            cube([box_inner_x - box_x_in() + box_rebate + 1, r[3] - box_y_in() + box_rebate + 1, box_roof_t + 1]);
        // LED window in the inner (-x) wall near the USB end of the controller
        translate([box_x_in() - wall - 1, cr[1] + led_offset_y - led_window[0] / 2, led_z])
            cube([wall + 2, led_window[0], led_window[1]]);
    }
    // slide switch lever through the outer wall, directly under the PCB
    sw = switch(half);
    translate([box_x_in() - wall - 1, sw[1] - switch_slot[0] / 2, -pcb_t - switch_slot[1]])
        cube([wall + 2, switch_slot[0], switch_slot[1] + eps]);
    // reset pin hole through the inner wall, on the axis of the button's side plunger
    rs = reset(half);
    translate([box_x_in() - wall - 1, rs[1], reset_plunger_z]) rotate([0, 90, 0]) cylinder(d = reset_hole_d, h = wall + 2, $fn = 32);
    magnet_pockets_bottom();
    for (f = feet(half))
        translate([f[0], f[1], base_z - 1]) cylinder(d = foot_d, h = 1 + foot_recess);
    // wordmark engraved into the flat underside, cut upward so the grooves open to the bed
    if (logo_on_floor)
        logo_cut(logo_floor_pos, logo_floor_rot, logo_floor_cell, base_z + logo_depth, logo_depth);
}

// corner bosses for the cap screws: half in the wall, 3.5 mm into the box, 45 degree underside
module boss(axis, corner) {
    bh = boss_half();
    x0 = box_x_in() - wall;
    x1 = axis[0] + bh;
    y0 = corner ? box_y_in() - wall : axis[1] - bh;
    y1 = axis[1] + bh;
    z0 = box_skirt_gap;
    in = 0.5;                       // the chamfer starts inside the wall so the faces meet cleanly
    rise = x1 - box_x_in() + in;
    hull() {
        // the part inside the wall goes all the way down
        if (corner) translate([x0, y0, z0]) cube([box_x_in() - in - x0, box_y_in() - in - y0, eps]);
        else translate([x0, y0, z0]) cube([box_x_in() - in - x0, y1 - y0, eps]);
        translate([x0, y0, z0 + rise]) cube([x1 - x0, y1 - y0, box_roof_under_z - z0 - rise]);
    }
}

module bosses() {
    if (controller_box) {
        a = boss_axes();
        boss(a[0], true);
        boss(a[1], false);
    }
}

module boss_holes() {
    if (controller_box)
        for (a = boss_axes())
            translate([a[0], a[1], box_roof_under_z - screw_hole_depth]) cylinder(d = screw_hole_d, h = screw_hole_depth + 1);
}

// standoffs and bosses are added after the cavity cuts (they stand inside the cavities),
// then the screw holes are drilled
// rib on the +x pocket wall behind the sensor module (params.scad, module_stop_*)
module module_stop() {
    if (has_ball(half)) {
        x0 = bc()[0] + module_reach + module_stop_gap;
        x1 = maxx(housing_box(half)) + 0.5;                 // the pocket wall (pocket_well_2d)
        translate([x0, bc()[1] + module_stop_dy - module_stop_w / 2, pocket_floor_z - eps])
            cube([x1 - x0 + 1, module_stop_w, module_stop_top_z - pocket_floor_z + eps]);
    }
}

module tray() {
    difference() {
        union() {
            difference() { tray_body(); tray_cuts(); }
            standoffs();
            bosses();
            module_stop();
        }
        screw_holes();
        boss_holes();
    }
}

// ---------------------------------------------------------------- controller box cap
// Roof plate in the rebate plus an L-shaped skirt (key side and thumb side) that stands on the
// PCB. Two countersunk M2 machine screws into the bosses, flush. Prints roof-down.
module box_cap() {
    r = box_r();
    x0 = box_x_in() - box_rebate + box_fit;
    y0 = box_y_in() - box_rebate + box_fit;
    x1 = box_inner_x;
    y1 = r[3];
    ys = box_y_in() + box_fit;
    xs = boss_x_end() + box_fit;
    h = box_roof_under_z - box_skirt_z + eps;
    difference() {
        union() {
            translate([x0, y0, box_roof_under_z]) cube([x1 - x0, y1 - y0, box_roof_t]);
            translate([x1 - box_skirt_t, ys, box_skirt_z]) cube([box_skirt_t, y1 - ys, h]);
            translate([xs, y1 - box_skirt_t, box_skirt_z]) cube([x1 - xs, box_skirt_t, h]);
            // tongue that closes the USB slot of the wall above the opening
            translate([usb_x() - usb_cut[0] / 2 + box_fit, box_y_in() - wall, usb_z1])
                cube([usb_cut[0] - 2 * box_fit, y0 - (box_y_in() - wall) + eps, box_top_z - usb_z1]);
        }
        // two countersunk M2: 90 degree sinks from the top, heads flush like the pocket cover's
        for (a = boss_axes()) {
            translate([a[0], a[1], box_roof_under_z - 1]) cylinder(d = cap_screw_d, h = box_roof_t + 2);
            translate([a[0], a[1], box_top_z - (cap_screw_head_d - cap_screw_d) / 2 + eps])
                cylinder(d1 = cap_screw_d, d2 = cap_screw_head_d + 2 * eps, h = (cap_screw_head_d - cap_screw_d) / 2, $fn = 32);
        }
        // room for the plug's overmold under the plate edge, back to the receptacle face
        translate([usb_x() - usb_cut[0] / 2, y0 - 1, box_roof_under_z - eps])
            cube([usb_cut[0], ctrl_rect(half)[1] - usb_face_in + 0.3 - y0 + 1, usb_z1 - box_roof_under_z + eps]);
        if (logo_on_cap) logo_cut(logo_cap_pos, 0, logo_cell, box_top_z, logo_depth);
    }
}

// ---------------------------------------------------------------- pocket cover
// Flush plate over the cradle opening: same top as the rim, reaching over the cup rim as a bezel
// that ends cover_ball_gap from the ball, two countersunk M2 at the user-side corners, two small
// holes for the optional clip's pins. Prints top down.
module pocket_cover() {
    c = bc();
    difference() {
        translate([0, 0, cover_z0]) linear_extrude(cover_t) cover_2d();
        translate([c[0], c[1], cover_z0 - eps]) {
            cylinder(d = cover_hole_d, h = cover_t + 2 * eps, $fn = 128);
            translate([0, 0, cover_t - cover_chamfer + eps])
                cylinder(d1 = cover_hole_d, d2 = cover_hole_d + 2 * cover_chamfer + 2 * eps, h = cover_chamfer + eps, $fn = 128);
        }
        // the two holes the optional clip's snap pins go through
        for (p = clip_pins()) translate([c[0] + p[0], c[1] + p[1], cover_z0 - 1]) cylinder(d = cover_pin_hole_d, h = cover_t + 2, $fn = 32);
        for (s = cover_screws(half)) {
            translate([s[0], s[1], cover_z0 - 1]) cylinder(d = cover_screw_d, h = cover_t + 2);
            translate([s[0], s[1], rim_z - (cover_screw_head_d - cover_screw_d) / 2 + eps])
                cylinder(d1 = cover_screw_d, d2 = cover_screw_head_d + 2 * eps, h = (cover_screw_head_d - cover_screw_d) / 2, $fn = 32);
        }
    }
}

// ---------------------------------------------------------------- retainer clip (optional)
// Ball-centred frame (the STL is exported like the cradle's, centred on the ball); the assembly
// places it with translate(bc()). See params.scad clip_* for what each part is for.

// the arc beyond +-clip_open_az, cut off so the thumb's approach stays open (less than 180 degrees
// wide, so the intersection of two half spaces)
module clip_open_sector() {
    intersection() {
        translate([0, 0, -50]) cylinder(r = clip_ro + 5, h = 100);
        rotate([0, 0, clip_open_az])  translate([-100, 0, -100])    cube([200, 200, 200]);
        rotate([0, 0, -clip_open_az]) translate([-100, -200, -100]) cube([200, 200, 200]);
    }
}

// A claw over the ball's shoulder: a shell whose inner face is the cup's sphere (clip_ball_gap
// from the ball), backed by a 45 degree taper from the ring's outer edge so it prints without
// support. Below the equator the inner face would continue as a cylinder (hull), so lifting the
// clip straight up only ever moves the claw away from the ball.
module clip_claw(az) {
    zc = ball_centre_z();
    intersection() {
        difference() {
            union() {
                translate([0, 0, zc]) sphere(r = clip_rin + clip_claw_t, $fn = 96);
                translate([0, 0, clip_z1 - eps])
                    cylinder(h = clip_ro - 0.3 - clip_rin, r1 = clip_ro - 0.3, r2 = clip_rin, $fn = 96);
            }
            hull() {
                translate([0, 0, zc]) sphere(r = clip_rin, $fn = 96);
                translate([0, 0, zc - 20]) cylinder(r = clip_rin, h = 20, $fn = 96);
            }
        }
        rotate([0, 0, az]) translate([0, -clip_claw_w / 2, clip_z0]) cube([clip_ro + 1, clip_claw_w, clip_top_z() - clip_z0]);
    }
}

// A pin's barb, as a wedge on one prong in the y-z plane (y outward from the slit): 45 degree
// lead-in at the tip, a short flat, the release face at clip_release degrees from horizontal up to
// the catch 0.05 mm under the cover. Its inner face runs well inside the pin and its tip starts
// 0.05 above the pin's, so none of its faces lies in one of the pin's.
function barb_z_top() = cover_z0 - 0.05;
function barb_z_bot() = barb_z_top() - clip_pin_barb * tan(clip_release) - 0.1 - clip_pin_barb;
module barb() {
    r0 = clip_pin_d / 2; r1 = r0 + clip_pin_barb; zb = barb_z_bot() + 0.05; yi = 0.6;
    rotate([90, 0, 90]) linear_extrude(height = 1.2, center = true)
        polygon([[yi, zb], [r0, zb], [r1, zb + clip_pin_barb],
                 [r1, barb_z_top() - clip_pin_barb * tan(clip_release)],
                 [r0, barb_z_top()], [yi, barb_z_top()]]);
}

// A split snap pin at the origin, local x radial: the slit lies in the x-z plane, so the two
// prongs spring towards each other tangentially and the barbs sit on the faces they move with.
module clip_pin() {
    difference() {
        union() {
            translate([0, 0, barb_z_bot()]) cylinder(d = clip_pin_d, h = clip_z0 - barb_z_bot() + eps, $fn = 32);
            barb();
            mirror([0, 1, 0]) barb();
        }
        // the slit runs up into the ring to 0.4 under its top, which is what makes the prongs long
        translate([-5, -clip_pin_slit / 2, barb_z_bot() - 1]) cube([10, clip_pin_slit, clip_z1 - 0.4 - barb_z_bot() + 1]);
    }
}

module pocket_clip() {
    difference() {
        union() {
            translate([0, 0, clip_z0]) difference() {
                cylinder(r = clip_ro, h = clip_ring_t, $fn = 128);
                translate([0, 0, -1]) cylinder(r = clip_ri, h = clip_ring_t + 2, $fn = 128);
            }
            for (s = [-1, 1]) clip_claw(s * clip_claw_az);
        }
        clip_open_sector();
        for (p = clip_pins()) translate([p[0], p[1], 0]) rotate([0, 0, atan2(p[1], p[0])])
            translate([-5, -clip_pin_slit / 2, barb_z_bot() - 1]) cube([10, clip_pin_slit, clip_z1 - 0.4 - barb_z_bot() + 1]);
    }
    for (p = clip_pins()) translate([p[0], p[1], 0]) rotate([0, 0, atan2(p[1], p[0])]) clip_pin();
}

// ---------------------------------------------------------------- PCB guard
// Lies on the PCB top between the switches, held down by the switch flanges (common.scad
// guard_2d). Prints flat; the DXF (part guard2d) is the same outline for a laser-cut sheet.
module guard() linear_extrude(guard_t) guard_2d();

// ---------------------------------------------------------------- pocket test print
module pocket_test() {
    c = bc();
    intersection() {
        tray();
        translate([c[0] - 25, c[1] - 25, base_z - 1]) cube([50, 50, rim_z - base_z + 2]);
    }
}

// ---------------------------------------------------------------- PCB test print
// The main board as a printed plate, to try the case, the cradle and the switches before the
// boards are ordered: outline with the ball notch, the mounting holes, every drill of the switch
// footprints (data.scad switch_holes) and J1 as a block on the key side. Not printed: the
// controller's 1 mm holes. Prints as it lies, back face on the bed.
module pcb_test() {
    translate([0, 0, -pcb_t]) linear_extrude(pcb_t) difference() {
        pcb_2d();
        for (hp = holes(half)) translate(hp) circle(d = 2.2 + test_hole_fit);
        for (k = keys(half)) translate([k[0], k[1]]) rotate(-k[2])
            for (sh = switch_holes(half)) translate([sh[0], sh[1]]) circle(d = sh[2] + test_hole_fit);
    }
    if (has_ball(half)) translate([0, 0, -0.01]) polygon_box(fpc_body(half), 2.0 + 0.01);
}

// ---------------------------------------------------------------- dummies for views
module pcb_dummy() {
    color("darkgreen") translate([0, 0, -pcb_t]) linear_extrude(pcb_t) pcb_2d();
    // what sits on the PCB top besides the switches: the five M2 heads (BOM max 3.5 mm) and J1
    color("silver") for (hp = holes(half)) translate([hp[0], hp[1], 0]) cylinder(d = 3.5, h = 1.3);
    if (has_ball(half)) {
        color("black") polygon_box(fpc_body(half), 2.0);
        color("gold") polygon_box(fpc_tails(half), 0.15);
    }
}
module polygon_box(p, h) linear_extrude(h) polygon(p);

module keys_dummy() {
    for (k = keys(half)) translate([k[0], k[1], 0]) rotate(-k[2]) {
        color("dimgray") translate([-6.9, -6.9, 0]) cube([13.8, 13.8, 5]);
        color("ivory") translate([-8.75, -8.25, 5]) cube([17.5, 16.5, cap_top_z - 5]);
    }
}

module controller_dummy() {
    cr = ctrl_rect(half);
    sh = 2.5;
    // the two socket strips (2.54 mm pitch, rows 15.24 apart) and the radio module's can
    color("black") for (sx = [-1, 1]) translate([usb_x() + sx * 7.62 - 1.3, cr[1] + 1.5, 0]) cube([2.6, cr[3] - cr[1] - 3, sh]);
    color("silver") translate([usb_x() - 5, cr[3] - 16, sh + 1.6]) cube([10, 13, ctrl_top_z - sh - 1.6 - 0.4]);
    color("steelblue") translate([cr[0], cr[1], sh]) cube([cr[2] - cr[0], cr[3] - cr[1], 1.6]);
    color("silver") translate([usb_x() - 4.5, cr[1] - usb_face_in, ctrl_top_z - usb_shell_h]) cube([9, 7.35, usb_shell_h]);
}

module battery_dummy() {
    b = bay(half);
    color("gold") translate([(minx(b) + maxx(b)) / 2 - 10.25, (miny(b) + maxy(b)) / 2 - 18.75, well_floor_z]) cube([20.5, 37.5, 5.7]);
}

module ball_dummy() color("white") translate([bc()[0], bc()[1], ball_centre_z()]) sphere(d = ball_d);

// The printed cradle itself in the assembly views (its STL is in the print frame and centred on
// the ball: mirror y back to the layout frame and move it to the ball). Until the r2.4 fix this was
// a stand-in drawn from copied numbers, which drifted away from the real part.
module cradle_dummy()
    color("royalblue") translate([bc()[0], bc()[1], 0]) mirror([0, 1, 0])
        import("../trackball-cradle/stl/cradle-19mm-pocket.stl");

// The bought sensor module in its sleeve: the cradle's own dummy (cradle.scad sensor_dummy),
// exported next to the cradle STL and placed the same way.
module sensor_module_dummy()
    color("seagreen") translate([bc()[0], bc()[1], 0]) mirror([0, 1, 0])
        import("../trackball-cradle/ref/sensor-module.stl");

// The FFC as the build guide lays it (data.scad ffc_path, from scripts/k0d3/ffc_route.py): each
// point is x, y, z and the band's roll about its own direction, 0 upright and 90 flat.
module ffc_section(i) {
    pp = ffc_path(half);
    p = pp[i];
    a = pp[max(i - 1, 0)];
    b = pp[min(i + 1, len(pp) - 1)];
    translate([p[0], p[1], p[2]]) rotate([0, 0, atan2(b[1] - a[1], b[0] - a[0])]) rotate([-p[3], 0, 0])
        cube([0.01, ffc_t, ffc_w], center = true);
}
module ffc_dummy()
    color("orange") for (i = [0 : len(ffc_path(half)) - 2]) hull() { ffc_section(i); ffc_section(i + 1); }

// A 90 degree flat-head screw: head face at the origin, thread along +z, length over all.
module flat_head_screw(len, head_d, d = 2.0) {
    cylinder(d1 = head_d, d2 = d, h = (head_d - d) / 2, $fn = 32);
    cylinder(d = d, h = len, $fn = 24);
}

// Every screw the PCB dummy does not carry: the two countersunk M2 x 5 of the box cap, and on
// the ball half the M2 x 8 from below into the cradle and the M2 x 6 of the cover.
module cap_screws_dummy()
    color("silver") if (controller_box) for (a = boss_axes()) translate([a[0], a[1], box_top_z]) mirror([0, 0, 1])
        flat_head_screw(5, cap_screw_head_d);
module cradle_screws_dummy()
    color("silver") for (s = case_screws(half)) translate([s[0], s[1], base_z + (case_screw_cs_d - case_screw_head_d) / 2])
        flat_head_screw(8, case_screw_head_d);
module cover_screws_dummy()
    color("silver") for (s = cover_screws(half)) translate([s[0], s[1], rim_z]) mirror([0, 0, 1])
        flat_head_screw(6, cover_screw_head_d);
module screws_dummy() { cap_screws_dummy(); cradle_screws_dummy(); cover_screws_dummy(); }

// The seven 10 x 1 mm rubber feet, glued into their recesses: 0.2 mm proud of the underside.
module feet_dummy()
    color("dimgray") for (f = feet(half)) translate([f[0], f[1], base_z + foot_recess - foot_h])
        cylinder(d = foot_d - 0.5, h = foot_h, $fn = 48);
