konstantindenerz/k0d3ball35/(list of files, cad)

Other CAD files:
hardware/case/dxf/floor-left.dxf
hardware/trackball-cradle/dxf/floor-19mm-pocket.dxf
hardware/case/dxf/floor-right.dxf
hardware/case/stl/box-cap-right.stl
hardware/case/dxf/guard-left.dxf
hardware/case/dxf/guard-right.dxf
