konstantindenerz/k0d3ball35/hardware/case/preview/assembly-left.png

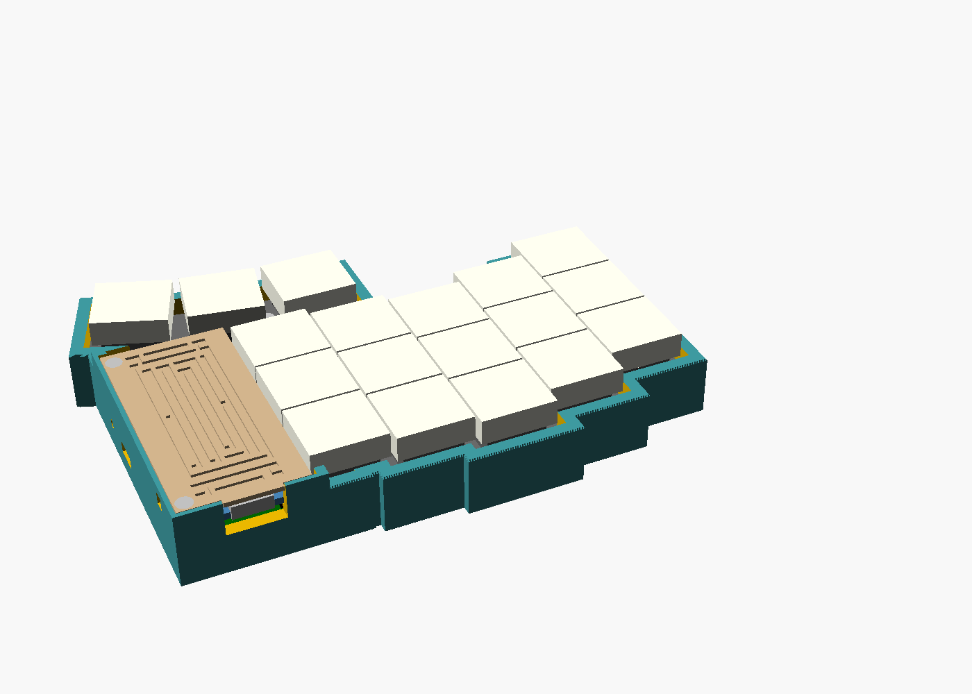
hardware/case/preview/assembly-left.png
