konstantindenerz/k0d3ball35/hardware/case/preview/assembly-right.png

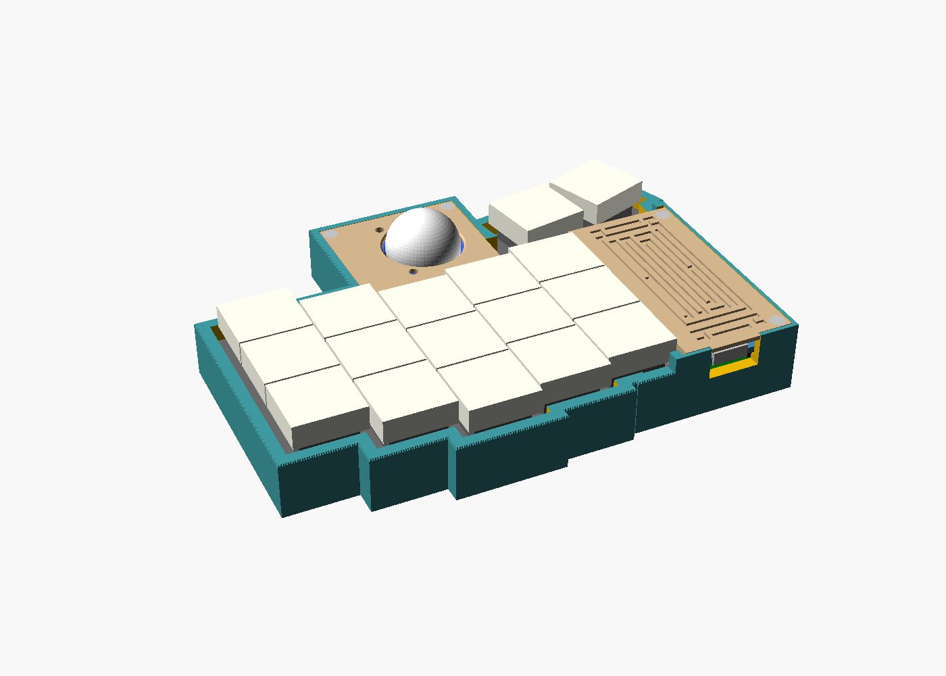
hardware/case/preview/assembly-right.png
