konstantindenerz/k0d3ball35/hardware/trackball-cradle/preview/assembly-19mm-pocket.png

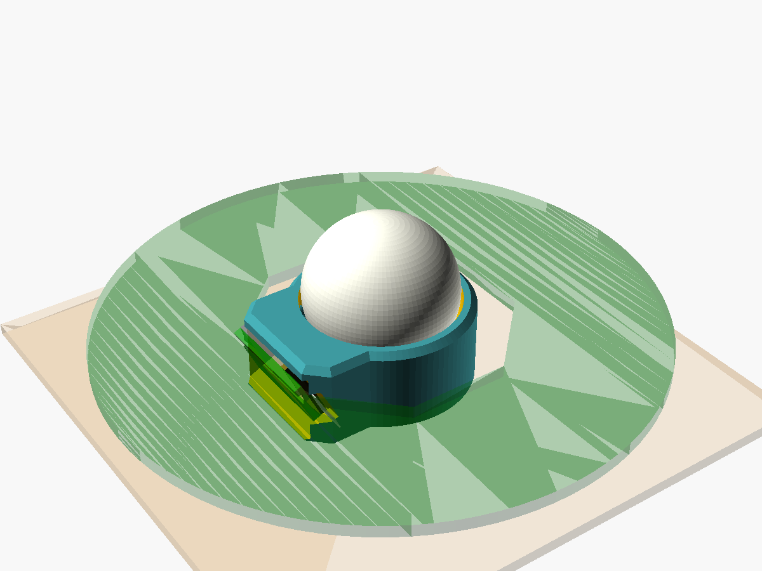
hardware/trackball-cradle/preview/assembly-19mm-pocket.png
