konstantindenerz/k0d3ball35/issues/hw-ball-colour-tracking-test.md

---
title: Test ball colours and materials on the PAW3222 module
type: task
priority: P1
status: open
area: hw
created: 2026-11-05
---

# Test ball colours and materials on the PMW3610

## Context

Translucent, glossy white and some plastic small balls (25 mm reports; the r2 ball is 19.05 mm POM) track badly on optical sensors; matte Perixx and Elecom balls are reported to work. The BOM lists two balls.

## Acceptance criteria

- [ ] Both BOM balls and one white ball tested on the assembled sensor board
- [ ] Result recorded in spec/03-bom.md and spec/08-trackball-module.md

## Notes

None yet.
