konstantindenerz/k0d3ball35/issues/test-bench-procedure.md

---
title: Bench test procedure for assembled halves
type: task
priority: P2
status: open
area: test
created: 2026-11-05
---

# Bench test procedure for assembled halves

## Context

A written procedure a builder follows after soldering: continuity between controller pads and
rows/columns, diode direction, matrix test in ZMK Studio or a key tester, sensor product ID read in
the ZMK log, battery charging indicator, BLE pairing, CPI sanity. Drafted in `spec/07-testing.md`.

## Acceptance criteria

- [ ] Procedure covers both halves and the sensor board
- [ ] Expected values given for each step (resistance, log line, LED behaviour)
- [ ] Executed once on real hardware and corrected

## Notes

None yet.
