konstantindenerz/k0d3ball35/issues/README.md

# Issues

Tickets for features, bugs, questions and tasks. One markdown file per ticket,
see `spec/01-design-spec.md` section 7 for the convention.
This index is generated by `scripts/issues.py`; do not edit it by hand.

| Status | Count |
|---|---|
| open | 39 |
| in-progress | 8 |
| done | 29 |
| wontfix | 7 |

## open

| Priority | Ticket | Type | Area | Title | Created |
|---|---|---|---|---|---|
| P0 | [hw-battery-plug-polarity](hw-battery-plug-polarity.md) | task | hw | Check the battery plug polarity of both cells against J3 before first power | 2026-11-12 |
| P0 | [hw-main-pcb-review-r1](hw-main-pcb-review-r1.md) | task | hw | Manual review of both main PCBs (r2) before ordering | 2026-11-05 |
| P1 | [doc-build-guide](doc-build-guide.md) | task | doc | Step-by-step build guide | 2026-11-05 |
| P1 | [fw-cursor-axis-verification](fw-cursor-axis-verification.md) | task | fw | Verify trackball cursor axes on the first board | 2026-11-05 |
| P1 | [hw-19mm-ball-sourcing](hw-19mm-ball-sourcing.md) | task | hw | Secure a repeatable supply of 19.05 mm trackballs and test their surface | 2026-11-05 |
| P1 | [hw-ball-colour-tracking-test](hw-ball-colour-tracking-test.md) | task | hw | Test ball colours and materials on the PAW3222 module | 2026-11-05 |
| P1 | [hw-ffc-pin-order-verification](hw-ffc-pin-order-verification.md) | task | hw | Verify the 6-pin FFC pin order between main PCB and sensor module | 2026-11-05 |
| P1 | [hw-jlcpcb-order-r1](hw-jlcpcb-order-r1.md) | task | hw | Order the first PCBs (left and right) at JLCPCB | 2026-11-05 |
| P1 | [infra-ci-firmware](infra-ci-firmware.md) | task | infra | CI build of both halves with ZMK | 2026-11-05 |
| P1 | [infra-ci-hardware](infra-ci-hardware.md) | task | infra | CI gates for ERC, DRC and gerber export | 2026-11-05 |
| P1 | [mech-ball-height-23mm](mech-ball-height-23mm.md) | task | mech | Ball top 23.75 mm over the desk - verify the r2.4 flat stack on a print | 2026-11-05 |
| P1 | [mech-review-fixes-test-print](mech-review-fixes-test-print.md) | task | mech | Test print after the 2026-11-12 review fixes | 2026-11-12 |
| P1 | [test-fab-gerber-viewer](test-fab-gerber-viewer.md) | task | test | Check the gerber zip in a gerber viewer before ordering | 2026-11-05 |
| P2 | [doc-video-source-summary](doc-video-source-summary.md) | task | doc | Summarise the reference build video in the docs | 2026-11-05 |
| P2 | [doc-zmk-yml-repo-url](doc-zmk-yml-repo-url.md) | task | doc | Replace the placeholder repository URL in k0d3ball35.zmk.yml | 2026-11-05 |
| P2 | [fw-battery-drain-measurement](fw-battery-drain-measurement.md) | task | fw | Measure real battery drain per half | 2026-11-05 |
| P2 | [fw-cpi-tuning-19mm](fw-cpi-tuning-19mm.md) | task | fw | Tune CPI, scaling and scroll divisors for the 19 mm ball | 2026-11-05 |
| P2 | [fw-physical-layout-exact-coords](fw-physical-layout-exact-coords.md) | task | fw | Regenerate the physical layout from the exact key coordinates | 2026-11-05 |
| P2 | [fw-runtime-pointer-settings](fw-runtime-pointer-settings.md) | feature | fw | Runtime CPI steps, sniping toggle and auto-mouse timeout keys | 2026-11-05 |
| P2 | [fw-scroll-axis-lock](fw-scroll-axis-lock.md) | feature | fw | Scroll snap and axis lock for the trackball | 2026-11-05 |
| P2 | [fw-split-sleep-wake-check](fw-split-sleep-wake-check.md) | task | fw | Verify peripheral wake from deep sleep | 2026-11-05 |
| P2 | [hw-gnd-stitching-review](hw-gnd-stitching-review.md) | task | hw | Review the automatic GND stitching vias and the pours | 2026-11-05 |
| P2 | [mech-thumb-arc-tuning](mech-thumb-arc-tuning.md) | task | mech | Expose and test-print thumb arc variants | 2026-11-05 |
| P2 | [test-bench-procedure](test-bench-procedure.md) | task | test | Bench test procedure for assembled halves | 2026-11-05 |
| P3 | [doc-keyball-owner-migration](doc-keyball-owner-migration.md) | task | doc | Migration page for Keyball39 owners | 2026-11-05 |
| P3 | [fw-ball-motion-wake](fw-ball-motion-wake.md) | feature | fw | Wake from deep sleep on ball motion | 2026-11-05 |
| P3 | [fw-input-split-dongle](fw-input-split-dongle.md) | feature | fw | Support left-ball and dongle builds via zmk,input-split | 2026-11-05 |
| P3 | [fw-one-handed-scroll-toggle](fw-one-handed-scroll-toggle.md) | feature | fw | Toggle variant of the scroll layer | 2026-11-05 |
| P3 | [fw-remap-compatibility](fw-remap-compatibility.md) | feature | fw | Remap (remap-keys.app) compatibility | 2026-11-05 |
| P3 | [hw-drc-severity-overrides](hw-drc-severity-overrides.md) | task | hw | Eight DRC rules are downgraded to warning, six without a substitute test | 2026-11-07 |
| P3 | [hw-solder-only-variant](hw-solder-only-variant.md) | feature | hw | Solder-only PCB variant without hot-swap sockets | 2026-11-05 |
| P3 | [hw-spare-pin-features](hw-spare-pin-features.md) | feature | hw | Use the spare controller pins (encoder, display) in a later PCB revision | 2026-11-05 |
| P3 | [infra-pcba-export](infra-pcba-export.md) | feature | infra | PCBA order option (position file, BOM with LCSC numbers) | 2026-11-05 |
| P3 | [mech-cradle-bearing-seat-skin](mech-cradle-bearing-seat-skin.md) | bug | mech | Bearing seats in the cradle start exactly at the cup surface | 2026-11-10 |
| P3 | [mech-cradle-btu-variant](mech-cradle-btu-variant.md) | feature | mech | Ball transfer unit cradle variant | 2026-11-05 |
| P3 | [mech-ffc-cover-tab](mech-ffc-cover-tab.md) | feature | mech | Cover the FFC where it climbs beside the cup | 2026-11-06 |
| P3 | [mech-keycaps](mech-keycaps.md) | feature | mech | Printed dished Choc keycap set | 2026-11-05 |
| P3 | [mech-pinky-column-springs](mech-pinky-column-springs.md) | task | mech | Recommend light springs for the outer column | 2026-11-05 |
| P3 | [mech-pocket-hatch-alternative](mech-pocket-hatch-alternative.md) | question | mech | Plug-on sensor board with a floor hatch instead of the FFC | 2026-11-06 |

## in-progress

| Priority | Ticket | Type | Area | Title | Created |
|---|---|---|---|---|---|
| P1 | [doc-assembly-order-mismatch](doc-assembly-order-mismatch.md) | bug | doc | Assembly order in the docs did not match the hardware | 2026-11-06 |
| P1 | [hw-paw3222-variant](hw-paw3222-variant.md) | feature | hw | PAW3222 sensor module as the trackball sensor | 2026-11-05 |
| P1 | [mech-case-ball-pocket](mech-case-ball-pocket.md) | feature | mech | Case pocket for the 19 mm ball beside the right PCB | 2026-11-06 |
| P2 | [hw-branding-logo](hw-branding-logo.md) | feature | hw | Branding on the PCBs and the case with the owner's logo | 2026-11-06 |
| P2 | [mech-ball-retainer-clip](mech-ball-retainer-clip.md) | feature | mech | Optional clip-on ball retainer with two claws away from the thumb | 2026-11-10 |
| P2 | [mech-case](mech-case.md) | feature | mech | Boxy angular 3D printed case with raised controller box and ball pocket | 2026-11-05 |
| P2 | [mech-case-lid](mech-case-lid.md) | feature | mech | Hinged lid per half that doubles as a tenting foot | 2026-11-06 |
| P3 | [mech-pcb-guard](mech-pcb-guard.md) | feature | mech | PCB guard between the switches without extra height | 2026-11-11 |

## done

| Priority | Ticket | Type | Area | Title | Created |
|---|---|---|---|---|---|
| P0 | [fw-zmk-shield](fw-zmk-shield.md) | feature | fw | ZMK shield k0d3ball35 with trackball on the central half | 2026-11-05 |
| P0 | [hw-left-pcb-mirror](hw-left-pcb-mirror.md) | bug | hw | Left PCB is not mirrored (second right-handed board) | 2026-11-06 |
| P0 | [hw-main-pcb-r1](hw-main-pcb-r1.md) | feature | hw | Main PCB revision 1 (reversible, 18 keys, controller, FPC, battery) - superseded by r2 | 2026-11-05 |
| P0 | [hw-sensor-pcb-r1](hw-sensor-pcb-r1.md) | feature | hw | PMW3610 sensor daughterboard revision 1 | 2026-11-05 |
| P0 | [hw-two-pcbs-r2](hw-two-pcbs-r2.md) | feature | hw | r2 - two PCBs (15+3 / 15+2), stepped outline, 19 mm ball pocket beside the right PCB | 2026-11-06 |
| P0 | [mech-case-stl-mirrored](mech-case-stl-mirrored.md) | bug | mech | Case and cradle STLs are the mirror image of the boards | 2026-11-10 |
| P0 | [mech-cradle-real-module](mech-cradle-real-module.md) | bug | mech | Cradle drawn for the real PAW3222 module, FFC 40 mm, type A warning | 2026-11-12 |
| P0 | [mech-trackball-cradle](mech-trackball-cradle.md) | feature | mech | Parametric trackball cradle with ceramic ball seats (19 mm pocket mount, 25 mm variant) | 2026-11-05 |
| P1 | [hw-ball-inboard-r2-3](hw-ball-inboard-r2-3.md) | feature | hw | Move the ball inboard and give the right half the two inner thumb keys | 2026-11-07 |
| P1 | [hw-battery-bay-both-halves](hw-battery-bay-both-halves.md) | feature | hw | Battery bay under the controller on both halves, controller on low-profile sockets | 2026-11-06 |
| P1 | [hw-cradle-flange-holes-at-edge](hw-cradle-flange-holes-at-edge.md) | bug | hw | Cradle flange holes too close to the PCB edge | 2026-11-05 |
| P1 | [hw-j1-top-side](hw-j1-top-side.md) | bug | hw | Move J1 to the key side of the right PCB and use a type B FFC | 2026-11-06 |
| P1 | [hw-msk12c02-pad-pitch](hw-msk12c02-pad-pitch.md) | question | hw | Verify the MSK-12C02 pad pitch against a physical switch | 2026-11-07 |
| P1 | [hw-sensor-pcb-constraints](hw-sensor-pcb-constraints.md) | task | hw | Sensor PCB must match the cradle geometry | 2026-11-05 |
| P1 | [hw-sensor-stack-height](hw-sensor-stack-height.md) | question | hw | Ball-bottom-to-sensor stack height vs low profile | 2026-11-05 |
| P1 | [mech-cap-screw-heads-under-lid](mech-cap-screw-heads-under-lid.md) | bug | mech | Box cap screw heads stand in the closed lid | 2026-11-12 |
| P1 | [mech-cradle-notch-relief](mech-cradle-notch-relief.md) | bug | mech | Make the trackball module a cartridge that clears the PCB notch | 2026-11-06 |
| P1 | [mech-cradle-sensor-26mm](mech-cradle-sensor-26mm.md) | task | mech | Update the cradle for the 26 x 25 mm sensor board | 2026-11-05 |
| P1 | [mech-lens-height-ffc-slack](mech-lens-height-ffc-slack.md) | bug | mech | Lens height from the datasheet, 50 mm FFC with an S-fold | 2026-11-12 |
| P1 | [mech-sensor-side-x](mech-sensor-side-x.md) | task | mech | Sensor module leans to +x, the ball pocket shrinks the case by 5 mm | 2026-11-11 |
| P2 | [doc-exploded-view-3d](doc-exploded-view-3d.md) | feature | doc | Interactive 3D exploded view of one half | 2026-11-05 |
| P2 | [doc-website-tabs](doc-website-tabs.md) | feature | doc | Project website with tabs for the real 3D files, PCBs, keymap and BOM | 2026-11-10 |
| P2 | [hw-fpc-connector-bom-mismatch](hw-fpc-connector-bom-mismatch.md) | bug | hw | BOM listed FH19SC while the footprint is FH12-6S | 2026-11-05 |
| P2 | [hw-hotswap-only](hw-hotswap-only.md) | task | hw | Revision 1 is hot-swap only | 2026-11-05 |
| P2 | [hw-jst-connector-height](hw-jst-connector-height.md) | task | hw | JST-PH battery connector is 6 mm tall | 2026-11-05 |
| P2 | [hw-left-bay-inner-sockets](hw-left-bay-inner-sockets.md) | bug | hw | Left board: inner column hot-swap sockets reach into the battery bay | 2026-11-06 |
| P2 | [mech-assembly-reference-parts](mech-assembly-reference-parts.md) | task | mech | Bought parts in the assembly, the interference test and the Explorer | 2026-11-12 |
| P3 | [hw-freerouting-rotated-footprints](hw-freerouting-rotated-footprints.md) | task | hw | Autorouter does not reach footprints rotated by 10 or 20 degrees | 2026-11-05 |
| P3 | [mech-case-screw-heads-flush](mech-case-screw-heads-flush.md) | bug | mech | Cradle screw heads should sit flush in the case floor | 2026-11-07 |

## wontfix

| Priority | Ticket | Type | Area | Title | Created |
|---|---|---|---|---|---|
| P0 | [hw-sensor-vcsel-pins](hw-sensor-vcsel-pins.md) | question | hw | Confirm the PMW3610 VCSEL and laser pins against the datasheet | 2026-11-07 |
| P1 | [fw-left-half-pin-mirror](fw-left-half-pin-mirror.md) | task | fw | Left half uses the mirrored controller pins | 2026-11-05 |
| P1 | [mech-lm18-lens-outline-measurement](mech-lm18-lens-outline-measurement.md) | task | mech | Measure the real LM18-LSI lens outline | 2026-11-05 |
| P2 | [hw-battery-under-controller-fit](hw-battery-under-controller-fit.md) | task | hw | Verify the 3.3 mm cell fits under the socketed controller | 2026-11-05 |
| P2 | [mech-case-ball-dome](mech-case-ball-dome.md) | task | mech | Plan the ball dome and tenting in the case | 2026-11-05 |
| P3 | [hw-25mm-cradle-fallback](hw-25mm-cradle-fallback.md) | feature | hw | 25 mm pocket cradle as fallback (needs a wider notch) | 2026-11-05 |
| P3 | [hw-d0-grounded](hw-d0-grounded.md) | task | hw | D0 (P0.08) is tied to GND on both halves | 2026-11-05 |
