konstantindenerz/k0d3ball35/issues/mech-trackball-cradle.md

---
title: Parametric trackball cradle with ceramic ball seats (19 mm pocket mount, 25 mm variant)
type: feature
priority: P0
status: done
area: mech
created: 2026-11-05
---

# Parametric trackball cradle with ceramic ball seats (19 mm pocket mount, 25 mm variant)

## Context

3D printed cradle holding the ball on three 2 mm ZrO2 ceramic balls at 120 degrees, with a pocket
for the sensor PCB giving a lens-to-ball distance of 2.4 to 2.9 mm, and a flange screwed to the main
PCB cradle holes (r1; since r2 the module stands on the case floor). Parametric in
ball diameter (19.05 mm pocket mount default since r2, 25 mm pocket as fallback, the r1 25 mm cutout mount kept for reference).

## Acceptance criteria

- [x] OpenSCAD source in `hardware/trackball-cradle/` (`cradle.scad`, `params.scad`) with ball diameter, bearing diameter, lens distance and wall thickness as parameters
- [x] STL exported for 19.05 mm pocket, 25 mm pocket and 25 mm cutout; floor footprint DXF for the case
- [x] Printed test fit checklist (ball spins freely, no wobble, sensor reads at the target distance) in `hardware/trackball-cradle/README.md`, referenced from `spec/08-trackball-module.md`
- [x] The cradle test print runs in parallel with the PCB order: the sensor height comes from `params.scad`, the notch is fixed by the layout and its tests, and the only PCB-changing outcome (25 mm ball) cannot be tested without the sensor PCB anyway (`hw-jlcpcb-order-r1`, `hw-sensor-stack-height`)

## Notes

Depends on hw-sensor-stack-height for the final sensor orientation.

2026-11-05: cradle.scad renders 25 mm and 34 mm variants, retainer ring, tilted variant evaluated; stack heights in stack.json. Ball height follow-up in mech-ball-height-23mm.

2026-11-06: retainer (claw ring, pegs, rim holes) removed by decision: the rim stays 1 mm below the equator, the ball is held by gravity, the removable case lid (`mech-case-lid`) covers it in transport. `stack.json` lost `claw_top_z` / `retainer_ball_play` and gained `rim_below_equator`.

2026-11-06: `mount = "pocket"` added for r2: the module stands on the case floor beside the right PCB (housing 29 x 29 mm, cable slot towards the keys), 19.05 mm default, ball top +17.1 mm, 24.1 mm wide above the PCB (fits the 15 mm notch apothem); 25 mm pocket needs a 16.5 mm apothem. Test print still pending.

2026-11-06: screw ears dropped. The two sensor posts are drilled through and take the case screws (M2 x 10 from below through floor and sensor board, 20 mm apart on the y axis, `case_screw_sp` in `stack.json`); the floor footprint is the bare 29 x 29 mm housing, so the case pocket below the PCB plane is a 34 x 34 mm rounded rectangle (`mech-case-ball-pocket`).

2026-11-10: optional clip-on retainer back as a separate part (`mech-ball-retainer-clip`): two claws at +-80 degrees, none on the thumb side, snap fingers into pockets in the cup wall; the cup gained a rim chamfer and four pockets, still nothing above the rim. Checked by `retention.py` / `retention.json`.
