konstantindenerz/k0d3ball35/issues/doc-video-source-summary.md

---
title: Summarise the reference build video in the docs
type: task
priority: P2
status: open
area: doc
created: 2026-11-05
---

# Summarise the reference build video in the docs

## Context

The project recreates the build shown in a Japanese video (Keyball39ish-LP, BLE Micro Pro, 25 mm
ceramic ball, printed case). The feasibility document needs an English summary of what was used there
and how this design differs (ZMK instead of BMP firmware, own PCBs, PMW3610, 35 keys, 19 mm ball).

## Acceptance criteria

- [ ] Summary section in `spec/00-feasibility.md` with the component list of the reference build
- [ ] Differences table reference build vs k0d3ball35

## Notes

None yet.
