konstantindenerz/k0d3ball35/issues/mech-pinky-column-springs.md

---
title: Recommend light springs for the outer column
type: task
priority: P3
status: open
area: mech
created: 2026-11-05
---

# Recommend light springs for the outer column

## Context

The pinky column is the most reported pain point on Keyball39 (joint load, oblique entry angle).

## Acceptance criteria

- [ ] spec/04-build-guide.md recommends 20 to 25 g springs or light switches for the outer column
- [ ] BOM lists one light switch option

## Notes

None yet.
