konstantindenerz/k0d3ball35/issues/mech-case-ball-dome.md

---
title: Plan the ball dome and tenting in the case
type: task
priority: P2
status: wontfix
area: mech
created: 2026-11-05
---

# Plan the ball dome and tenting in the case

## Context

r1: the ball top sat 23 mm above the PCB and the case would have needed a dome like the Keyball39ish housing. r2: the 19 mm ball in the case pocket tops out at +17.1 mm, 6 mm above the caps, so a low pocket rim replaces the dome (`mech-case-ball-pocket`); what remains here is the rim shape and tenting.

## Acceptance criteria

- [ ] Case concept drawing with the dome and the cradle flange clearance
- [ ] Depends on mech-case

## Notes

2026-11-06: superseded by mech-case-ball-pocket (rim) and mech-case-lid (tenting).
