konstantindenerz/k0d3ball35/issues/doc-keyball-owner-migration.md

---
title: Migration page for Keyball39 owners
type: task
priority: P3
status: open
area: doc
created: 2026-11-05
---

# Migration page for Keyball39 owners

## Context

Keyball and holykeebs users know keycodes such as `CPI_I100`, `SCRL_MO`, `HK_C_SCROLL`. A mapping table to our layers and behaviours lowers the switching cost.

## Acceptance criteria

- [ ] docs page with keycode mapping and the differences in feel (ball height, 19 mm, two right thumb keys, hot-swap only)
- [ ] Linked from README.md

## Notes

None yet.
