konstantindenerz/k0d3ball35/issues/hw-spare-pin-features.md

---
title: Use the spare controller pins (encoder, display) in a later PCB revision
type: feature
priority: P3
status: open
area: hw
created: 2026-11-05
---

# Use the spare controller pins (encoder, display) in a later PCB revision

## Context

D0, D1, D2, D3 and D9 are broken out as test pads on both halves (plus D10, D14, D15, D16 on the left, where the sensor pins are unused). A later revision could add footprints for an encoder or a small display without changing the matrix.

## Acceptance criteria

- [ ] Decision which feature is worth the height and the battery cost
- [ ] Footprints added in the generator behind an option, DRC clean

## Notes

None yet.
