konstantindenerz/k0d3ball35/issues/mech-keycaps.md

---
title: Printed dished Choc keycap set
type: feature
priority: P3
status: open
area: mech
created: 2026-11-05
---

# Printed dished Choc keycap set

## Context

The reference build uses self-designed dished low profile caps with smoothed thumb caps. A parametric cap in OpenSCAD lets people print the grey/white/orange set at home.

## Acceptance criteria

- [ ] Parametric 1u Choc cap with dish depth and thumb smoothing parameters
- [ ] STL set for 35 keys (18 left, 17 right) exported, print settings documented

## Notes

None yet.
