konstantindenerz/k0d3ball35/issues/mech-cradle-btu-variant.md

---
title: Ball transfer unit cradle variant
type: feature
priority: P3
status: open
area: mech
created: 2026-11-05
---

# Ball transfer unit cradle variant

## Context

Some users prefer BTUs over static ceramic bearings for lower stiction despite the grittier feel at low speed.

## Acceptance criteria

- [ ] Cradle parameter for 3 x 2.5 mm BTU seats
- [ ] STL exported and listed in hardware/trackball-cradle/README.md

## Notes

None yet.
