konstantindenerz/k0d3ball35/issues/fw-one-handed-scroll-toggle.md

---
title: Toggle variant of the scroll layer
type: feature
priority: P3
status: open
area: fw
created: 2026-11-05
---

# Toggle variant of the scroll layer

## Context

Scrolling currently needs a held key, which on a split means two hands for long scrolls.

## Acceptance criteria

- [ ] A toggle binding for the scroll layer exists in the keymap
- [ ] Visible in the layer table of spec/05-firmware.md

## Notes

None yet.
