konstantindenerz/k0d3ball35/issues/fw-scroll-axis-lock.md

---
title: Scroll snap and axis lock for the trackball
type: feature
priority: P2
status: open
area: fw
created: 2026-11-05
---

# Scroll snap and axis lock for the trackball

## Context

Keyball users rely on scroll snap (`SSNP_VRT`, `SSNP_HOR`, `SSNP_FRE`) and holykeebs on `HK_C_SCROLL`; scrolling with a free axis feels imprecise. See spec/10-lessons-from-keyball.md.

## Acceptance criteria

- [ ] Scroll layer locks to the dominant axis by default
- [ ] Horizontal and free modes selectable from the system layer
- [ ] Documented in spec/05-firmware.md

## Notes

None yet.
