konstantindenerz/k0d3ball35/issues/doc-zmk-yml-repo-url.md

---
title: Replace the placeholder repository URL in k0d3ball35.zmk.yml
type: task
priority: P2
status: open
area: doc
created: 2026-11-05
---

# Replace the placeholder repository URL in k0d3ball35.zmk.yml

## Context

`firmware/zmk-config/config/boards/shields/k0d3ball35/k0d3ball35.zmk.yml` still contains a placeholder GitHub URL.

## Acceptance criteria

- [ ] URL points to the published repository
- [ ] README and docs link the same URL

## Notes

Do this when the repository is created on GitHub.
