konstantindenerz/k0d3ball35/hardware/left-pcb/k0d3ball35-left-schematic.pdf

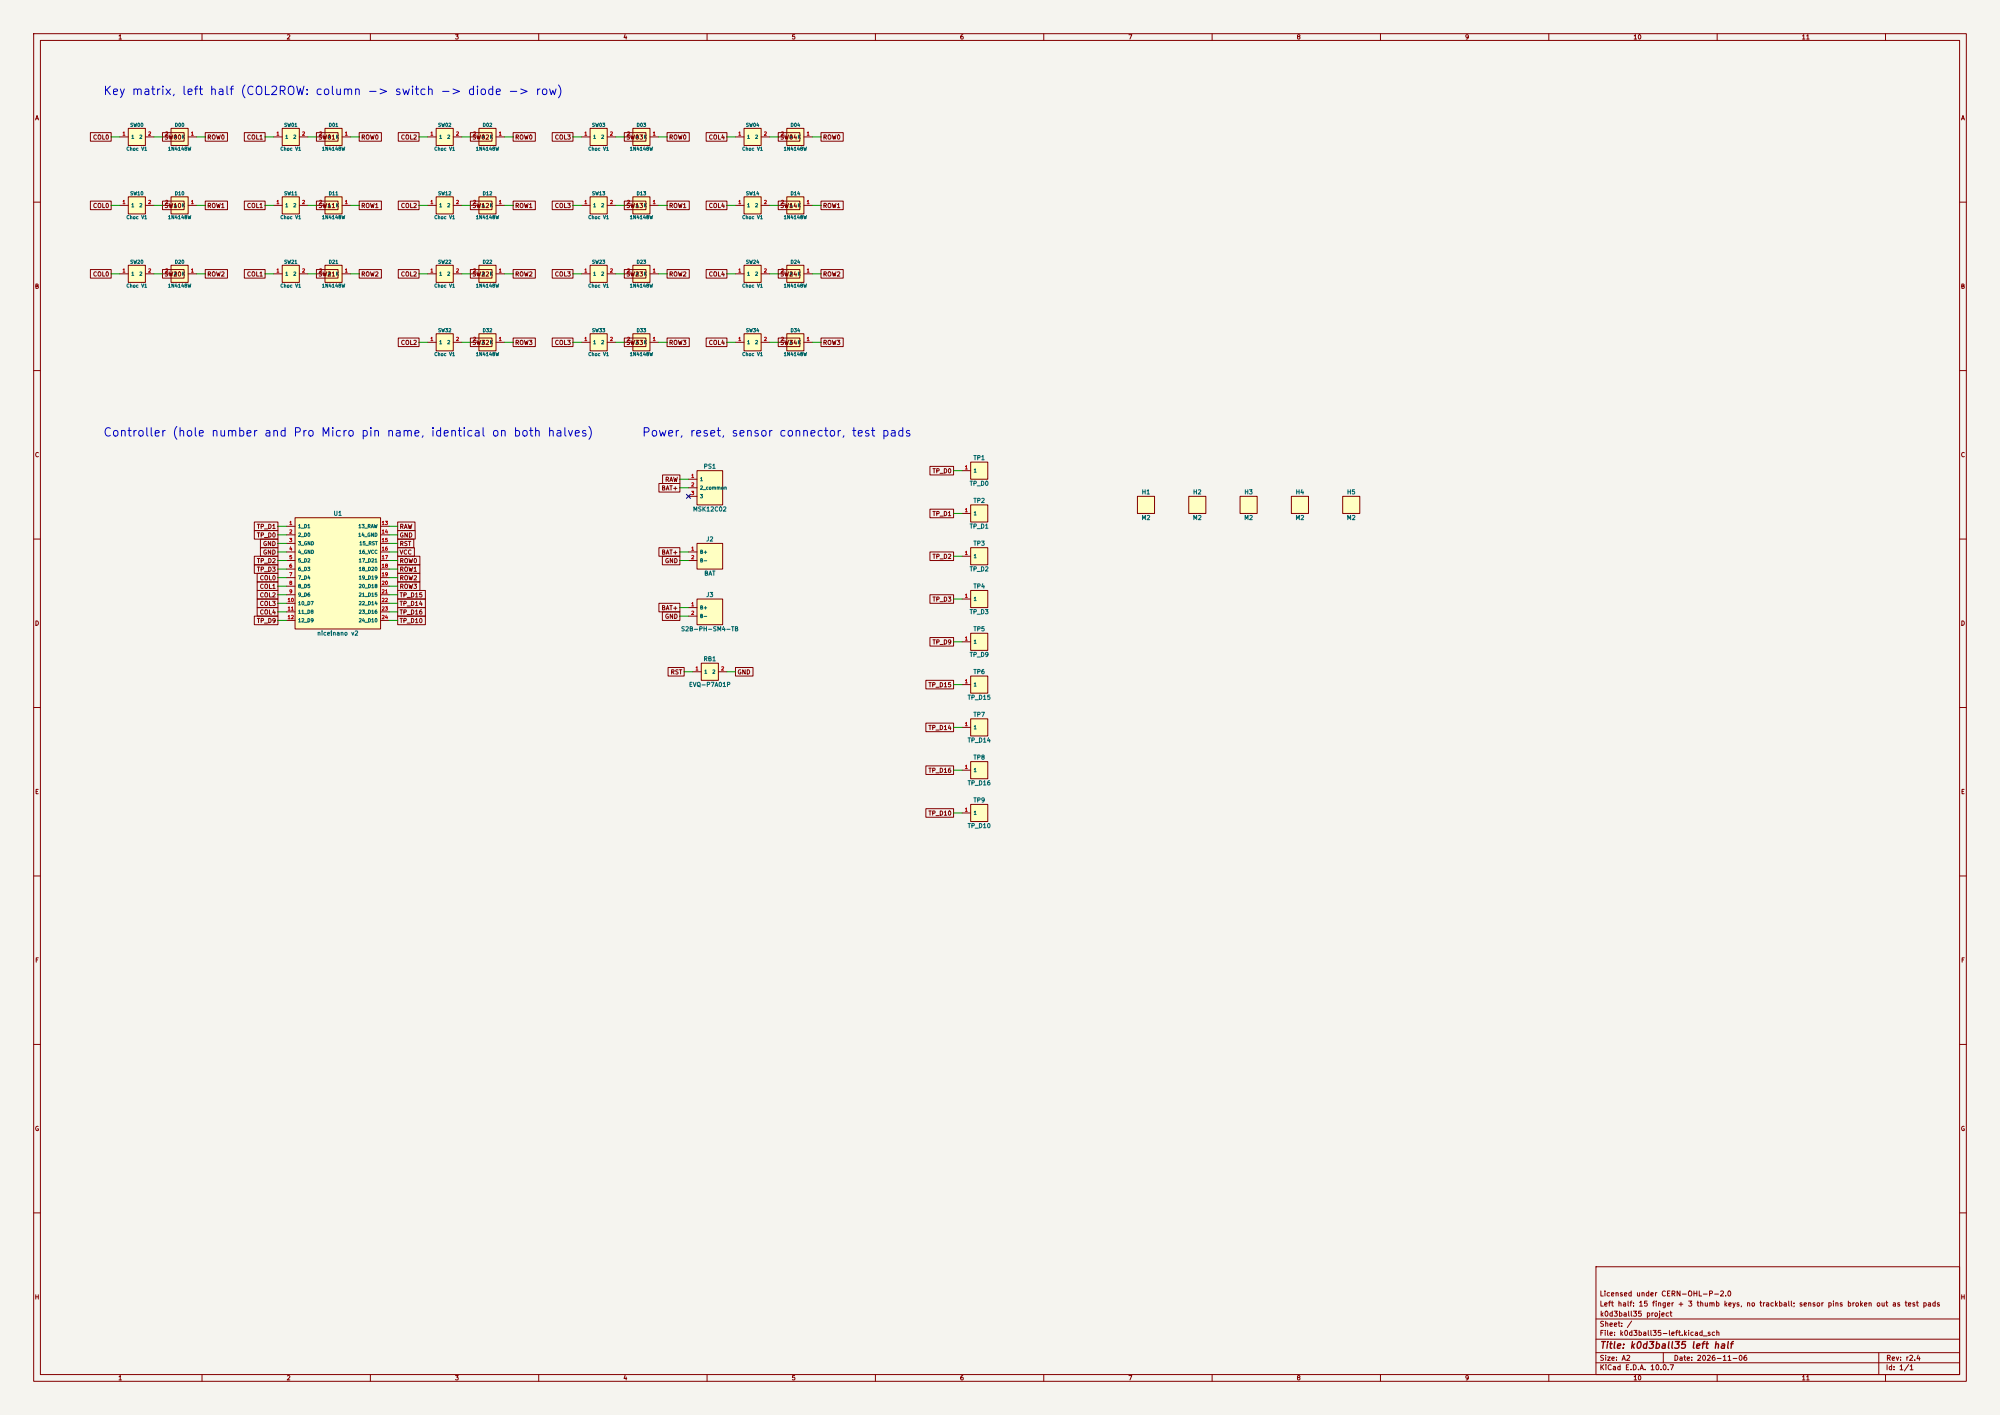
[picture p51: page 1]

Key matrix, left half (COL2ROW: column -> switch -> diode -> row)
SW00 Choc V1 1

Controller (hole number and Pro Micro pin name, identical on both halves)

Licensed under CERN-OHL-P-2.0
Left half: 15 finger + 3 thumb keys, no trackball; sensor pins broken out as test pads
k0d3ball35 project
Sheet: /
File: k0d3ball35-left.kicad_sch
Title: k0d3ball35 left half

Size: A2 | Rev: r2.4
KiCad E.D.A. 10.0.7 | Id: 1/1
