konstantindenerz/k0d3ball35/hardware/right-pcb/k0d3ball35-right-schematic.pdf

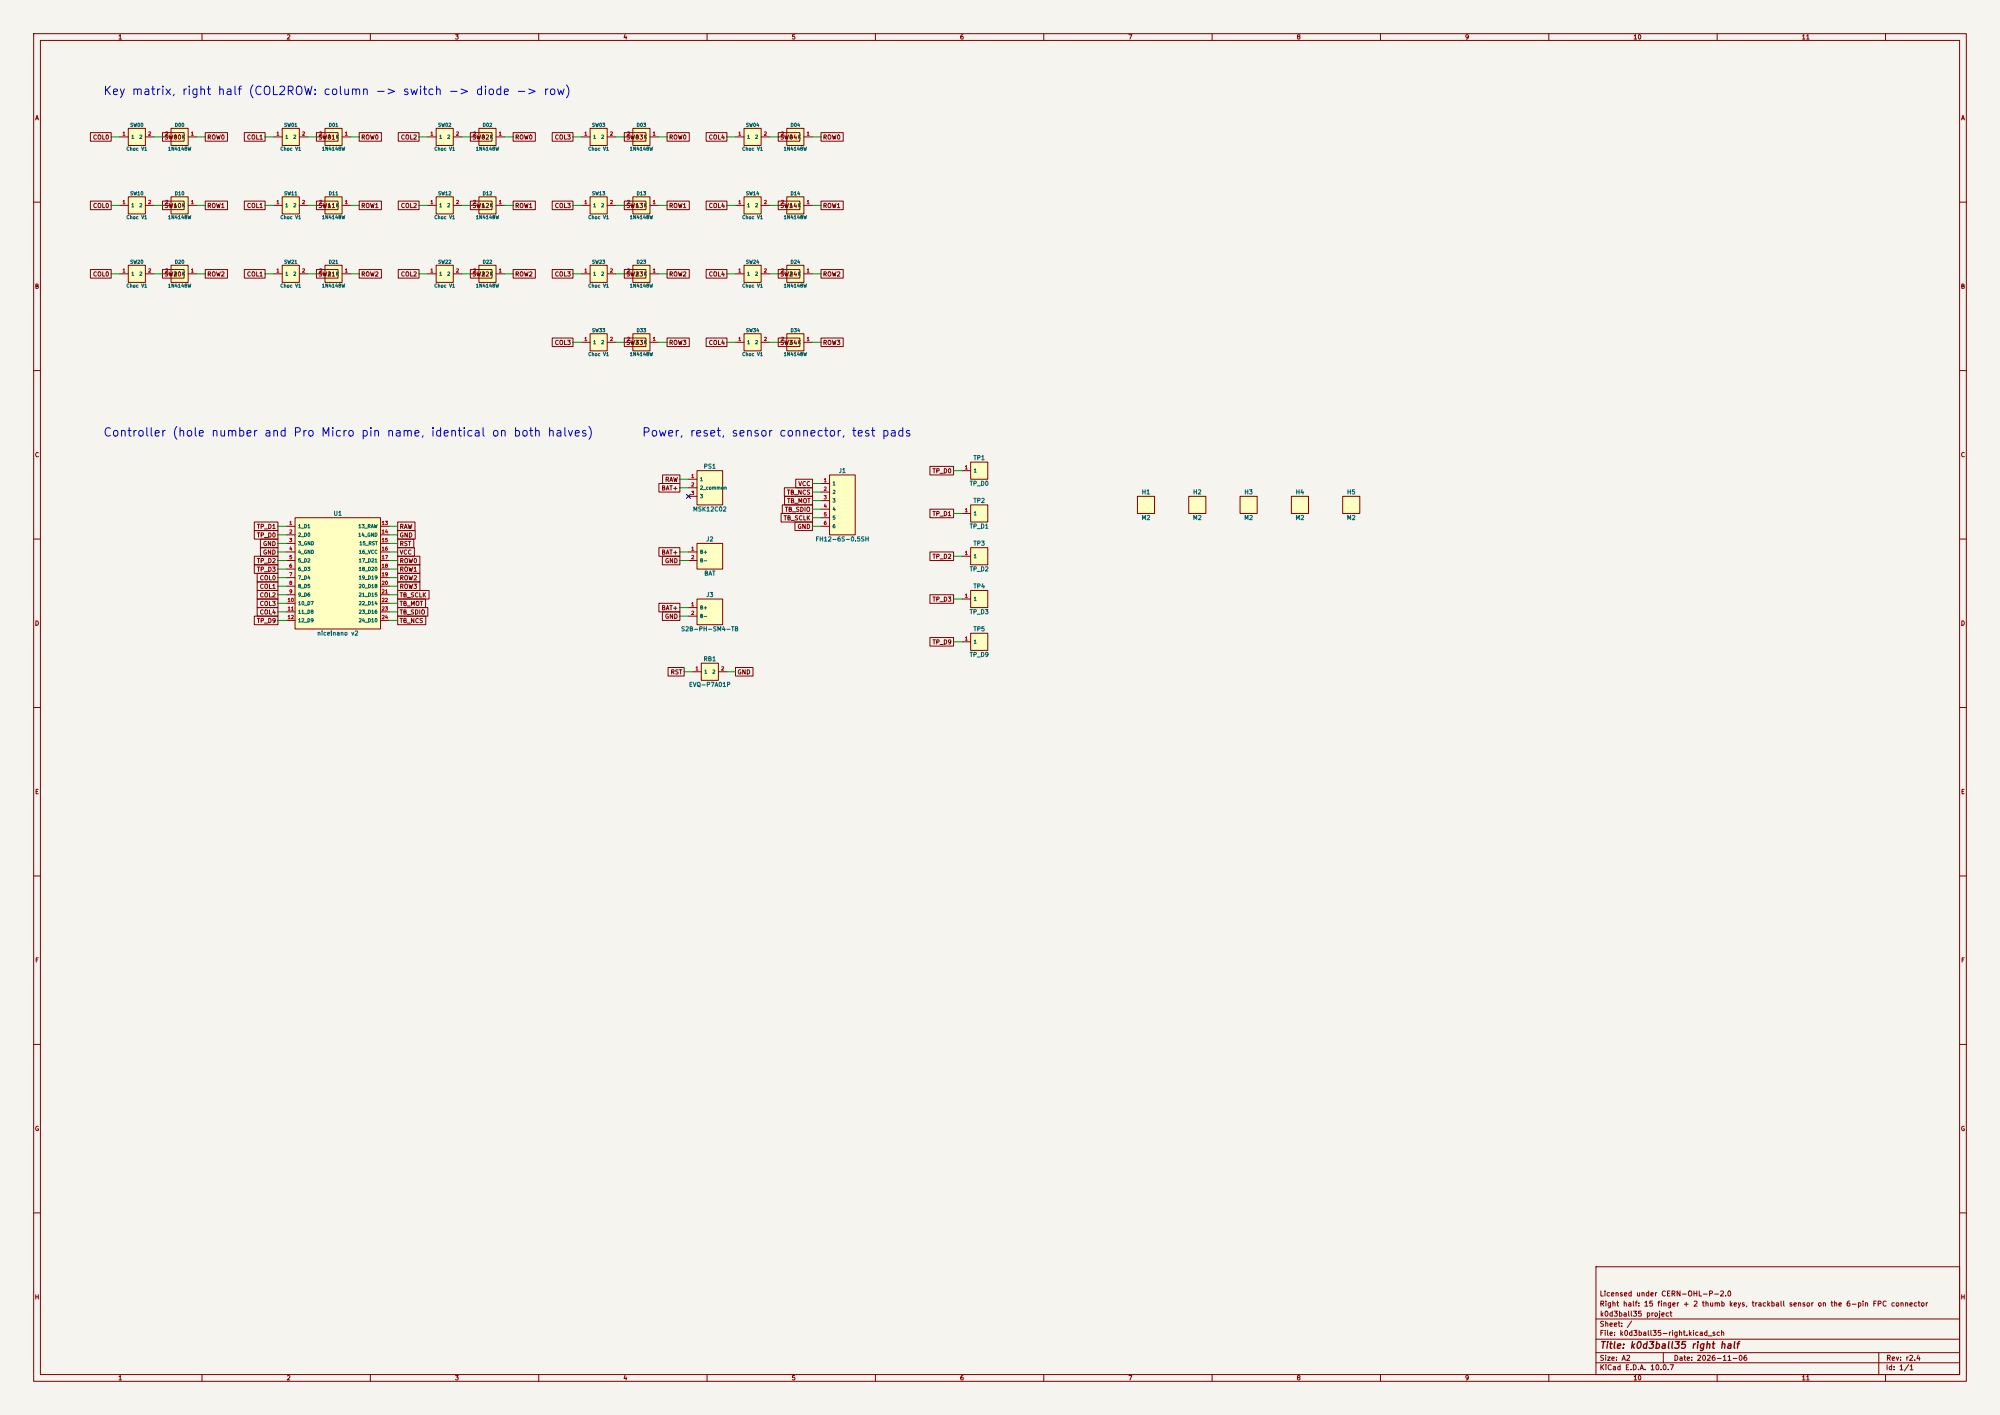
[picture p52: page 1]

Key matrix, right half (COL2ROW: column -> switch -> diode -> row)

Controller (hole number and Pro Micro pin name, identical on both halves)

Licensed under CERN-OHL-P-2.0
Right half: 15 finger + 2 thumb keys, trackball sensor on the 6-pin FPC connector
k0d3ball35 project
Sheet: /
File: k0d3ball35-right.kicad_sch
Title: k0d3ball35 right half

Size: A2 | Rev: r2.4
KiCad E.D.A. 10.0.7 | Id: 1/1
