konstantindenerz/k0d3ball35/hardware/left-pcb/k0d3ball35-left.kicad_pcb

## KiCad design hardware/left-pcb/k0d3ball35-left.kicad_pcb (2026-11-12)

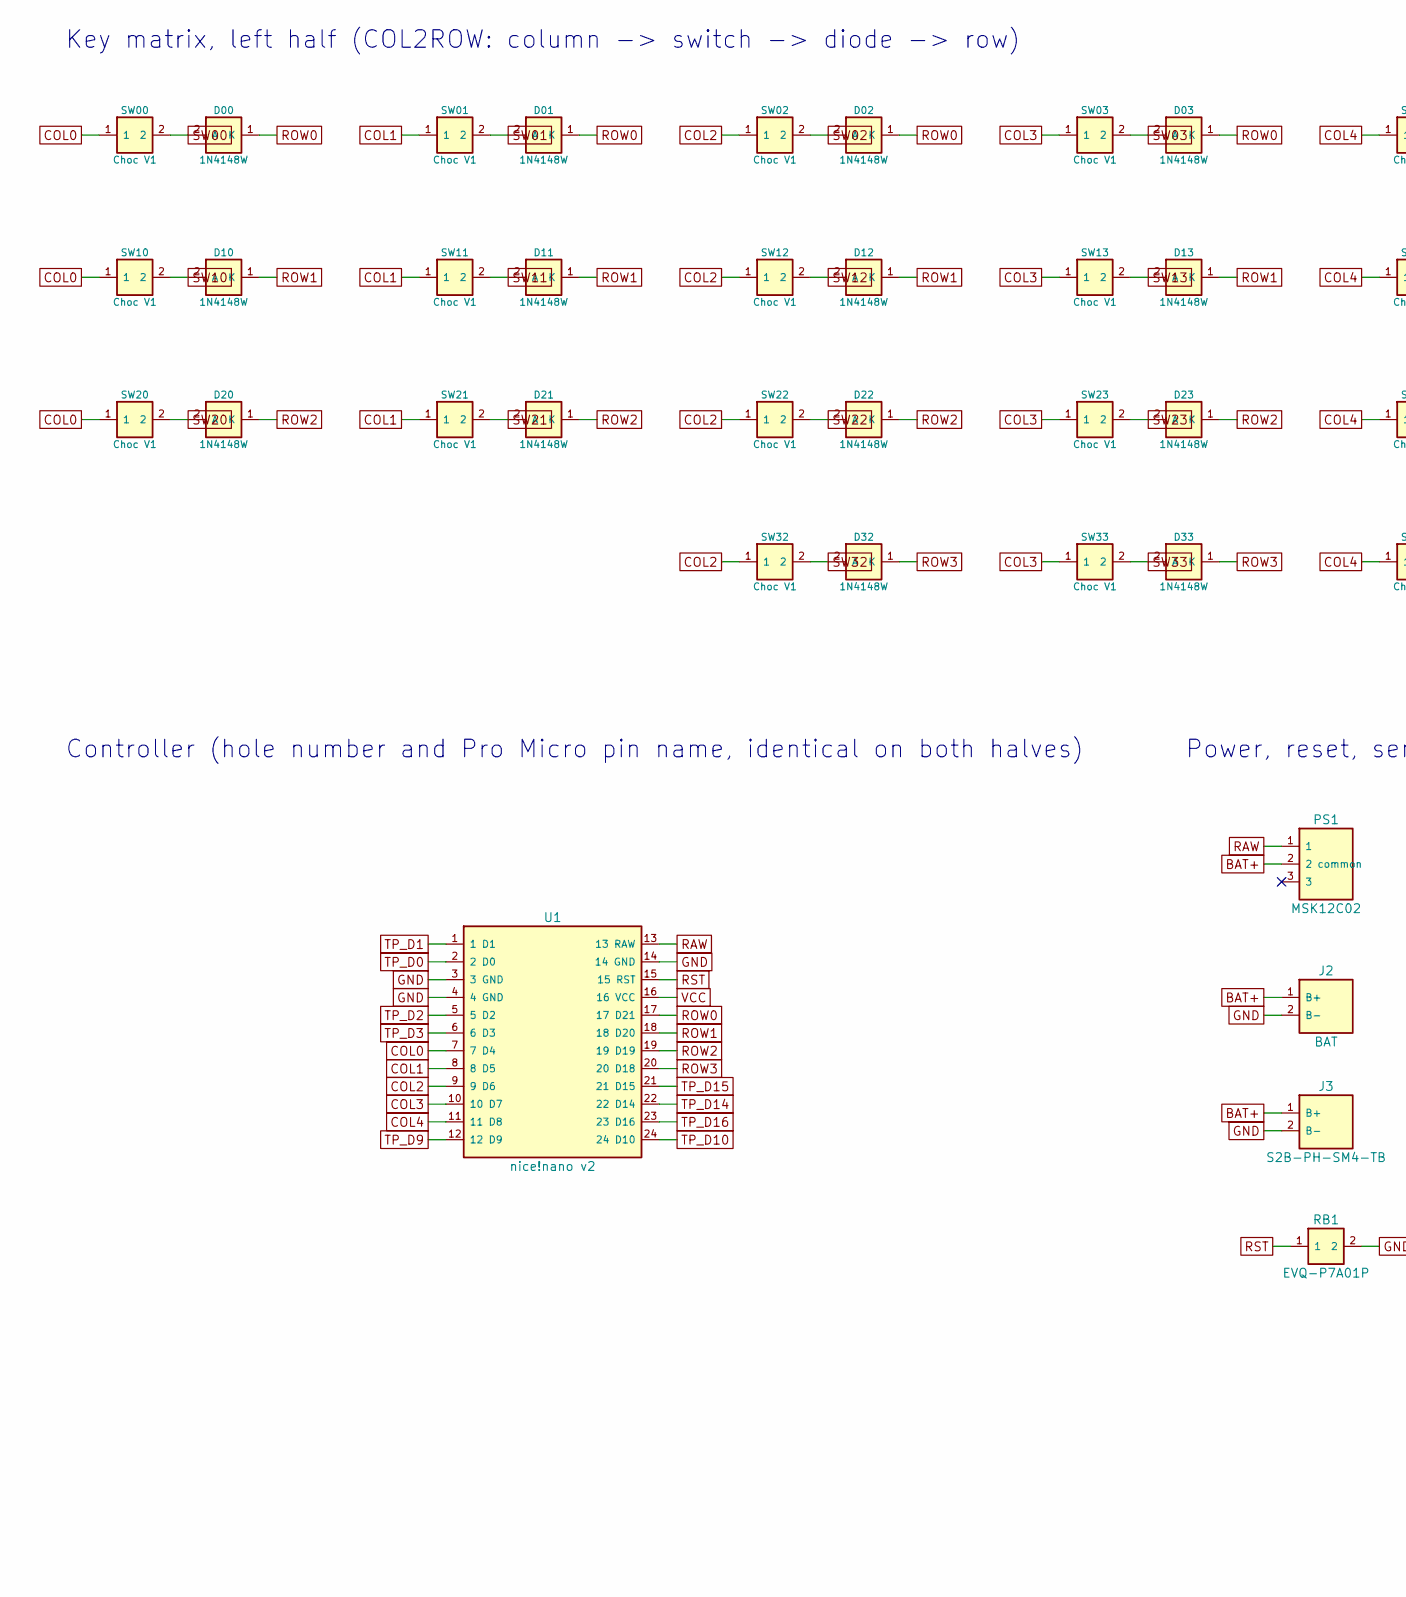
[picture p53: schematic k0d3ball35-left.kicad_sch, k0d3ball35 left half, part in row 1, column 1]

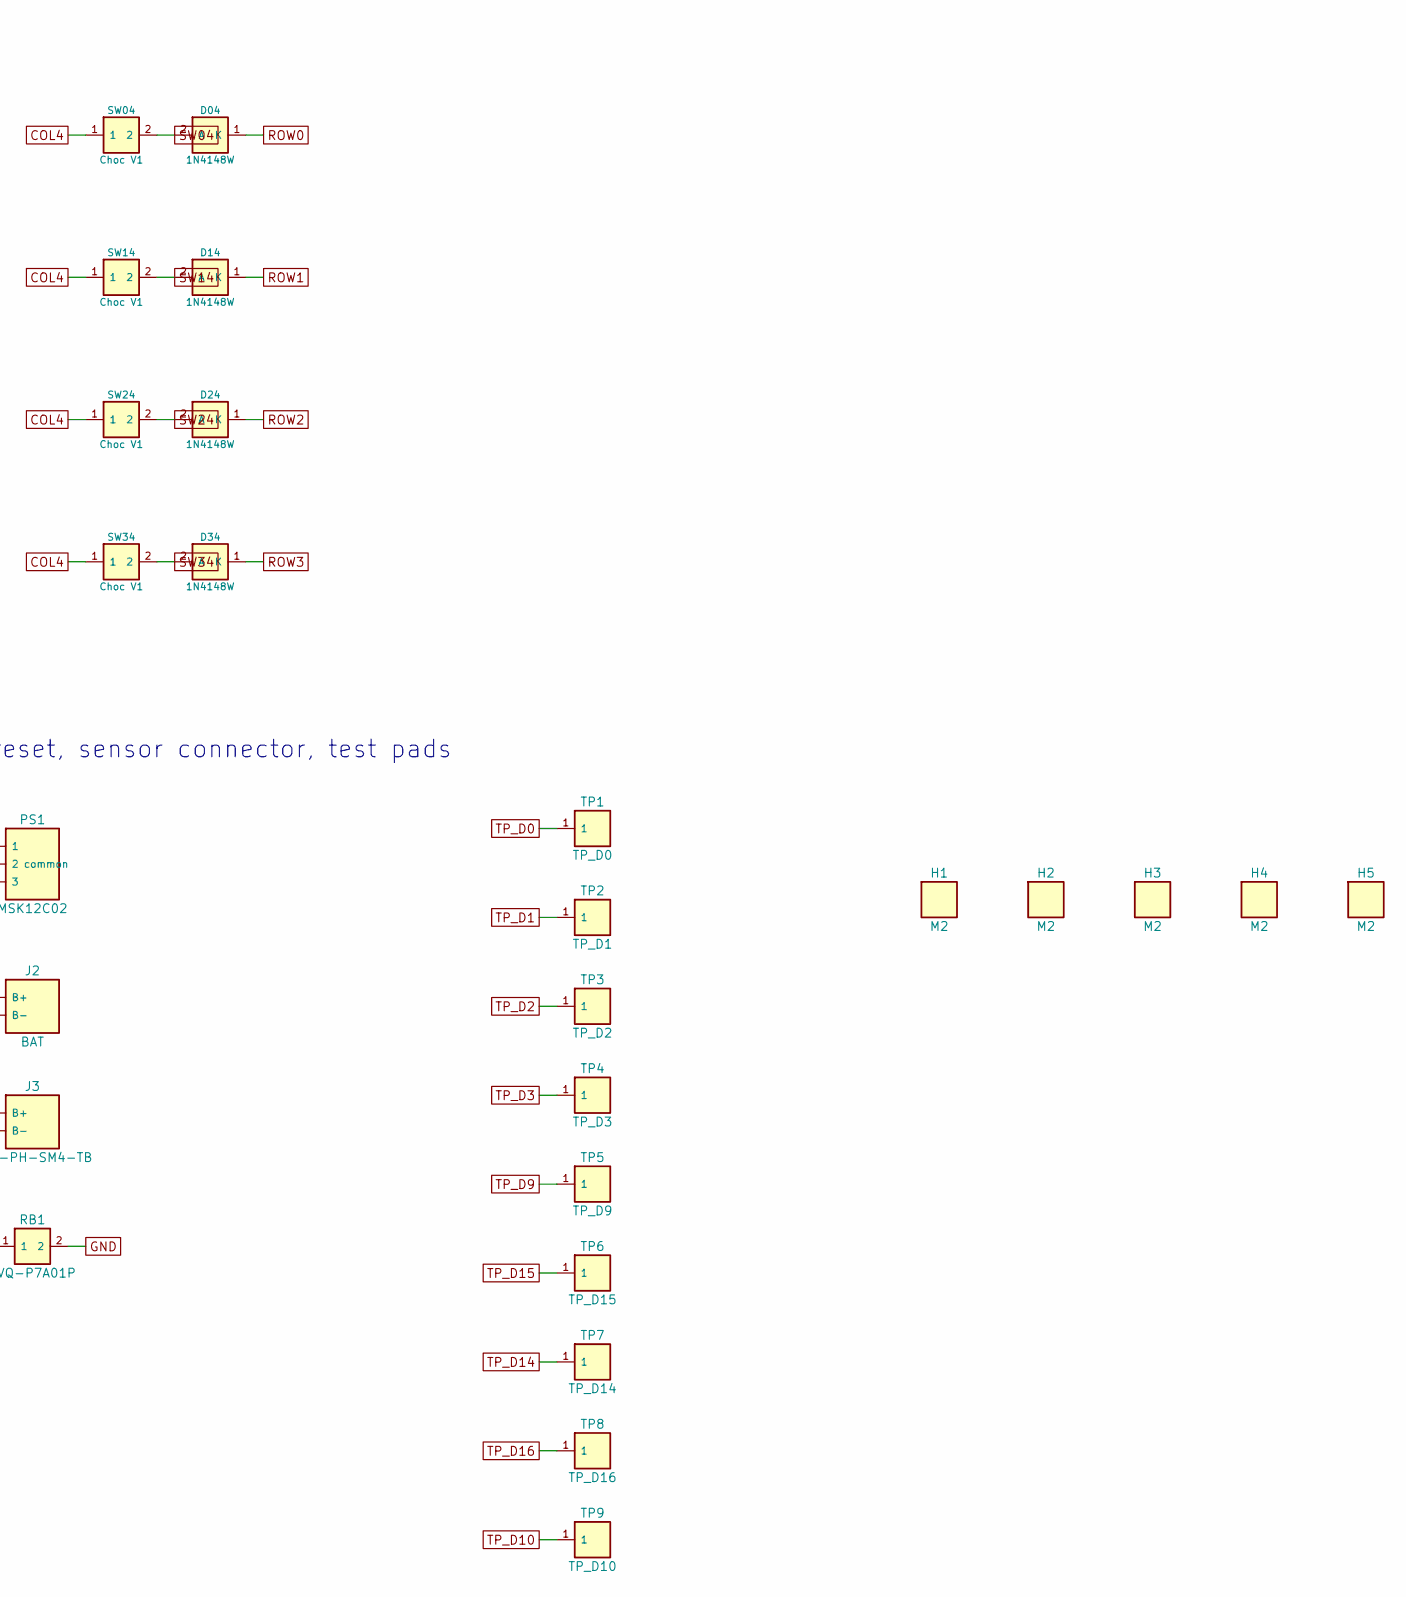
[picture p54: schematic k0d3ball35-left.kicad_sch, k0d3ball35 left half, part in row 1, column 2]

Parts:
D00, D01, D02, D03, D04, D10, D11, D12, D13, D14, D20, D21, D22, D23, D24, D32, D33, D34: 1N4148W; D_SOD-123_reversible
H1, H2, H3, H4, H5: M2; MountingHole_2.2mm
J2: BAT; BatteryPads_2x1.8mm_P2.54mm
J3: S2B-PH-SM4-TB; JST_PH_S2B-PH-SM4-TB_reversible
PS1: MSK12C02; SW_SPDT_MSK12C02_reversible
RB1: EVQ-P7A01P; SW_SPST_EVQP7A_reversible
SW00, SW01, SW02, SW03, SW04, SW10, SW11, SW12, SW13, SW14, SW20, SW21, SW22, SW23, SW24, SW32, SW33, SW34: Choc V1; SW_Choc_V1_HS_reversible
TP1: TP_D0; TestPad_1.5mm
TP2: TP_D1; TestPad_1.5mm
TP3: TP_D2; TestPad_1.5mm
TP4: TP_D3; TestPad_1.5mm
TP5: TP_D9; TestPad_1.5mm
TP6: TP_D15; TestPad_1.5mm
TP7: TP_D14; TestPad_1.5mm
TP8: TP_D16; TestPad_1.5mm
TP9: TP_D10; TestPad_1.5mm
U1: nice!nano v2; nice_nano_v2_THT

Connections:
BAT+: J2.1 (B+), J3.1 (B+), PS1.2 (2 common)
COL0: SW00.1, SW10.1, SW20.1, U1.7 (7 D4)
COL1: SW01.1, SW11.1, SW21.1, U1.8 (8 D5)
COL2: SW02.1, SW12.1, SW22.1, SW32.1, U1.9 (9 D6)
COL3: SW03.1, SW13.1, SW23.1, SW33.1, U1.10 (10 D7)
COL4: SW04.1, SW14.1, SW24.1, SW34.1, U1.11 (11 D8)
GND: J2.2 (B-), J3.2 (B-), RB1.2, U1.3 (3 GND), U1.4 (4 GND), U1.14 (14 GND)
RAW: PS1.1, U1.13 (13 RAW)
ROW0: D00.1 (K), D01.1 (K), D02.1 (K), D03.1 (K), D04.1 (K), U1.17 (17 D21)
ROW1: D10.1 (K), D11.1 (K), D12.1 (K), D13.1 (K), D14.1 (K), U1.18 (18 D20)
ROW2: D20.1 (K), D21.1 (K), D22.1 (K), D23.1 (K), D24.1 (K), U1.19 (19 D19)
ROW3: D32.1 (K), D33.1 (K), D34.1 (K), U1.20 (20 D18)
RST: RB1.1, U1.15 (15 RST)
SW00: D00.2 (A), SW00.2
SW01: D01.2 (A), SW01.2
SW02: D02.2 (A), SW02.2
SW03: D03.2 (A), SW03.2
SW04: D04.2 (A), SW04.2
SW10: D10.2 (A), SW10.2
SW11: D11.2 (A), SW11.2
SW12: D12.2 (A), SW12.2
SW13: D13.2 (A), SW13.2
SW14: D14.2 (A), SW14.2
SW20: D20.2 (A), SW20.2
SW21: D21.2 (A), SW21.2
SW22: D22.2 (A), SW22.2
SW23: D23.2 (A), SW23.2
SW24: D24.2 (A), SW24.2
SW32: D32.2 (A), SW32.2
SW33: D33.2 (A), SW33.2
SW34: D34.2 (A), SW34.2
TP_D0: TP1.1, U1.2 (2 D0)
TP_D1: TP2.1, U1.1 (1 D1)
TP_D2: TP3.1, U1.5 (5 D2)
TP_D3: TP4.1, U1.6 (6 D3)
TP_D9: TP5.1, U1.12 (12 D9)
TP_D10: TP9.1, U1.24 (24 D10)
TP_D14: TP7.1, U1.22 (22 D14)
TP_D15: TP6.1, U1.21 (21 D15)
TP_D16: TP8.1, U1.23 (23 D16)
VCC: U1.16 (16 VCC)

Notes on the sheet:
Key matrix, left half (COL2ROW: column -> switch -> diode -> row)
Controller (hole number and Pro Micro pin name, identical on both halves)
Power, reset, sensor connector, test pads

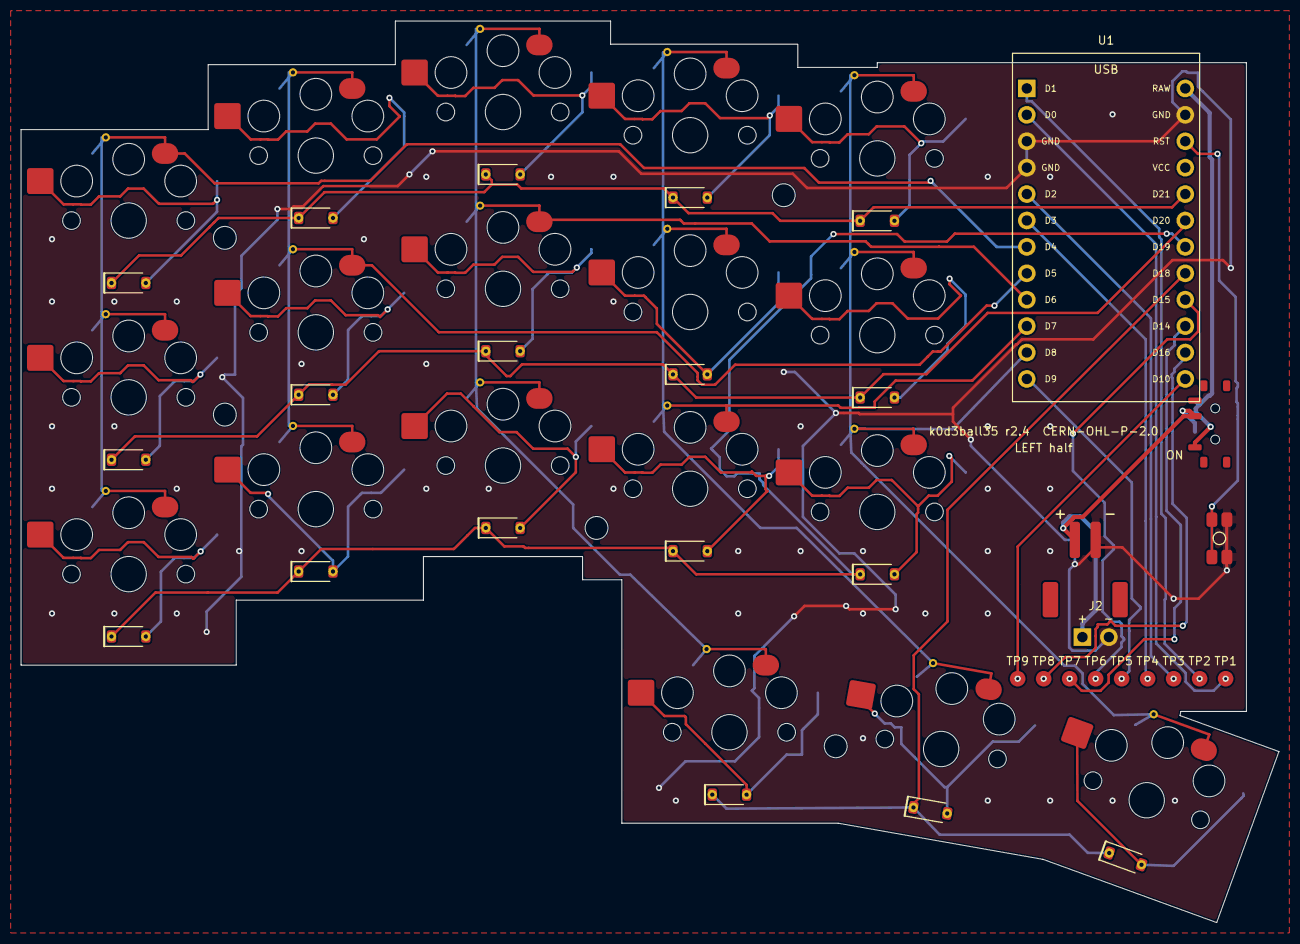
[picture p55: board k0d3ball35-left.kicad_pcb from above]

Board: 2 copper layers, 121.0 x 86.7 mm, 55 parts (0 on the bottom side), 40 nets.
