konstantindenerz/k0d3ball35/(commit log)

2026-11-05 Add project skeleton: licenses, docs, issue tracker, tests, CI, layout source
    [issues.py]
2026-11-05 trackball cradle in openscad, 25 and 34 mm variants
    [cradle.scad, cutout-25mm.dxf, params.scad]
2026-11-05 layout, schematic and pcb generators for the main board
2026-11-05 sensor board, build guide, layout/fab docs, tickets, more tests
    [k0d3ball36-sensor-B_Cu.gbl, k0d3ball36-sensor-B_Mask.gbs, k0d3ball36-sensor-B_Paste.gbp, k0d3ball36-sensor-B_Silkscreen.gbo, k0d3ball36-sensor-Edge_Cuts.gm1, k0d3ball36-sensor-F_Cu.gtl, k0d3ball36-sensor-F_Mask.gts, k0d3ball36-sensor-F_Paste.gtp]
2026-11-05 main pcb routed and drc clean, gerbers and renders, exploded view, lessons doc
    [k0d3ball36-bom.csv, k0d3ball36.kicad_pcb, k0d3ball36.kicad_sch, params.scad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]
2026-11-06 layout r2: two halves (15+3 / 15+2), stepped angular outline, 19 mm ball pocket beside the right PCB
2026-11-06 firmware: 35-key shield, identical pins on both halves, physical layout from exact coordinates, 19 mm cpi start
2026-11-06 docs, tickets and cradle for r2: two PCBs, 19 mm ball in a case pocket, stack numbers, bom per half
    [cradle.scad, k0d3ball36-bom.csv, k0d3ball36.kicad_pcb, k0d3ball36.kicad_sch, params.scad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]
2026-11-06 hardware r2: separate left and right PCBs without jumpers, routed, erc and drc clean, gerbers and renders
    [k0d3ball36-left-bom.csv, k0d3ball36-left.kicad_pcb, k0d3ball36-left.kicad_sch, k0d3ball36-right-bom.csv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]
2026-11-06 rename project to k0d3ball35: 35 keys since the right half has two thumb keys
    [cradle.scad, k0d3ball35-left-bom.csv, k0d3ball35-left.kicad_pcb, k0d3ball35-left.kicad_sch, k0d3ball35-right-bom.csv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]
2026-11-06 close the two-pcb r2 ticket, project description
2026-11-06 exploded view: proper polygon offsets for case and top frame, cradle group no longer displaced
2026-11-06 exploded view: closed controller box on the top frame for both halves
2026-11-06 cradle without retainer: open cup rim 1 mm below the equator, lid ticket for transport and stand
    [cradle-25mm-cutout.stl, cradle.scad, params.scad]
2026-11-06 right half: fpc connector under the middle column above the cradle housing, housing footprint and case screws in the layout, rerouted
    [k0d3ball35-right.kicad_pcb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]
2026-11-06 compact cradle: no screw ears, case screws through the sensor posts, pocket as rounded rectangle at floor level
    [cradle.scad, params.scad]
2026-11-06 exploded view: rubber feet placed inside the case floor outline, one under the pocket
2026-11-06 exploded view: pocket ring at its real 32 mm outer diameter, no overhang over the floor base
2026-11-06 layout: battery bay under the controller on both halves, back-side collision checks, points json and dxf export
    [k0d3ball35.yaml]
2026-11-06 pcbs: dashed battery bay with label on the back silkscreen under U1, both halves rerouted, drc clean, exports refreshed
    [k0d3ball35-left.kicad_pcb, k0d3ball35-right.kicad_pcb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]
2026-11-06 exploded view: 702025 cell in the bay under the PCB on both halves, controller on 2.5 mm sockets, dims with battery well
2026-11-06 docs and tickets: one battery concept for both halves (702025 under the controller, JST default, low-profile sockets), bom and build guide updated
2026-11-06 pcb review r1: power switch actuator through the inner edge (rotation 270), usb-c shell 1.5 mm past the top edge, test pad and battery pad labels unclipped, review tests, boards rerouted and exported
    [k0d3ball35-left.kicad_pcb, k0d3ball35-right.kicad_pcb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]
2026-11-06 gerber check: parse and render all three gerber sets in tests, sensor export without protel extensions
    [k0d3ball35-sensor-B_Cu.gbl, k0d3ball35-sensor-B_Mask.gbs, k0d3ball35-sensor-B_Paste.gbp, k0d3ball35-sensor-B_Silkscreen.gbo, k0d3ball35-sensor-Edge_Cuts.gm1, k0d3ball35-sensor-F_Cu.gtl, k0d3ball35-sensor-F_Mask.gts, k0d3ball35-sensor-F_Paste.gtp]
2026-11-06 ffc pin order: geometric derivation of the type a cable mapping as a test, bench procedure in the ticket
2026-11-06 sensor pcb vs cradle: holes, optical centre, lens and connector clearance checked against params.scad and the rendered stl
2026-11-06 tickets: branding with the owner's logo on pcb and case, index regenerated
2026-11-06 battery bay r2.1b: 21 x 41 mm for the PKCELL LP552035 (350 mAh), reset button and jst moved below the bay, diodes in the back-side check
2026-11-06 boards rerouted for the longer battery bay, drc clean, exports refreshed
    [k0d3ball35-left.kicad_pcb, k0d3ball35-right.kicad_pcb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]
2026-11-06 exploded view: LP552035 cell in the 41 mm bay
2026-11-06 docs and tickets: LP552035 from eckstein as the battery on both halves, bay and connector positions updated
2026-11-06 review test: battery bay label texts follow the layout cell
2026-11-06 ticket: left pcb is not mirrored
2026-11-06 sensor pcb: lens envelope 12.9 x 8.25 per the LM18-LSI datasheet, footprint refreshed, exports, test, docs
    [k0d3ball35-sensor.kicad_pcb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]
2026-11-06 fab checks: sensor zip flag, bom section 6 against the fab export, zip paths, gerber viewer ticket
2026-11-06 tickets: review checkboxes, gnd sliver test, ball dome superseded, build guide unblocked, cradle criteria, roadmap, testing table
2026-11-06 order: jlcpcb ticket decoupled from the cradle print, order checklist by shop
2026-11-06 left pcb: board generator mirrors the left half
2026-11-06 left board rerouted and exported after the mirror
    [k0d3ball35-left.kicad_pcb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]
2026-11-06 tests and docs for the mirrored left board
2026-11-06 ticket: left pcb mirror done, follow-up for the bay sockets
2026-11-06 left bay: accept the socket overhang, cell limit 6 mm on the left
2026-11-06 case: layout data generator, data.scad, make case-data
    [data.scad]
2026-11-06 case: params, 2d modules, tray with key floor, battery well, standoffs and walls; stack, makefile, previews, render tests
    [case.scad, common.scad, lid.scad, params.scad, tray.scad]
2026-11-06 docs: docs/11-case.md, image prompts, case tickets updated
2026-11-06 docs: case interface in the spec, case links in readme, layout, module and roadmap, feet and filament in the bom
2026-11-06 exploded view: printed tray, controller cap and lid from hardware/case instead of the placeholders
2026-11-06 case: lid holds by an inner lip, magnets only in the floor and the lid roof, pads removed
    [case.scad, common.scad, data.scad, floor-left.dxf, lid.scad, params.scad, tray.scad]
2026-11-06 docs: case readme and docs/11 for the lip lid, magnet count in bom and order list, prompts, lid ticket
2026-11-06 exploded view: lid on top or as foot, case stls refreshed
2026-11-06 trackball: J1 on the key side, square notch corner, module drops into the pocket
    The documented assembly could not work. The 45 degree notch facet overhung the cradle
    housing by 5.9 mm and the sensor board by 3.0 mm, so the module could never be lowered
    into its pocket with the PCB fitted, and J1's lock sat under the board in a 3 mm gap with
    1 mm of horizontal run for an 8 mm cable drop.
    J1 moves to the key side at (-2.6, 45.5), where its mouth ends 0.5 mm short of the notch
    edge: the FFC climbs the 3 mm gap between the cup and the notch and folds over the board
    edge into it, and the lock stays reachable with everything assembled. The notch corner
    towards the keys is square and the housing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
    [common.scad, cradle-19mm-pocket.stl, cradle-25mm-pocket.stl, cradle.scad, data.scad, floor-19mm-pocket.dxf, floor-25mm-pocket.dxf, k0d3ball35-right-bom.csv]
2026-11-06 docs: one assembly order, J1 on the key side, type B cable
    The order now matches the hardware: trackball module into the pocket, cell onto the PCB,
    PCB into the tray, controller, keycaps, FFC into J1 last. The build guide gets its own
    case chapter for it (12), chapter 7 says why the cell has to travel with the board, and
    tests/test_docs.py walks the same phases through both documents so they cannot drift
    apart again. Pin order, cable type and the pocket numbers follow the hardware change.
    New tickets for the two defects and for what was considered and dropped: the plug-on
    sensor board with a floor hatch, and a cover for the visible bit of cable.
2026-11-06 exploded view: rebuild with the squared notch and the 29 mm housing
2026-11-06 case: engrave the owner wordmark into the box cap and the case floor
    The kode wordmark is drawn on a strict cell grid. scripts/gen_logo.py recovers
    that grid from docs/images/logo.png, completes the frame foot the crop cut off
    and writes the ink as cell rectangles to hardware/case/logo_data.scad; logo.scad
    scales them to millimetres and subtracts them from the cap plate and the tray
    underside. Both faces print on the bed, so the relief is engraved rather than
    raised and no groove bridges further than one cell.
    [box-cap-left.stl, box-cap-right.stl, case.scad, logo.scad, logo_data.scad, params.scad, tray.scad]
2026-11-06 docs: describe the engraved wordmark and close the case half of hw-branding-logo
    docs/11-case.md gets a wordmark section (sizes, clearances, printing, the
    invert and two-colour options), the build guide mentions it where the cap goes
    on and where the feet go, PROMPTS.md gets img-case-logo-cap, and NOTICE records
    that the artwork is the owner's and not under the repository licences.
2026-11-06 exploded view: rebuild with the engraved wordmark and guard against a stale page
    docs/exploded-view/index.html embeds the case STLs, so it kept showing the
    plain caps after `make case`. Rebuilt, added a `make exploded` target and a
    test that compares the engraved area in the embedded caps with logo_cap_area
    from stack.json, so the page cannot silently fall behind the model again.
2026-11-06 logo: write docs/images/logo.svg from the same rectangles as the case engraving
    The artwork is already exact vector geometry once the cell grid is recovered,
    so there is nothing to wait for: gen_logo.py now also emits a 1 kB SVG whose
    user units are the cell grid itself. A test rasterises it and compares it cell
    by cell with the grid, so a broken path cannot reach the silkscreen or the web.
    This unblocks the PCB half of hw-branding-logo.
    [gen_logo.py]
2026-11-06 pcb: owner wordmark on the back silkscreen under the thumb bridge
    The mark is 18 x 35 cells at a 1:2.96 aspect, so the free band height sets
    the stroke width. Measured against pads, courtyards and the existing silk,
    the back under the thumb bridge is the only band that takes it at 0.26 mm
    strokes; the front would squeeze it to 0.24 mm and 0.07 mm from the title
    text. Drawn board-level as 34 filled gr_poly from k0d3.logo rather than as a
    footprint, which would be a part without a schematic symbol. Both halves
    routed DRC clean on the first attempt, gerber mask overlap still zero.
    The grid recovery moved from scripts/gen_logo.py to scripts/k0d3/logo.py so
    the board generator can use it; gen_lo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
    [k0d3ball35-left.kicad_pcb, k0d3ball35-right.kicad_pcb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]
2026-11-06 exploded view: let the camera go under the half
    The orbit was clamped just short of horizontal, so the case underside - the
    magnet pockets, the feet and now the engraved wordmark - could not be seen at
    all. The clamp now allows the full arc, a light from below keeps the underside
    off silhouette, and a From below button jumps straight there.
2026-11-06 case data: hinge line and foot magnets under the outer lid plate
    The lid is about to split into two hinged plates along x = -13. Only the
    outer plate lies against the tray as a foot, so all four floor magnets move
    under it: the corner search now runs on the part of the outline right of the
    hinge line, 2 mm further in so the 6 mm hinge strip under the roof never
    covers a roof pocket, and keeps 2 mm to J1 and the cable corridor. The line
    is emitted as hinge_x so the SCAD hinge and the magnet search cannot drift.
    [data.scad]
2026-11-06 case: hinged two-plate lid that folds into a tenting foot
    The one-piece lid was just a lid when put under the half. It is now two
    plates on a 2 mm pin hinge along x = -13: closed it is the transport cover
    (inner lip as before, the ball looks through a 16 mm window smaller than
    itself), folded by 30 degrees it goes under the half with the outer plate
    roof-up on the floor magnets and the inner plate as the leg, tilting the
    half by about 15 degrees with the inner edge up.
    Nine knuckles flush with the roof top, the outer plate owns both ends, the
    pin goes in from the back and stops in a blind knuckle. Below the axis each
    cut face leans outward by tent_deg, so at the fold the two faces meet flat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
    [case.scad, common.scad, lid.scad, params.scad]
2026-11-06 exploded view: folded lid in the foot position
    The page embeds the closed pair and the folded pair; the foot radio shows
    the folded one under the tray with the hinge angle and the resulting tilt
    in the label. The half itself stays level in the page.
2026-11-06 docs: hinged lid in the case notes, ticket, bom, order list and prompts
    Heights, hinge, stop, window and foot numbers in docs/11 and the case
    readme, the lid ticket rewritten around the hinge with the redesign in its
    log, two 2 mm steel pins in the bom and the order list, image prompts for
    the folded foot and the hinge close-up.
2026-11-06 case: foot pose moved under the controller half, inner plate as kickstand
    With the hinge in the middle of the board the inner half hung 62 mm beyond
    the hinge line and a thumb press pivoted the board against the two outer
    magnet pairs. The folded lid now shifts inward until the hinge axis sits
    3 mm outside the inner wall: the outer plate lies under the controller
    half, the inner plate kicks down beyond the inner edge, the outer tray
    edge rests on the desk. No cantilever, the magnets only align the plate.
    tent_deg is the input now; the fold follows from where the kickstand's lip
    edge meets the desk (about 34 degrees) and the stop faces are cut for half
    of that. The magnets moved under the ke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
    [case.scad, common.scad, data.scad, lid.scad, params.scad]
2026-11-07 case: no wordmark on the floor, ticket for the proud cradle screw heads
    The engraving on the underside did not look right; it stays in the model
    behind logo_on_floor = false. The cap keeps its wordmark. The two M2 heads
    under the pocket block stand 1 mm proud of the 0.5 mm counterbore and show
    as loose discs in the exploded view, tracked in mech-case-screw-heads-flush.
    [params.scad]
2026-11-07 case: countersink the cradle screws so the heads sit inside the floor
    The two M2 x 10 case screws under the ball pocket had a 0.5 mm counterbore in
    a 2.5 mm floor, so a pan head stood 1 mm proud of the flat underside. The floor
    cannot get thicker (the pocket floor sets the ball height), so the screws become
    countersunk flat heads: a 4.8 mm, 1.3 mm deep 90 degree cone, head 0.2 mm inside
    the underside, 1.2 mm of floor left at the bore. Docs, BOM and order list ask for
    countersunk screws; the exploded view draws the heads in the cone.
    [case.scad, params.scad, tray.scad]
2026-11-07 route: keep stitching vias away from existing holes, review the routing
    The scripted part of step 6 of hw-main-pcb-review-r1: every signal net measured
    against the minimum spanning tree over its own pads, plus via counts, dangling
    ends, hole-to-hole distances and parallel SPI runs. Two drill defects on the
    right board, both from stitch_ground placing a grid via on top of something:
    * a GND via 0.2256 mm from the GND via at (9.0, 6.0), the known DRC warning,
    * a 0.3 mm GND via 0.152 mm from the centre of U1 pad 14's 1.0 mm hole, i.e.
    inside the controller socket hole. KiCad never reported it (same net).
    stitch_ground now collects router vias and every pad drill first and skips a
    grid poin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
    [k0d3ball35-left.kicad_pcb, k0d3ball35-right.kicad_pcb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]
2026-11-07 print check: 1:1 measuring sheet per half for a ruler, no parts needed
    The 1:1 paper check of the review ticket needs real sockets to be worth
    anything. Until they arrive a ruler can still settle whether the print is 1:1
    and whether the board carries the numbers the layout promises.
    make print-check writes build/print/<half>-check-1to1.pdf: A4, the board at
    1:1 with keycap and switch bodies in grey, and coloured dimensions for the
    outline, the key grid, the controller hole pattern (read from the footprint,
    not typed), the battery bay, the mounting holes and, on the right, the notch
    octagon and the ball circle, plus 100 mm and 50 mm calibration bars and a
    legend with a blank to write the mea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
2026-11-07 print check: stamp the commit and the date on every measuring sheet
    A sheet on the desk has to say which state of the repository it came from.
    The header carries the short commit, `-dirty` when the tree has uncommitted
    changes, and the date; a test keeps the stamp tied to HEAD.
    [gen_print_check.py]
2026-11-07 print check: thumb travel on the sheet, and sheets from a draft layout
    The one judgement the paper sheet is for is whether the thumb reaches the ball
    without the wrist moving, so the sheet now draws the two travels - ball centre
    to each thumb key centre - and lists them with the other dimensions.
    --layout points the generator at another layout yaml and --label marks the
    result as a draft, on the page and in the filename, so a candidate can be
    printed and held in the hand before it goes anywhere near the repository.
2026-11-07 layout: ball inboard, right half keeps the two inner thumb keys (r2.3)
    The ball sat at (+5, 64), outboard of the thumb cluster and under the ring
    column, and the right half dropped the inner thumb key to make room. The thumb
    had to reach outward for it.
    Every reference design does the opposite: Keyball 39/44/61, torabo-tsuki LP and
    the Charybdis all drop the OUTERMOST thumb key on the ball half and keep the
    inner ones. A 19 mm ball also has to sit further in than their 34 mm one,
    because the thumb touches the ball's near surface and not its centre - 7.5 mm
    of radius difference.
    So: right thumbs are the middle (10 deg) and inner (20 deg) keys, and the ball
    moves to (-13, 66) - 5 mm outboard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
2026-11-07 pcb: route the right board for the inboard ball, seven hand routes
    The thumb pair is the 10 and 20 degree key now, so the right board needs the
    hand routes the left one needs: freerouting cannot reach pads of footprints
    rotated off the 90 degree grid, and the corridor from the controller past the
    battery parts to the thumb cluster is narrow.
    The routes were found by a grid search over the free copper of each layer -
    every drill on the board, every pad of another net (netless hold-down pads
    included), the board edge and the previously placed hand routes as obstacles -
    then checked again by a separate script before the router ever ran.
    Result on the first attempt: DRC clean with schematic pa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
    [k0d3ball35-right.kicad_pcb, k0d3ball35-right.kicad_sch]
2026-11-07 firmware: right thumb keys are the inner pair, matrix RC(3,9) RC(3,8)
    The right half's thumb keys moved from matrix columns 2 and 3 to 3 and 4, so
    with the col-offset of 5 the transform cells become RC(3,9) RC(3,8). Physical
    layout and keymap-editor JSON regenerated from the layout; check_pins now
    rejects RC(3,7) instead of RC(3,9). Keymap positions 33 and 34 keep their
    bindings, their physical meaning swaps: 33 is the inner thumb key now.
    [k0d3ball35-right-bom.csv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]
2026-11-07 pcb: square the hand routes onto 45 degrees, move what the ball displaced
    The hand routes came out of a grid search that minimised length, which drew a
    39 mm track across the board at an arbitrary angle. The search now squares its
    result onto long axis-aligned runs joined by 45 degree corners, the way a
    person draws them: two to eight segments per route instead of a staircase or a
    diagonal.
    Three things the moved ball displaced and that had to find a new home: the test
    pad row (the old spot is under the inner thumb key's socket - now down the inner
    edge, clear of the controller box boss and with its labels off the battery
    pads), the fifth mounting hole (now in the thumb bridge) and the back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
    [data.scad, floor-right.dxf, k0d3ball35-left.kicad_pcb, k0d3ball35-right.kicad_pcb, params.scad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]
2026-11-07 pcb: widen the sensor bus, re-lay both thumb clusters, test what the generator draws
    Three routing improvements, two of them from reading the sources of boards
    that already work:
    The sensor bus goes from 0.15 to 0.25 mm. A track centred on an FH12 contact
    still clears its neighbour by 0.225 mm, so the thin tracks of r2.2 bought
    nothing; Keyball runs the same PMW sensor bus 130 mm long at 0.25 mm with no
    guard trace.
    Both thumb clusters are re-laid by the same grid search, squared onto long
    runs with 45 degree corners. The left half had a 20 mm track at 160 degrees
    across the board and a net with five vias; it now has neither. Right 96 % of
    segments on the 45 degree grid, left 94 %.
    Tried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
    [common.scad, data.scad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]
2026-11-07 docs: the ball sits where the outer thumb key was
    Design spec, layout, firmware, fabrication, feasibility, lessons and README
    follow the r2.3 arrangement: right half keeps the two inner thumb keys, ball
    at (-13, 66), both halves 121.0 x 86.7 mm, matrix RC(3,9) RC(3,8), sensor bus
    0.25 mm, per-half mounting hole, test pad row and wordmark.
    New ticket hw-ball-inboard-r2-3 carries the reasoning, the measured numbers
    and what is left for the test print. The board review ticket gets a section on
    what the rework changed for its remaining hand checks.
2026-11-07 case: break the two first-layer edges and the rim
    Both parts print with a large flat face on the bed - the tray floor down, the
    lid roof down - and that first layer squashes out by a tenth or two. A 0.5 mm
    45 degree taper on those two outer edges keeps the half sitting flat and takes
    the sharp edge off the line that rides on the desk. The rim gets 0.3 mm: the
    hand touches it with the lid off and the lid skirt meets it with the lid on,
    where it now reads as a shadow line instead of a seam. It stops short of the
    controller box, whose walls stand on the rim and would be undercut. Vertical
    corners stay sharp - the nozzle rounds them to 0.2 mm anyway and the angular
    outline is the point.
    The tap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
    [case.scad, common.scad, lid-folded-left.stl, lid-folded-right.stl, lid-inner-left.stl, lid-inner-right.stl, lid-left.stl, lid-outer-left.stl]
2026-11-07 infra: declare shapely, keep the layout outputs, install from pyproject
    scripts/k0d3/geometry.py imports shapely at module level, but shapely was not
    declared anywhere and both workflows installed a hand-written list of four
    packages. In CI nine of nineteen test modules therefore failed collection --
    geometry, netlist, footprints, pcb_review, generated_tracks, case, bom,
    print_check and electrical -- so pytest exited non-zero and roughly half the
    assertions had only ever run locally. ezdxf and trimesh were undeclared too,
    but importorskip'd, so the mesh and DXF checks skipped silently and the job
    went green having checked nothing.
    Both workflows now install `-e .[test]`, so the dependency l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
    [outline-left.dxf, outline-right.dxf]
2026-11-07 issues: three tickets from the r2.3 design review
    hw-sensor-vcsel-pins (P0, blocks the sensor board). The PMW3610's four
    laser-related pins are wired so that VCSEL_N (pins 15 and 16) is a two-pad net
    with one track segment and no GND, resistor or cap, and PASS_T is shorted to
    +VCSEL. ERC cannot see it, because a two-pad net counts as connected, and no
    doc, BOM row or test states the intended topology -- docs/08 lists a component
    for every other pin of the part and nothing for this net. Nothing on the sensor
    board has an electrical test at all, even though test_ffc_pin_order and three
    tickets rest on the prose claim that R2 and R3 make a reversed cable harmless.
    hw-msk12c02-pad-pitch (P1, bl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
2026-11-07 docs: propagate the r2.3 ball move, and strike the type A cable answer
    The ball moved inboard to (-13, +66) in r2.3 and J1 followed it to
    (-20.6, +47.4), but prose kept the old (+5, +64) and (-2.6, +45.5) in docs 01,
    02, 08, the cradle README and four tickets. The cradle case screws moved with
    it, to (-13, 56) and (-13, 76). The right half's test pad row moved to the
    inner edge and runs along y, and H5 is no longer shared between the halves.
    Three of these were wrong rather than stale:
    - docs/02 claimed matrix cell (3,4) exists only on the left. It exists on both;
    (3,2) is the left-only one, because the right half gave its outer thumb key
    to the ball pocket.
    - the right-half key table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
2026-11-07 docs: tenting numbers for tent_deg 18, and the ball is matte
    tent_deg went from 15 to 18 when r2.3 pushed the right half's hinge line to
    -31: the kickstand got shorter, needed a steeper fold, and at 15 degrees the
    outer plate's free end dropped below the desk. Every number derived from it
    stayed behind in prose -- docs/11, hardware/case/README.md,
    issues/mech-case-lid.md, the build guide and the image prompts. From
    stack.json: fold 57.6 right / 43.7 left, stop at half of that, kickstand hangs
    39.6 / 25.7 degrees below the tray, hinge axis 37.8 mm up, reach 34.3 / 53.2
    mm, free end 2.1 / 7.7 mm, foot_dx -49.8 right.
    docs/11 also now says out loud that the right half has only 2.1 mm of free-e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
2026-11-07 docs: board sizes, via and ring counts, CPI, and the missing thumb key
    Both halves have been 121.0 x 86.7 mm since r2.3, but the BOM and the order
    checklist still had the right board at 118 x 80. The edge keep-out ring is
    0.35 mm, not 0.45; the "0.45 mm socket pad bands" figure appears nowhere in the
    generator at all -- the socket pads reach 9.8 mm out and socket_margin 1.1
    keeps them 0.3 mm inside the outline. Stitching vias are 10 left and 9 right,
    not ten per half. res-cpi has been 600 since the 19 mm ball, and the thumb
    pitch is 20.4 mm, not the Keyball's 19.5.
    The firmware docs described a right outer thumb key, which does not exist since
    r2.3. The System layer is reached with a layer-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
2026-11-07 case, cradle: a lens correction, a cable-sized USB opening, measured reach
    lens_shim (default 0) shifts the sensor board along the optical axis so the
    printed lens distance can be corrected without editing lens_z, which is a
    datasheet value. The window is only 2.2 to 2.6 mm and nothing in the design
    adjusted it, while every term that sets it is printed. The bearing seats are
    the sensitive one and they amplify: sitting 35 degrees below the equator, a
    radial seat error d lifts the ball centre by d * cot(35) = 1.43 d, so 0.15 mm
    of seat error is 0.21 mm of lens distance and already out of spec. The README
    acceptance window is now 2.3 to 2.5 mm, because the nominal sat dead centre
    with no bias w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
    [cradle.scad, params.scad, tray-left.stl, tray-right.stl]
2026-11-07 hygiene: unpick ring_polygon, drop the pasted grid-search comments
    ring_polygon built its path twice: the first assignment used `if False else`
    and three chained no-op slices `[::1][::-1][::-1]`, and was overwritten four
    lines later. It worked, but it read as if the slicing mattered. Verified
    behaviour-preserving by running both versions against both board outlines:
    identical point lists, 58 left and 60 right.
    The "Found with the same grid search" comment had been pasted three times in
    the left half's manual_routes and twice in the right half's. Kept the most
    complete one on each side.
2026-11-07 pcb: silkscreen r2.3, hole spacing at the fab's 0.5 mm, naming
    The boards were silkscreened r2 while the geometry has been r2.3 since the ball
    moved inboard. r2 and r2.3 right boards are not interchangeable -- 117.8 x 80.4
    against 121.0 x 86.7 mm, different ball position, different thumb pair -- so
    two incompatible boards carried the same mark. revision and revision_text are
    now r2.3, which also reaches the PCB and schematic title blocks, points-*.json
    and the layout previews.
    min_hole_to_hole goes from 0.25 to 0.5 mm, which is JLCPCB's figure rather than
    KiCad's default. The left board had two pairs below it: a GND via 0.346 mm from
    U1 pad 14, and a router via 0.383 mm from the declared st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
    [k0d3ball35-left-B_Cu.gbr, k0d3ball35-left-B_Mask.gbr, k0d3ball35-left-B_Paste.gbr, k0d3ball35-left-B_Silkscreen.gbr, k0d3ball35-left-Edge_Cuts.gbr, k0d3ball35-left-F_Cu.gbr, k0d3ball35-left-F_Mask.gbr, k0d3ball35-left-F_Paste.gbr]
2026-11-07 tests: tie the drifted numbers back to the generator
    Two gaps let the r2.3 drift happen silently.
    test_silkscreen_texts only asserts that the board title *contains* whatever
    revision_text says, so revision_text could sit at r2 while revision moved to
    r2.3 and nothing complained -- which is how both boards came to be etched with
    the wrong mark. Now revision_text must equal revision.
    Nothing tied a coordinate in a sentence to the generator, so the ball centre,
    J1 and the cradle screws stayed at their pre-r2.3 values in five documents and
    four tickets. test_docs_carry_the_generated_positions reads points-right.json
    and requires each position to appear in the document that documents it, in any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
2026-11-07 tests: match the attribution words case insensitively
    test_no_tool_attribution compared case sensitively, so a lowercase host name
    inside a URL slipped past it. Both sides are lowercased now and the word list
    covers the other common tool names.
2026-11-07 site: the exploded view moves to site/ as the published page
    docs/exploded-view was a document among the specs; it is the one thing in the
    repo meant to be served as a web page, so it gets its own top-level folder that
    GitHub Pages can point at. Only the exploded view lives there for now.
    build.py walked up two levels to the repo root and now walks up one. The page
    and the layout JSON are rebuilt from the new location, byte for byte the same
    geometry. The `make exploded` target, the README, the case doc and the two
    tickets follow the path; docs/11-case.md links out of docs/ with ../site/.
2026-11-07 repo: docs/ is the published page, the specification moves to spec/
    GitHub Pages serves either the repo root or docs/, and nothing else, so the
    folder name is not free: the exploded view takes docs/ and the thirteen
    specification documents move to spec/ with their images. site/, which existed
    for one commit, is gone again.
    Every path reference follows: the Makefile targets, the README repository map
    (which gains a line for docs/), CONTRIBUTING, the hardware and firmware
    READMEs, the tickets, and the sensor schematic's license comment. The tests and
    scripts that build their paths segment by segment - the design spec, the BOM,
    the firmware doc, the logo sources - are rewritten too; those were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
    [common.scad, k0d3ball35-sensor.kicad_sch, logo.scad, logo_data.scad, params.scad]
2026-11-07 docs: an unbranded laptop in the concept render
    The render had an Apple logo on the laptop lid in the background, a trademark
    in a picture that leads the readme. The replacement is the same scene and the
    same camera without it, and the prompt below the image asks for an unbranded
    laptop so a regeneration does not bring the logo back.
2026-11-08 ci: run the ZMK west build in the config workspace
    ZMK's reusable build-user-config.yml runs west from the repository root, while
    `west init -l firmware/zmk-config/config` puts the west topdir at the parent of
    the manifest directory. Every matrix target therefore died with "no west
    workspace found"; nesting a config directory cannot be expressed through that
    workflow's inputs.
    firmware.yml now carries matrix, build, merge and release itself, modelled on
    upstream's steps but with working-directory firmware/zmk-config -- the same
    workspace the local build in spec/05-firmware.md uses. Replayed in
    zmkfirmware/zmk-build-arm:stable at the CI path: all three targets build.
    test_firmware_build_con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
2026-11-08 fw: restore the physical-layout node in k0d3ball35-layouts.dtsi
    gen_physical_layout.py prints the value of the `keys` property only. Commit
    242cbe3 pasted that output over the whole file, so the k0d3ball35_layout node
    that k0d3ball35.dtsi points zmk,physical-layout at was gone and the file began
    with a bare `= <&key_physical_attrs ...>`. Every target failed with a devicetree
    parse error.
    Nothing caught it: test_physical_layout_matches_generator only asserted that the
    generator output appears in the file, which a paste-over satisfies. It now also
    checks the zmk,physical-layout node, the `keys` property, the label referenced
    from k0d3ball35.dtsi and balanced braces. The file comment and spec/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
2026-11-08 ci: install make, zip and python3-venv in the KiCad container
    ghcr.io/kicad/kicad:10.0 is a bare Debian trixie that carries nothing beyond
    KiCad, so kicad-gates died on "make: not found" and kicad-pytest on "ensurepip
    is not available". Both jobs now install what they use: make and zip for the
    gates (scripts/export.sh zips the gerbers), python3-venv for the tests.
    Verified in the same image with the repository mounted: ERC 0 violations on all
    three schematics, DRC 0 violations / 0 unconnected / 0 parity issues on all
    three PCBs, `make gerbers` complete for both halves, `pytest -m kicad` 8 passed.
    infra-ci-hardware is reopened: export.sh takes left|right only, so the gerbers
    artifact still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
2026-11-08 footprints: the MSK-12C02 terminals really are asymmetric
    The r2.3 review flagged PS1's three terminal pads at -2.25 / +0.75 / +2.25 as a
    suspected 1.5 mm misplacement, blocking both main boards. They match KiCad's own
    SW_SPDT_Shouhan_MSK12C02 coordinate for coordinate, and that footprint cites the
    SHOU-HAN MSK12C02 datasheet (LCSC C431540): the asymmetry is the part.
    The comment in footprints.py now carries the citation instead of a warning, NOTICE
    credits the library, and a test pins the three terminals, the four tabs and the two
    locating holes so nobody tidies them onto a symmetric pitch. The physical switch on
    paper moves to hw-main-pcb-review-r1 step 2b, where the parts and the plot me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
2026-11-08 print check: the reach the thumb actually covers, and the height to stack
    mech-thumb-arc-tuning is the only open finding whose fix would be a layout
    change, and this sheet is its test method, so the sheet has to carry the two
    numbers that decide it. The thumb touches the ball's near surface, not its
    centre: each travel line now gets a tick where it crosses the ball circle and a
    legend line for the distance to that crossing (SW33 20.0, SW34 39.39 mm). And
    the motion test needs something as tall as the ball standing on the circle -
    17.1 mm, read from the cradle's own stack.json, so the 25 mm fallback would
    change the sheet by itself.
    Section 3 now names make print-plots instead of a path the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
    [gen_print_check.py]
2026-11-08 print plots: 1:1 part-check sheets on A4, as a make target
    Step 2b of the board review - lay a real socket, slide switch or FFC connector
    on the paper and see whether its legs land on their pads - was a copy-paste
    kicad-cli snippet in the ticket, and it did not work. The generated boards carry
    (paper "A3"), so every exported PDF came out 420 x 297 mm: an A4 printer either
    scales it, which destroys the only property the sheet needs, or clips it. The
    B.Cu layer made it worse by flooding the page with the GND pour.
    make print-plots writes build/print/<half>-{bottom,top}-1to1.pdf instead. The SVG
    exporter's --page-size-mode 2 crops the plot to the board, so it can be re-paged
    onto A4 here at 1: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
    [gen_print_plots.py]
2026-11-08 docs: the two paper sheets are make targets, and what each one settles
    The review ticket's step 2b told the reader to plot from the KiCad GUI and
    carried a kicad-cli snippet that produced A3 pages; both are replaced by make
    print-plots, with the reason the snippet is not coming back written down so it
    is not reinstated. Step 3 moves the FH12-6S check to the top sheet: J1 has been
    on the key side since r2.2, so the mirrored bottom plot never showed it.
    The fabrication checklist gains the plot sheets and the cross-check between the
    two families, the order checklist points its two paper-check rows at the target
    and records that the MSK-12C02 terminal spacing is asymmetric by design, and
    mech-t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
2026-11-10 cradle: optional clip-on ball retainer with two claws away from the thumb
    A ring that sits on a new 45 degree chamfer on the cup rim, two claws 0.4 mm
    off the ball at +-80 degrees (none on the thumb side, 159 degree sector open
    above the rim), four snap fingers into pockets in the cup wall, keyed by two
    finger widths so it only fits one way round. The cup still has nothing above
    its rim and works unchanged without the ring.
    [cradle-19mm-pocket.stl, cradle-25mm-cutout.stl, cradle-25mm-pocket.stl, cradle.scad, params.scad, retainer-19mm.stl, retainer-25mm.stl]
2026-11-10 cradle: retention analysis for the retainer
    Samples the cradle and retainer meshes and flood-fills the configuration space
    of the ball centre: trapped, with how much looseness (grid error subtracted),
    how far the claws stay off the ball at rest and while the ring is pulled off.
    The open cup is the negative control.
2026-11-10 tests: retainer holds the ball, stays off it, fits cradle and case
    The cradle tests no longer forbid a retainer, only claws on the cradle itself.
2026-11-10 site: static tabbed shell, shared 3D viewer, data generators
    docs/ stops being one generated 3.5 MB page. index.html is now a hand-written
    shell with a drawing-set title block and one sheet tab per area (overview,
    explorer, case, trackball, PCBs, keymap, build & BOM); each tab is an ES module
    in docs/js/tabs/ that main.js imports on its first visit.
    The page no longer embeds STLs. docs/js/assets.js resolves a repo path to
    raw.githubusercontent.com on the published site and to the working tree on
    localhost, so the real files are shown and downloaded and nothing can go stale.
    docs/js/viewer.js is the shared viewer (Z-up mm frame, STL and KiCad GLB,
    fit, section plane, wireframe, render on dem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
2026-11-10 docs: the project page has tabs and loads the real files
    README gets a project page section instead of the exploded view one, and the
    case spec and the case README stop saying the page embeds the STLs: it fetches
    them from the repository now, and make site refreshes only the facts it lists.
2026-11-10 explorer: port the exploded view into the Explorer tab
    The old generated page inlined the case STLs as base64; the tab now fetches
    them per half on first use and does the former trimesh transform client-side
    (Y/Z swap, left half mirrored back) with transformGeometry so the winding
    stays outward. Clear colour follows --stage and the themechange event, the
    render loop stops while the tab is hidden, and #explorer/left|right picks
    the half. The controller box cap gets its own material: the old page
    overwrote it with the keycap material through a duplicate key.
2026-11-10 site data: keymap, BOM, status and overview facts generators
    The keymap, build and overview tabs read generated JSON instead of parsing
    markdown and devicetree in the browser. keymap.py maps each binding through the
    shield's matrix transform (col-offset of the right overlay) to a switch on a
    half and labels it; bom.py keeps the tables of spec/03-bom.md with their links;
    status.py lists open tickets via scripts/issues.py and the roadmap steps before
    ordering; site.py adds facts read from the layout, stack, shield and spec files.
2026-11-10 pcbs: export the sensor board as a compact GLB for the page
    The Case and Trackball tabs show the real sensor board next to the cradle.
    scripts/export_site_pcbs.py runs kicad-cli pcb export glb with tracks, pads,
    zones, silkscreen and soldermask, merges KiCad's per-shape primitives per
    material, welds identical vertices (2.7 MB -> 1.5 MB, same triangles) and drops
    the export timestamp so a re-run does not change the file.
2026-11-10 site data: parts manifest of every case and cradle STL
    The Case and Trackball tabs need one list of the printable and display-only
    meshes with their measured size, triangle count, volume and solid mass, the
    print notes from the READMEs and the cradle stack and retention numbers.
    build() fails when an STL in either folder has neither an entry nor an
    exclusion, so a new part cannot silently stay off the page.
2026-11-10 explorer: keep labels on the stage, keep load errors visible, test case parts
    Labels are clamped inside the stage so narrow screens do not cut them off.
    A failed case STL fetch no longer gets overwritten by progress from the
    other files still loading. The new test checks that the module loads and
    places every case_files key from layout.json.
2026-11-10 pcbs: make pcb-3d exports board GLBs and stackable layer SVGs
    The PCBs tab draws the real boards. Per board the target writes a GLB (the
    board meshes without normals, flat shaded, which is exact for extruded copper:
    main boards 12 MB -> 2.8 MB, sensor 0.7 MB) and one SVG per layer (F/B copper,
    silkscreen, mask, Edge.Cuts) plus a filled outline. All SVGs of a board share
    the outline + 1 mm viewBox so they stack, carry currentColor instead of black
    so the page colours them, and have no plot date, so a re-run leaves git clean.
    The help rule now accepts digits in target names so pcb-3d is listed.
2026-11-10 keymap tab: both halves as SVG with layer switcher and combos
    Draws every binding on its real switch position from layout.json, left half
    mirrored so the pinkies point outward, ball on the right half. Layer switch
    keys and the keys held to reach the shown layer are marked in ENIG gold,
    transparent keys show the base legend faintly. Below: what the layer does
    (from spec/05-firmware.md and the trackball listener), the combos, and all
    layers as a table for screen readers. Halves stack under 720 px.
2026-11-10 build tab: parts, checks before ordering, open tickets, guides
    The BOM tables of spec/03-bom.md with a text filter, the roadmap steps before
    ordering as a checklist with done, partly and open, the ticked lines of the
    order checklist, open and in-progress tickets by priority linking to GitHub,
    and the three guides. All of it from bom.json and status.json.
2026-11-10 pcbs: generate pcbs.json with board files, layer stack and facts
    The PCBs tab needs, per board, the repo paths it loads (GLB, layer SVGs,
    renders, STEP, gerber zip, KiCad file), the viewBox all layer SVGs share and
    facts that are read rather than typed: outline size from the exported outline,
    copper layers, thickness, footprint, track and via counts from the board file,
    keys and the ball notch from the layout points, finish from the BOM.
2026-11-10 overview tab: landing sheet with render, spec block, status and sheet index
    The concept render as Fig. 1, labelled as a render since nothing is built.
    Facts as a drawing's spec table with the file each value comes from, the
    order state as numbered notes from status.json, an index of the other sheets
    with counts from the data, licences and the repository. Build tab: BOM tables
    keep a readable width on phones and scroll inside their frame.
2026-11-10 tests: keymap, BOM, status and overview facts of the site data
    Layer names and binding counts against the keymap file, one binding per
    switch through the shield's transform, BOM rows per section against the
    markdown tables, status tickets against scripts/issues.py, and each overview
    fact against the file it names.
2026-11-10 pcbs: mark every drill hole on the copper plots, plated or not
    In black-and-white mode KiCad draws plated holes white but NPTH holes black,
    so the switch and mounting holes came out as solid copper. Each copper layer
    is now plotted with and without holes; the part the hole plot appends is
    recoloured to var(--hole), and the export fails if the two plots stop
    sharing their copper part.
    [export_site_pcbs.py]
2026-11-10 pcbs tab: boards in 3D and as a stacked layer plot
    Left, right and sensor board, each in 3D (the GLB in the shared viewer, top,
    bottom and iso views, a section plane) or as a fab plot: the layer SVGs
    inlined and stacked on a mm grid, coloured per layer, solder mask drawn as the
    board minus its openings, the far side dimmed, pan, wheel and pinch zoom,
    keys, and a mirrored view of the back. The panel lists facts read from the
    board, the parts worth knowing, downloads with sizes and the KiCad renders.
    Missing files show the AssetError text in the stage instead of breaking the
    tab. pcbs.json now carries file sizes for the download buttons.
2026-11-10 tests: pcbs.json files exist, layer SVGs stack, GLBs match the outline
    The PCBs tab stacks the layer SVGs of a board and the Case and Trackball tabs
    place the sensor GLB, so both have to keep one frame: every layer SVG shares
    the viewBox, the GLB is a glTF 2 binary whose board meshes span the outline
    and thickness, neither carries an export date, and make pcb-3d exists.
2026-11-10 case tab: every printed part in the viewer with its measured facts
    One STL at a time from parts.json, grouped by half (one list with a
    right/left switch, since the halves are mirror images), test prints,
    cradle and retainer. The panel gives size, volume, solid PLA mass as an
    upper bound, triangles and mesh state, the print notes, download and
    GitHub links and the OpenSCAD renders that show the part. The stage has
    view presets, wireframe and a section plane whose cut faces are drawn
    flat in the accent colour. Parsed geometry is cached per visit, the
    route is #case/<file stem>.
2026-11-10 trackball tab: the cradle in section with ball, bearings, retainer and sensor board
    The cut through the ball centre is the view that explains the module, so
    it is on by default. The ball and the three 2 mm bearings are drawn from
    stack.json (bearing angle derived from bearing_contact_z), the retainer
    and the sensor board GLB are the real files; the GLB is placed with its
    lens face at sensor_pcb_plane_z and J1 in front of the cable channel. A
    missing GLB only disables its toggle with a quiet note. The panel lists
    the stack heights, the retention results, the files and the renders;
    the route is #trackball/<variant>.
2026-11-10 trackball tab: stand-in for the sensor body and lens, bottom view
    The board GLB has no model for U1, so the section showed an empty
    cutout under the ball. A dark box for the PMW3610 body (board cutout
    size, 0.7 mm proud on the lens side) and a disc up to the lens reference
    plane, both from the stack numbers, show where the optics sit; the panel
    says they are drawn, not exported. A bottom view shows the board and J1
    at the cable slot.
2026-11-10 viewer: fit the narrower field of view, add detach()
    fit() only used the vertical field of view, so on a portrait stage (a phone)
    the sides of a part were cut off; the case and trackball tabs each carried a
    workaround that backed the camera off by the aspect ratio. fit() now takes
    the narrower of the two angles and the workarounds go. detach() removes an
    object without disposing it, for tabs that swap cached models in and out.
2026-11-10 tickets: case STLs mirrored against the boards, sealed bearing seats
    Both found while building the Case and Trackball tabs of the project page.
    The case and cradle are modelled in x outward, y towards the user, z up, which
    is left-handed, so every STL is the mirror image of its board. The exploded
    view hid it because its own axis swap is a reflection too. P0 before any case
    print; the boards are not affected.
2026-11-10 site: overview shows the project stages and blockers, build tab starts with cost, time, tools and the build chapters
2026-11-10 site: show the files, link the markdown; drop the Build & BOM tab, trim overview, case and trackball text
2026-11-10 case, cradle: export in the print frame, the STLs are the real parts now
    The SCAD sources model in the layout frame (x outward, y towards the user, z up), which is
    left-handed; STL and DXF are read right-handed, so every case and cradle part came out as its
    mirror image and the tray would not have taken the board. case.scad and cradle.scad flip y once
    at export, logo.scad mirrors the wordmark back, the preview cameras follow the mirrored scene.
    stack.json and retention.json are unchanged.
    Tests convert back to the layout frame in one place (tests/scad_frame.py); the new
    tests/test_case_handedness.py checks tray, controller box, ball pocket and cable slot against
    the KiCad boards in the prin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
    [box-cap-left.stl, box-cap-right.stl, case.scad, cradle-19mm-pocket.stl, cradle-25mm-cutout.stl, cradle-25mm-pocket.stl, cradle.scad, cutout-25mm.dxf]
2026-11-10 site: content hashes on every URL, no-store preview server
    After the print-frame fix a browser showed the right tray mirrored against the board: it paired
    a cached module of one version with an STL of the other (Pages caches 10 minutes,
    raw.githubusercontent 5, the plain http.server preview by heuristic). build.py now stamps a
    content hash on every stylesheet, module (importmap, so the imports between modules follow),
    data file and fetched repository file (data/versions.json); make site-serve uses
    scripts/site_serve.py with Cache-Control: no-store.
    [site_serve.py]
2026-11-10 site: release stamp in the title block, untested lines next to the downloads
    Like the README's work-in-progress notice, but quiet: a 'Preliminary · untested' stamp in the
    title block of every sheet (it turns to 'Prototype' once the PCB order ticket is done), a short
    note behind it that links the full README notice and the roadmap, and one line next to every
    STL, gerber and board download. Units leave the title block below 1200 px, the stamp shrinks
    to 'untested' on phones.
2026-11-10 site: Japanese and Simplified Chinese, icon buttons in the title block
    English text is the key (docs/js/i18n.js, t()); catalogs in docs/i18n/{ja,zh-CN}.json cover the
    shell, every tab and the data texts. Language from ?lang=, the saved choice or the browser,
    switched in a small menu under a globe button. Facts carry an English template plus params so
    a changed dimension needs no new translation. docs/gen/i18n.py collects the keys;
    tests/test_site.py fails on missing, stale or mismatched entries (build.py --i18n lists them).
    Theme and GitHub are icon buttons now (morphing half disc / sun / moon, the GitHub mark), so the
    title block fits a phone. CJK text falls back to the system Gothic/Hei f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
2026-11-10 share card: the 1200 x 630 image a link to the page unfolds into
    A link to the project page posted anywhere - LinkedIn, Mastodon, Slack, Discord
    - rendered as a bare URL, because the page carried no og:image. Those scrapers
    read the head and stop: no JavaScript, so they never reach the 3D viewer. The
    card is therefore the only part of this project most people will ever see,
    which is why it carries the maker's name.
    make share-card builds it as SVG and rasterises with cairosvg, the path
    gen_print_check.py already uses, so no new dependency. The wordmark comes from
    k0d3.logo, the same source the case engraving and the PCB silkscreen read - the
    artwork is never copied. JPEG rather than PNG: th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
2026-11-11 r2.4: flatter stack — tilted PAW3222 module beside the ball, decoupled pocket, rebuilt retainer
    Keycap top 25.6 -> 20.8 mm, ball top 31.7 -> 23.75 mm, transport 31.7 -> 27.3 mm.
    Sensor board replaced by the PAW3222 purchase module tilted 65 degrees,
    pocket well decoupled from the battery bay, 25 mm variant and cutout mount
    removed. Retainer snap fingers moved into a collar above the rim.
    Known open: test_case.py literals, spec prose, site height, firmware.
    [case.scad, common.scad, cradle-19mm-pocket.stl, cradle-25mm-cutout.stl, cradle-25mm-pocket.stl, cradle.scad, cutout-25mm.dxf, data.scad]
2026-11-11 cradle floor DXF: drop the doubled mirror that put the sleeve on the key side
    floor2d() mirrored the projection itself and then again through the print-frame
    mirror, so the DXF ended up in the layout frame while the STL was in the print
    frame: the footprint leaned towards the keys. test_cradle.py had been written
    against that DXF and agreed with it; it now also checks the lean against the STL.
    test_case.py: the pocket well has to contain the cradle footprint instead of
    equalling it, the 25 mm and ball-window assertions are gone, and the case's
    housing_x/y (well box) is no longer compared with the cradle's (module sleeve).
    [cradle.scad, floor-19mm-pocket.dxf]
2026-11-11 spec 08, build guide: the bought PAW3222 module, r2.4 heights, flush pins over the battery well
2026-11-11 firmware: PAW3222 module on the right half, axis scale for the 65 degree tilt
    - west.yml: sekigon-gonnoc/zmk-driver-paw3222 as a second project, pinned to a commit
    - sensor node: compatible pixart,paw3222, irq-gpios on the old motion pin, same SPI
    pins and chip select; CONFIG_PAW3222 replaces CONFIG_INPUT_PMW3610
    - res-cpi 1444 (driver step 38) and zip_y_scaler 11/26 in every listener list: the
    sensor sees the ball 25 degrees below the equator, so X reads cos 65 of Y
    - left-ball scaffold and check_pins follow the new node
    [check_pins.py]
2026-11-11 fw-cpi-tuning-19mm: starting values for the tilted PAW3222
2026-11-11 bom, order checklist, tickets: PAW3222 module from beekeeb or BOOTH, r2.4 heights, close the sensor stack question
2026-11-11 spec 11: r2.4 heights, pocket footprint, one lid without a ball window
2026-11-11 case and cradle READMEs: r2.4 stack, tilted module, why 65 degrees works, shorter
2026-11-11 spec 01, 02: sensor module interface, J1 at (-20.6, 47.0), r2.4 floors and heights
2026-11-11 firmware spec: PAW3222 driver, res-cpi 1444 and the tilt scaler
2026-11-11 build guide, spec 08, PAW3222 ticket: start CPI and the integrated driver
2026-11-11 readme, roadmap: PAW3222 module, r2.4 heights, no 25 mm fallback
2026-11-11 site: height per half is the top of the ball over the case underside, plus the transport height
    The fact measured the controller box top (18.3 mm), not the keycaps or the ball.
    cap_top_z is read from hardware/case/params.scad (not echoed into stack.json) and
    published in layout.json for the explorer. The site tests compare part bounds with
    the raw mesh bounds and no longer expect the cradle to be symmetric in y (the r2.4
    sensor sleeve sits on one side).
2026-11-11 site: r2.4 prose, keycap top from data, no more sensor board drawing
    The explorer reads the keycap top (11.0 mm) from layout.json instead of a fixed
    +8.9 mm. The stack notes drop the 10 mm deep well, the trackball lede names the
    bought PAW3222 module beside the 19.05 mm ball. The flat PMW3610 board under the
    ball (explorer layer, trackball tab GLB and stand-in) is gone with the sensor PCB.
    Catalogs: changed strings translated, unused ones removed.
2026-11-11 site: keymap reads the sensor from the right overlay; regenerate the page data
2026-11-11 image prompts: tilted module, drop the sensor board and 25 mm prompts
2026-11-11 pcb: re-route both boards for r2.4
    The r2.4 commit carried boards with only the hand routes: the router had been
    skipped because java was not on the PATH, so there were no autorouted tracks
    and no GND pours (tests/test_electrical.py). Re-routed with an explicit JAVA,
    DRC clean, gerbers and fab outputs re-exported.
    [k0d3ball35-left-B_Cu.gbr, k0d3ball35-left-B_Mask.gbr, k0d3ball35-left-B_Paste.gbr, k0d3ball35-left-B_Silkscreen.gbr, k0d3ball35-left-Edge_Cuts.gbr, k0d3ball35-left-F_Cu.gbr, k0d3ball35-left-F_Mask.gbr, k0d3ball35-left-F_Paste.gbr]
2026-11-11 case: take the PCB notch from the layout, not a stale octagon
    common.scad drew the notch as a regular octagon with apothem 15.0 while the
    board has 15.5 and a square corner on the key side. That left a 0.1 mm skin in
    tray and lid and put the pocket wall into the square corner the FFC folds
    through. The test now checks that corner is free instead of counting vertices.
    Also: foot_h as a parameter and desk_z in stack.json, so heights over the desk
    include the feet standing 0.2 mm proud.
    [case.scad, common.scad, lid-folded-right.stl, lid-inner-right.stl, lid-outer-right.stl, lid-right.stl, params.scad, pocket-test-right.stl]
2026-11-11 cradle: open the sleeve at the back so the module can go in; drop the r2.2 cable channel
    The sleeve was closed on every side: the module could not be inserted at all.
    It now slides in along its axis from the back until the board rests on the
    shoulder round the lens window; a strip of Kapton tape holds it. New test sweeps
    the module out of its seat and fails on a closed sleeve.
    The vertical r2.2 FFC channel cut a 6 mm slot through the cup wall on the key
    side for a cable that now leaves the sleeve at the back; removed with its
    parameters. Header comment and the 25 mm variants test are gone too.
    [cradle-19mm-pocket.stl, cradle.scad, params.scad]
2026-11-11 pcb review: J1 against the keycap by what matters, notch apothem from the cradle
    Since the notch grew to 15.5 no J1 position passes check_layout with 0.5 mm to
    the index keycap (best 0.42). The cap floats over it though: skirt at +5.0, FH12
    2.0 mm high, so 3 mm stay free for the lock. The test now asks for that.
    [outline-left.dxf, outline-right.dxf]
2026-11-11 docs: open sleeve and Kapton tape in the build guide and BOM, site heights over the desk
    The keymap generator expands the BALL_TILT macro of the right overlay and keeps
    the tilt scaler out of the per-mode effects; the site reads desk_z, so it shows
    23.75 / 27.3 mm like the spec. spec/06 no longer describes a sensor board.
2026-11-11 mech-ball-height-23mm: print checks for the open sleeve, the lens gauge and two slivers
2026-11-11 site: regenerate for the routed boards and restore six part-label translations
    The catalogs had lost six labels while the boards were unrouted (the PCB tab
    showed 0 copper layers then); they are taken back from main.
2026-11-11 guards: no fab export from an unrouted board, no stale copied facts, no skins
    - scripts/check_routed.py: track count, a filled zone and zero unconnected
    items; build_board.sh runs it after routing and export.sh before every
    export. build_board.sh also stops when java or the freerouting jar is
    missing and no longer swallows a failing route.py.
    - tests/test_case.py: every cradle fact copied into hardware/case/params.scad
    is checked against its source, and the notch must not be a copy at all.
    - tests/test_thin_walls.py: sections every printed part and fails on walls
    under 0.25 mm that stand over several sections (the r2.4 tray skin).
    [check_routed.py]
2026-11-11 layout: bump the design revision to r2.4
    The geometry is r2.4 (flatter stack, PAW3222 module) but the yaml, the README status table and the roadmap heading still said r2.3, so the boards and the project page carried the old revision.
2026-11-11 boards: regenerate and reroute both halves for r2.4
    Schematic title blocks and the front silkscreen title now read r2.4. Both boards routed (left 717, right 764 segments), GND pour filled, ERC and DRC clean with zero unconnected items; gerbers, zips, STEP, renders, PDFs re-exported.
    [k0d3ball35-left-B_Cu.gbr, k0d3ball35-left-B_Mask.gbr, k0d3ball35-left-B_Paste.gbr, k0d3ball35-left-B_Silkscreen.gbr, k0d3ball35-left-Edge_Cuts.gbr, k0d3ball35-left-F_Cu.gbr, k0d3ball35-left-F_Mask.gbr, k0d3ball35-left-F_Paste.gbr]
2026-11-11 site: refresh page data, board GLBs and layer plots for r2.4
    make pcb-3d and make site: site.json and the title-bar fallback read r2.4, the per-layer SVGs and GLBs follow the rerouted boards, the ?v= stamps follow the data.
2026-11-11 case: ball pocket in one piece with the stepped edge, flush cover, lid covers the ball
    r2.4 left the pocket as a rounded block in front of the stepped edge, open
    from above down to the cradle well, and the lid ended at the PCB edge.
    - gen_case.py: case_outline = PCB wall plus the pocket block (cover rebate +
    2 mm wall), closed square so the edge steps at 90 degrees; only fill pieces
    that touch the block are taken, the steps along the keys stay unchanged.
    The block stays right of the lid hinge line.
    - tray: solid to the rim outside the key cavity; only a rectangular opening
    over the cradle (well, cradle circle, cable path) with a 4 mm ledge.
    - pocket_cover: new flush plate (rim_z - 1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
    [case.scad, common.scad, data.scad, floor-right.dxf, lid-folded-right.stl, lid-inner-right.stl, lid-outer-right.stl, lid-right.stl]
2026-11-11 site: Explorer draws the real cradle and the pocket cover
    The Explorer drew the cradle as a box and a disc from stack numbers, long
    after the real r2.4 part had changed shape. The ball half now loads the
    cradle STL (placed on the ball) and the new pocket cover STL like the other
    case parts; the dimension list and the stack note describe the flush cover
    instead of the octagonal notch. ja/zh-CN/ru catalogs updated.
2026-11-11 docs: pocket cover in the case spec, build guide, BOM and case README
2026-11-11 cradle: one body - cup and sleeve tab extruded from one plan
    The cup and the tilted sensor sleeve were two solids, the sleeve clipped by
    the floor, the rim plane and the PCB keep-out, which left a lower foot under
    the PCB, sawtooth faces where the rim chamfer cut into the sleeve and three
    bearing bosses poking out of the skirt.
    The body is now one plan (cup circle plus an 18 mm tab towards the sensor,
    ending 0.3 mm inside the notch octagon with its 45 degree corners), extruded
    from the floor to the rim with one 0.8 mm 45 degree chamfer along the whole
    top edge; on the cup that chamfer is still the retainer seat. The module slot,
    lens cavity, window and FFC notch are cut in as before, the sl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
    [cradle-19mm-pocket.stl, cradle.scad, floor-19mm-pocket.dxf, params.scad]
2026-11-11 docs: cradle footprint, envelope and tight values for the one-piece body
    [k0d3ball35.yaml]
2026-11-11 cradle, case: case screws on the x axis and M2 x 8, clear of the bearing seat and the cup
    Two findings from the cradle rework, both already on main:
    - the screw at layout y -10 ran straight through the 270 degree bearing
    seat (0.56 mm between the axes, 2.25 needed); driving it would have
    pushed the ceramic ball out. The bearings sit at 30/150/270, so the two
    screws move to the x axis through the ball: (-23, 66) and (-3, 66).
    - an M2 x 10 ended 0.9 mm over the PCB plane, where the cup is only 9.28 mm
    in radius: its thread broke 0.28 mm into the ball cavity. M2 x 8 leaves
    6 mm of thread and 0.75 mm of plastic to the cup (case_screw_len).
    tests/test_cradle.py::test_case_screws_miss_t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
    [case.scad, cradle-19mm-pocket.stl, cradle.scad, data.scad, floor-19mm-pocket.dxf, floor-right.dxf, outline-right.dxf, params.scad]
2026-11-11 case: assembly views import the real cradle STL instead of a stand-in
    cradle_dummy drew a cup and a tilted box from four values copied out of the
    cradle params; those copies are gone, test_case checks they stay gone.
    [params.scad, tray.scad]
2026-11-11 export.sh: run the routed-board guard with python3 when there is no venv (CI)
    The hardware workflow runs make gerbers before it creates .venv, so the
    guard added in 00f3b82 failed there with 'No such file or directory'.
2026-11-11 case: pocket cover as a bezel round the ball, retainer clip moved onto the cover
    The cover kept a 26.5 mm hole plus a funnel only so the cup-mounted retainer
    could pass: a 5 mm ring round the ball.
    - pocket_cover: 1.2 mm (underside 3.8, 0.375 over the cup rim), hole
    ball + 2 x 0.75 = 20.55 mm, 0.4 mm top chamfer, no funnel; the cup is out of
    sight and the ball still lifts out. Two 2.4 mm holes for the clip's pins.
    - pocket_clip (optional, stl/pocket-clip-right.stl, centred on the ball): a
    C-ring on the cover with the proven claws (+-80 deg, 0.4 off the ball,
    156 deg open to the thumb) and two split snap pins (0.9 slit, 0.12
    undercut, prong strain 2.2 percent). Lid cavity makes roo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
    [case.scad, common.scad, cradle-19mm-pocket.stl, cradle.scad, lid.scad, params.scad, pocket-clip-right.stl, pocket-cover-right.stl]
2026-11-11 case: PCB guard between the switches, no extra height
    0.8 mm plate on the PCB top (part guard, STL + DXF per half). It fills the
    air under a pressed keycap (skirt +2.0), so rim, keycap top and lid stay
    put. Cut-outs per switch housing, holes over the PCB screw heads, open over
    the controller box, J1/FFC and the cradle; the switch flanges hold it.
    gen_case.py builds the outline as one piece without webs under 1.2 mm.
    [case.scad, common.scad, data.scad, guard-left.dxf, guard-left.stl, guard-right.dxf, guard-right.stl, params.scad]
2026-11-11 docs: PCB guard in the case spec, build guide and assembly order
2026-11-11 site: PCB guard in the explorer and the parts list
2026-11-11 case, site: previews and version stamps after rebasing the guard onto the bezel cover
2026-11-11 case: PCB guard leaves no bare PCB visible from above
    Review found green beside J1, at the thumb screw and along the controller
    box. Screw holes 3.7 (BOM heads max 3.5) instead of 4.4, J1 cut to its
    body and contact tails instead of the courtyard, no cut at the notch, the
    guard runs on under the box cap skirt (skirt now stands on it), square
    corners on grow-back, minimum web 1.0. New test: only fit gaps may show.
    The assembly dummies now include the screw heads and J1.
    [box-cap-left.stl, box-cap-right.stl, common.scad, data.scad, guard-left.dxf, guard-left.stl, guard-right.dxf, guard-right.stl]
2026-11-11 docs: PCB guard covers the PCB up to the parts
2026-11-11 site: J1 on the key side with its tails, PCB screw heads in the explorer
2026-11-11 case: PCB guard outline reproducible across GEOS versions
    CI regenerated data.scad with another shapely/GEOS and simplify() kept
    different points on the screw-hole arcs. Snap to the 0.001 grid instead
    of simplifying; the freshness test compares the guard as geometry and
    everything else byte for byte. Checked against shapely 2.0.6 (GEOS 3.11,
    same geometry) and 2.1.2 (GEOS 3.13, byte-identical).
    [data.scad, guard-left.dxf, guard-left.stl, guard-right.dxf, guard-right.stl]
2026-11-11 site: load repository files from the commit, not the branch
    For a few minutes after a push raw.githubusercontent.com still serves the
    old file under main, and the browser kept those bytes under the new ?v=
    URL: the live page showed the old concept render after it was replaced.
    The page now resolves the branch to its sha before the first tab mounts
    and builds every raw URL from it; without an API answer it falls back to
    the branch as before.
2026-11-11 cradle: sensor module leans to +x, optical window cut towards the sensor
    sensor_az 180 (window azimuth sensor_az + 180, the old -sensor_az was only right at 90/270),
    bearings at 60/180/300, case screws on the y axis. The window cylinder ran along local +z and
    left the cup wall solid in front of the lens since r2.4; it now runs along -z.
    [cradle-19mm-pocket.stl, cradle.scad, floor-19mm-pocket.dxf, params.scad]
2026-11-11 layout: housing and sensor projection lean to +x, case screws on the y axis
    [outline-right.dxf]
2026-11-11 case: pocket opening sized on the cup towards the user, clip pins at +-56 deg
    The right case is 96.5 mm deep instead of 101.5 mm.
    [data.scad, floor-right.dxf, lid-folded-right.stl, lid-outer-right.stl, lid-right.stl, params.scad, pocket-clip-right.stl, pocket-cover-right.stl]
2026-11-11 tests: sensor direction in the lean frame, ray test through the optical window
2026-11-11 docs, site: sensor on +x, ticket mech-sensor-side-x
2026-11-12 cradle: sleeve for the real PAW3222 module
    Board 13.4 x 7.4, full-width 9.06 mm lens body whose face seats on the cavity floor,
    FH19C on the lens side with the cable leaving through a slot in the key-side end wall,
    window slot 4 x 8 mm shifted over both lens apertures. Dimensions from the maker's
    drawing (sekigon-gonnoc/small-mouse-sensor-module); the old 14 x 8 had no source.
    [cradle-19mm-pocket.stl, cradle.scad, floor-19mm-pocket.dxf, params.scad]
2026-11-12 layout: FFC route computed from the cradle, 40 mm cable, module projection 13.4 mm
    [outline-right.dxf]
2026-11-12 case, site: previews and data for the reworked cradle
2026-11-12 tests: real module fit, lens seat, aperture rays, cable exit and route, type A danger
2026-11-12 docs: real module dimensions, 40 mm type B cable, type A reverses VCC and GND
2026-11-12 layout: exported sensor board sits at its offset, not under the ball; site_serve --help
2026-11-12 cradle: lens height 3.45 from the PixArt datasheet; module projection follows
    [cradle-19mm-pocket.stl, params.scad]
2026-11-12 ffc: 50 mm stocked cable with an S-fold slack zone beside J1, module tested against the real PCB outline
2026-11-12 case, site: regenerated for the lens height
2026-11-12 docs: 50 mm type B cable with part numbers, S-fold step, lens height source
2026-11-12 Keep the lid lip clear of the keycaps and drop the stray hinge sliver
    The lip ran 0.45 mm into every keycap along the rows, where the caps end
    0.5 mm inside the PCB edge, so the lid could not seat. It now keeps
    lid_cap_clear from every cap and stands only where there is room.
    New test sections the rendered plates against the keycap footprints.
    [case.scad, common.scad, lid.scad, params.scad]
2026-11-12 Deepen the battery well to 6.5 mm so the cell is never clamped
    The 6.0 mm well was documented as 0.1 + 0.25 + 5.7 + 0.1, which is 6.15.
    The floor under the well goes from 2.0 to 1.5 mm, so the height over the
    desk does not change. Build guide: Kapton over the socket joints.
    [lid-folded-left.stl, lid-folded-right.stl, lid-inner-left.stl, lid-inner-right.stl, lid-left.stl, lid-outer-left.stl, lid-outer-right.stl, lid-right.stl]
2026-11-12 Move two mounting holes off the sockets, thinner cell on the left
    The 6 mm case standoffs sat 0.9 mm inside a hot-swap socket on the left
    board and on the switch side pegs on both: the layout check never looked
    at the PCB underside and treated the chiral socket as mirrored on the left.
    H1/H2 move to (26.75, 12.1) and (26.75, 29.1), standoffs shrink to 5.6 mm,
    the outer corner keeps its rubber foot. Boards rerouted, gerbers exported.
    The left cell lies under the inner column's sockets: LP402025 (4 mm) there,
    since the 6.5 mm well cannot hold 1.85 + 5.7. Battery polarity is printed
    as + / - at J3, the ON label moved onto the board, M2 x 5 is the one screw
    length. New checks: standoffs against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
    [case.scad, data.scad, floor-left.dxf, floor-right.dxf, guard-left.dxf, guard-left.stl, guard-right.dxf, guard-right.stl]
2026-11-12 USB opening for a full Type-C overmold, reset button reachable from outside
    USB: the receptacle sits 1.7 mm behind the wall, so the plug's overmold
    has to enter the opening. It took 5.3 mm; now 13 x 7.1 centred on the
    receptacle, open to the top and closed by a tongue on the cap plate.
    Reset: EVQ-P7A is side actuated, the hole in the floor only reached its
    body. RB1 turns to the inner edge (plunger 0.5 mm inside it) and the case
    gets a 2 mm pin hole in the wall on the plunger axis. Boards rerouted.
    Docs and BOM name the cell per half. Tests section the tray and cap
    through the plug volume and along the reset pin path.
    [box-cap-left.stl, box-cap-right.stl, case.scad, data.scad, floor-left.dxf, floor-right.dxf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]
2026-11-12 Backstop behind the sensor module, print-part checks for every STL
    A rib on the pocket wall stands 0.3 mm behind the module's rear corner,
    so the cable cannot pull it out of focus if the tape lets go.
    New tests: every printed STL is one closed body that fits a 180 mm bed;
    the thin-wall test now looks for anything under one nozzle width and
    covers the lid plates and the guard. That found lip remnants at the hinge
    cut, which are gone.
    [lid-folded-left.stl, lid-folded-right.stl, lid-inner-left.stl, lid-inner-right.stl, lid-left.stl, lid-outer-left.stl, lid-outer-right.stl, lid-right.stl]
2026-11-12 Swap the trackball axes for the sensor at +x, floor backs the sockets
    Firmware: the overlay still did the tilt maths for the sensor at +y. At
    +x the sensor's fast axis is screen X, so BALL_TILT now scales in the
    sensor frame and then swaps the axes. A test ties the swap to the cradle's
    window azimuth. Docs no longer describe PMW3610 properties.
    Case: the key floor rises to 0.25 mm under the hot-swap sockets, because
    the switches go in with the PCB screwed down and nothing else can back a
    socket. Height over the desk is unchanged.
    Order list: 14 feet of the size the recesses take, cover screws, Kapton,
    the type B cable is not optional.
    [params.scad, pocket-test-right.stl, tray-left.stl, tray-right.stl]
2026-11-12 CI renders the printed parts, tickets and docs follow the review
    A second job in tests.yml runs the case and cradle tests in the OpenSCAD
    nightly image; they skipped in every job before. The order ticket covers
    the two boards that exist, new tickets carry what only real parts can
    show (cell plug polarity, first print). Stale numbers in the case README,
    spec/08 and NOTICE corrected; pyproject lists what the scripts import.
    [outline-left.dxf, outline-right.dxf]
2026-11-12 Assembly interference test; controller pocket in the USB wall, hinge ends
    A new test puts the closed half together (printed parts rendered from the
    sources, bought parts as prisms at their maximum size), cuts it every
    0.4 mm and demands that nothing overlaps. It is the check the earlier
    faults all slipped past: each part passed against its own numbers.
    On its first run it found that the controller board, which overhangs the
    main PCB by 0.9 mm, stood 0.7 mm inside the USB wall, and that the end
    knuckles of the lid plates overlapped by 0.2 mm. Both fixed.
    [lid-folded-left.stl, lid-folded-right.stl, lid-inner-left.stl, lid-inner-right.stl, lid-left.stl, lid-outer-left.stl, lid-outer-right.stl, lid-right.stl]
2026-11-12 Tests: cut at every part face, fresh stack.json, axis signs
    Re-introducing the reviewed faults one by one showed five that no test
    noticed: a floor 0.25 mm inside the sockets and a well 0.2 mm short (both
    thinner than the 0.4 mm cut grid), a screw hole too shallow and a floor that
    no longer backs the sockets (asserted on a stale stack.json), and a missing
    axis inversion.
    The interference test now also cuts just inside every horizontal face, no
    longer excuses the screw thread against the tray or the switch core against
    the guard, and its self-check feeds three known faults through the real
    comparison. stack.json is compared with a fresh render.
2026-11-12 Bought parts in the assembly and its interference test, lid clears the cap screws
    Sensor module, FFC, cradle, cover and cap screws, rubber feet and the controller's
    sockets and parts are bodies now: in the case assembly, in the interference test and
    in the Explorer. The test found the box cap's screw heads inside the closed lid; the
    lid skirt gets a relief over each head.
    - cradle: the module's envelope exported to ref/sensor-module.stl
    - ffc_route.path(): the 50 mm cable as it is laid, round the cup, S-fold, flat into J1
    - build guide chapters 11 and 12 carry pictures rendered from the model
    - mesh_tools.section: a ring left open by rounding read a screw hole as solid
    - layout.json takes t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
    [case.scad, cradle.scad, data.scad, lid-folded-left.stl, lid-folded-right.stl, lid-inner-left.stl, lid-inner-right.stl, lid-left.stl]
2026-11-12 Box cap screws countersunk and flush, lid reliefs dropped
    The cap's two M2 x 5 had pan heads standing 1.5 mm proud on the controller box, beside
    the flush pocket cover screws. They are countersunk machine screws now, in 0.7 mm
    sinks in the cap top, into the same boss inserts. The reliefs the lid skirt got for
    the pan heads are gone again.
    - BOM and order checklist: four M2 x 5 countersunk for the caps, ten pan heads for the PCBs
    - interference test, Explorer and the assembly views draw the flat heads
    [box-cap-left.stl, box-cap-right.stl, lid-folded-left.stl, lid-folded-right.stl, lid-inner-left.stl, lid-inner-right.stl, lid-left.stl, lid-right.stl]
2026-11-12 Release workflow: every tag attaches the printed parts as one zip
2026-11-12 PCB test plates and a test ball for the fit check before the PCB order
    [ball-19mm-test-half.stl, case.scad, cradle.scad, data.scad, params.scad, pcb-test-left.stl, pcb-test-right.stl, tray.scad]
