konstantindenerz/k0d3ball35/(notices)

Notices in the files:
hardware/right-pcb/k0d3ball35-right.kicad_pcb:
k0d3ball35 r2.4 CERN-OHL-P-2.0
